Bolagnos/Telemeteria-Bluetooth-Hidronica/Telemetría Hidronica con bluetooth/Photos/IMG_1164.jpg

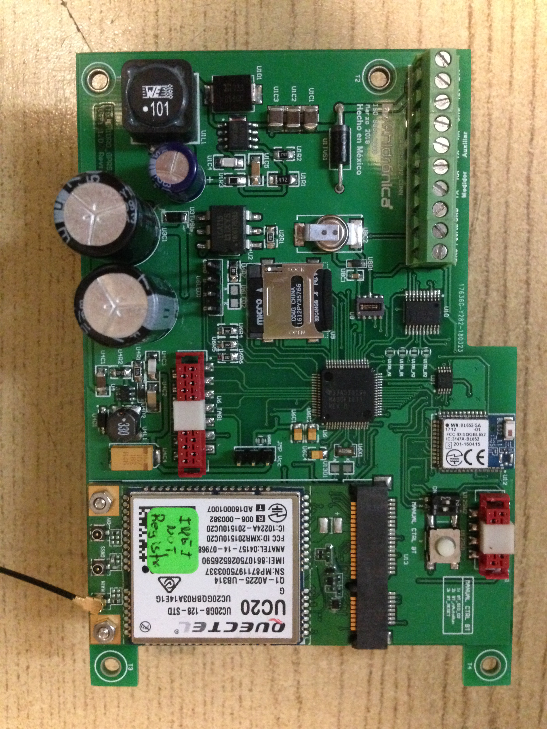
Telemetría Hidronica con bluetooth/Photos/IMG_1164.jpg
