Bolagnos/Telemeteria-Bluetooth-Hidronica/Telemetría Hidronica con bluetooth/Photos/IMG_1166.jpg

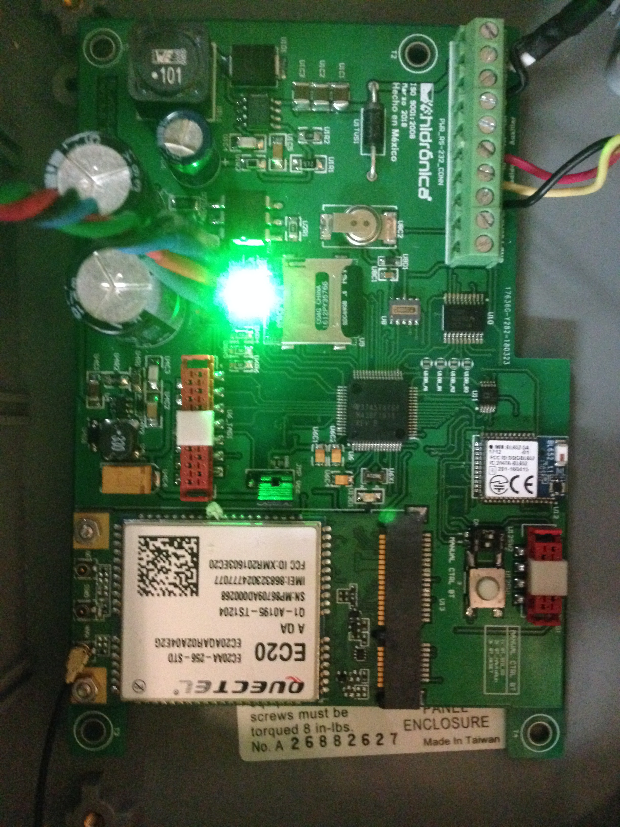
Telemetría Hidronica con bluetooth/Photos/IMG_1166.jpg
