Bolagnos/Telemeteria-Bluetooth-Hidronica/Telemetría Hidronica con bluetooth/Hardware/PCB/Telemetria GPRS Bluetoot MP V1_0 Rev1/Project Outputs for PCB_Tel_GPRS_BT-V1_Rev1/Board Information - TEL-GPRS-BT-V1_0 Rev1.html

Altium customize

# Board Information Report

Date | : | 03/21/2018
Time | : | 11:34:27
Elapsed Time | : | 00:00:00
Filename | : | D:\Documents and Settings\Administrator\Desktop\Telemetria GPRS Bluetoot MP V1_0 Rev1\TEL-GPRS-BT-V1_0 Rev1.PcbDoc
Units | : | mmmils

## Contents

Contents

Board Specification

General

Routing

Routing Information

Layer Information

Layer Information

Layer Pairs

Board Holes

Non-Plated Hole Size

Plated Hole Size

Board Slots

Non-Plated Slot Size

Plated Slot Size

Board Square Holes

Non-Plated Square Hole Size

Plated Square Hole Size

Other

Top Layer Annular Ring Size

Mid Layer Annular Ring Size

Bottom Layer Annular Ring Size

Pad Solder Mask

Pad Paste Mask

Pad Pwr/Gnd Expansion

Pad Relief Conductor Width

Pad Relief Air Gap

Pad Relief Entries

Via Solder Mask

Via Pwr/Gnd Expansion

Track Width

Arc Line Width

Arc Radius

Arc Degrees

Text Height

Text Width

Net Track Width

Net Via Size

## Board Specification

General
Board Size | 117.3012mm x 79.6393mm
Components on board | 129

Back to top

## Routing

Routing Information
Routing completion | 100.00%
Connections | 341
Connections routed | 341
Connections remaining | 0

Back to top

## Layer Information

Layer | Arcs | Pads | Vias | Tracks | Texts | Fills | Regions | ComponentBodies
Top Layer | 0 | 338 | 0 | 680 | 3 | 0 | 428 | 0
Bottom Layer | 0 | 157 | 0 | 514 | 0 | 0 | 388 | 0
Mechanical 1 | 0 | 0 | 0 | 0 | 0 | 0 | 0 | 116
Mechanical 3 | 0 | 0 | 0 | 0 | 0 | 0 | 0 | 0
Mechanical 4 | 0 | 0 | 0 | 0 | 0 | 0 | 0 | 0
Mechanical 5 | 0 | 0 | 0 | 0 | 0 | 0 | 0 | 0
Mechanical 6 | 0 | 0 | 0 | 0 | 0 | 0 | 0 | 0
Mechanical 7 | 0 | 0 | 0 | 0 | 0 | 0 | 0 | 0
Mechanical 8 | 0 | 0 | 0 | 0 | 0 | 0 | 0 | 0
Mechanical 9 | 0 | 0 | 0 | 0 | 0 | 0 | 0 | 0
Mechanical 10 | 0 | 0 | 0 | 0 | 0 | 0 | 0 | 0
Mechanical 11 | 0 | 0 | 0 | 0 | 0 | 0 | 0 | 0
Mechanical 12 | 0 | 0 | 0 | 0 | 0 | 0 | 0 | 0
Mechanical 13 | 2 | 0 | 0 | 24 | 0 | 0 | 0 | 0
Mechanical 14 | 0 | 0 | 0 | 0 | 0 | 0 | 0 | 0
Mechanical 15 | 0 | 0 | 0 | 30 | 0 | 0 | 0 | 0
Mechanical 16 | 0 | 0 | 0 | 0 | 0 | 0 | 0 | 0
Multi-Layer | 0 | 44 | 161 | 0 | 0 | 0 | 1 | 0
Top Paste | 0 | 0 | 0 | 0 | 0 | 0 | 0 | 0
Top Overlay | 35 | 1 | 0 | 1646 | 162 | 0 | 0 | 0
Top Solder | 0 | 0 | 0 | 0 | 0 | 0 | 0 | 0
Bottom Solder | 0 | 0 | 0 | 0 | 0 | 0 | 0 | 0
Bottom Overlay | 10 | 0 | 0 | 390 | 128 | 0 | 0 | 0
Bottom Paste | 0 | 0 | 0 | 0 | 0 | 0 | 0 | 0
Drill Guide | 0 | 0 | 0 | 0 | 0 | 0 | 0 | 0
Keep-Out Layer | 0 | 0 | 0 | 12 | 0 | 0 | 0 | 0
Drill Drawing | 0 | 0 | 0 | 0 | 0 | 0 | 0 | 0
Total | 47 | 540 | 161 | 3296 | 293 | 0 | 817 | 116

Back to top

Layer Pairs | Vias
Top Layer - Bottom Layer | 161
Total | 161

Back to top

## Board Holes

Non-Plated Hole Size | Pads | Vias
0mm | 12 | 0
1.1mm | 1 | 0
1.6mm | 1 | 0
3mm | 4 | 0
Total | 18 | 0

Back to top

Plated Hole Size | Pads | Vias
0mm | 484 | 0
0.25mm | 0 | 159
0.3mm | 9 | 0
0.4mm | 0 | 2
0.7mm | 6 | 0
1mm | 6 | 0
1.2mm | 4 | 0
1.3mm | 10 | 0
1.7mm | 1 | 0
2.6mm | 2 | 0
Total | 522 | 161

Back to top

## Board Slots

Non-Plated Slot Size / Length | Pads
Total | 0

Back to top

Plated Slot Size / Length | Pads
Total | 0

Back to top

## Board Square Holes

Non-Plated Square Hole Size | Pads
Total | 0

Back to top

Plated Square Hole Size | Pads
Total | 0

Back to top

## Other

Top Layer Annular Ring Size | Count
0mm | 4
0.25mm | 153
0.3mm | 9
0.4mm | 3
0.45mm | 5
0.5mm | 4
0.55mm | 1
0.6mm | 6
0.8mm | 2
0.9mm | 10
1mm | 4
1.3mm | 2
3.2mm | 2
Total | 205

Back to top

Mid Layer Annular Ring Size | Count
0mm | 4
0.25mm | 153
0.3mm | 9
0.4mm | 3
0.45mm | 5
0.5mm | 4
0.55mm | 1
0.6mm | 6
0.8mm | 2
0.9mm | 10
1mm | 4
1.3mm | 2
3.2mm | 2
Total | 205

Back to top

Bottom Layer Annular Ring Size | Count
0mm | 4
0.25mm | 153
0.3mm | 9
0.4mm | 3
0.45mm | 5
0.5mm | 4
0.55mm | 1
0.6mm | 6
0.8mm | 2
0.9mm | 10
1mm | 4
1.3mm | 2
3.2mm | 2
Total | 205

Back to top

Pad Solder Mask | Count
0mm | 540
Total | 540

Back to top

Pad Paste Mask | Count
0mm | 540
Total | 540

Back to top

Pad Pwr/Gnd Expansion | Count
0.508mm | 540
Total | 540

Back to top

Pad Relief Conductor Width | Count
0.254mm | 540
Total | 540

Back to top

Pad Relief Air Gap | Count
0.254mm | 540
Total | 540

Back to top

Pad Relief Entries | Count
4 | 540
Total | 540

Back to top

Via Solder Mask | Count
0mm | 161
Total | 161

Back to top

Via Pwr/Gnd Expansion | Count
0.508mm | 161
Total | 161

Back to top

Track Width | Count
0.0254mm | 1317
0.05mm | 4
0.1mm | 46
0.127mm | 25
0.2mm | 121
0.254mm | 84
0.27mm | 935
0.3mm | 34
0.3048mm | 460
0.4mm | 135
0.5mm | 74
0.7mm | 27
1mm | 34
Total | 3296

Back to top

Arc Line Width | Count
0.1mm | 2
0.127mm | 4
0.2mm | 7
0.25mm | 9
0.254mm | 21
0.32mm | 1
0.6mm | 3
Total | 47

Back to top

Arc Radius | Count
0.125mm | 9
0.127mm | 6
0.15mm | 1
0.1625mm | 1
0.25mm | 5
0.3mm | 3
0.3175mm | 2
0.5mm | 2
0.5041mm | 1
0.762mm | 1
0.8mm | 5
3mm | 8
4mm | 1
6.5mm | 2
Total | 47

Back to top

Arc Degrees | Count
90 | 4
180 | 6
360 | 37
Total | 47

Back to top

Text Height | Count
0.5mm | 15
0.7mm | 252
0.8mm | 3
1.5mm | 16
1.524mm | 6
1.7mm | 1
Total | 293

Back to top

Text Width | Count
0.12mm | 10
0.125mm | 1
0.14mm | 1
0.15mm | 252
0.2mm | 23
0.254mm | 6
Total | 293

Back to top

Net Track Width | Count
1916.2949mm | 107
Total | 107

Back to top

Net Via Size | Count
0.5mm | 107
Total | 107

Back to top
