Bolagnos/Telemeteria-Bluetooth-Hidronica/Telemetría Hidronica con bluetooth/Hardware/PCB/USB_Serial Interface/myLibraries/CustomPCBLib.PcbLib.htm

Altium Reporting Options

# File in Newer Format

Date | : | 02/18/19
Time | : | 12:26:04
Filename | : | E:\Trabajo\Logger Tel GPRS MPG2 V_1\Hardware\PCB\USB_Serial Interface\myLibraries\CustomPCBLib.PcbLib

Version | Warning
Release 10 | CAUTION - New Custom Grids and Guides were introduced. Be aware that your design might contain Custom Grids and Guides that cannot be read in previous versions.

This file was generated by a later version of the software
