Bolagnos/Telemeteria-Bluetooth-Hidronica/Telemetría Hidronica con bluetooth/Photos/IMG_1165.jpg

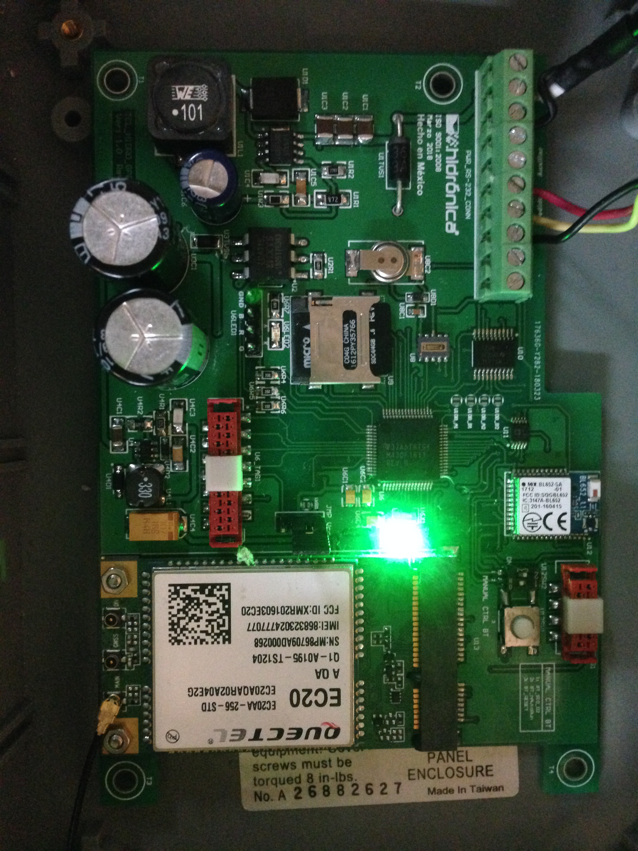
Telemetría Hidronica con bluetooth/Photos/IMG_1165.jpg
