Bolagnos/Telemeteria-Bluetooth-Hidronica/Telemetría Hidronica con bluetooth/Photos/IMG_1167.jpg

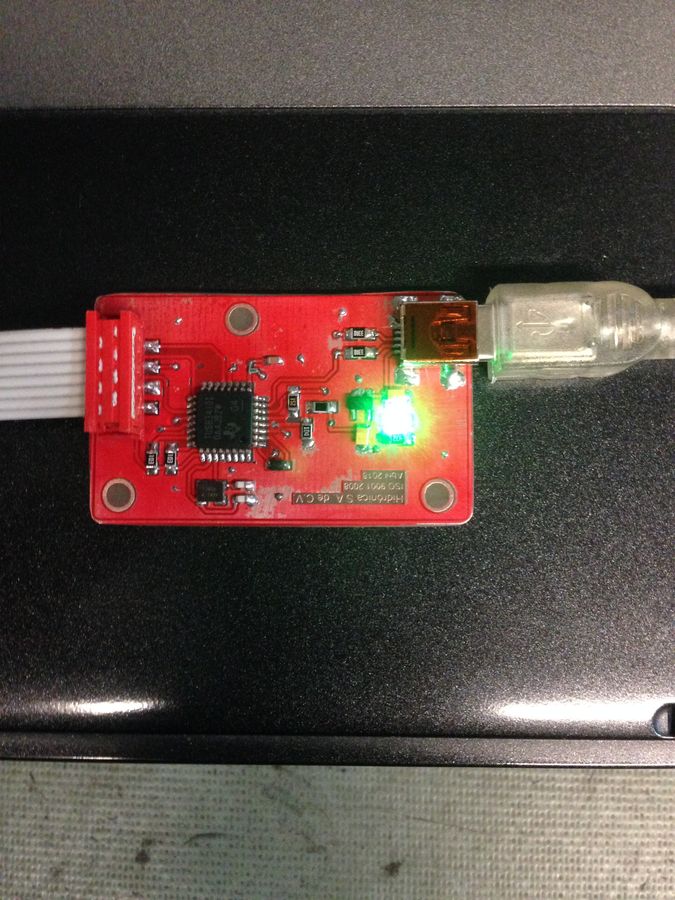
Telemetría Hidronica con bluetooth/Photos/IMG_1167.jpg
