Bolagnos/Telemeteria-Bluetooth-Hidronica/Telemetría Hidronica con bluetooth/Photos/IMG_1168.jpg

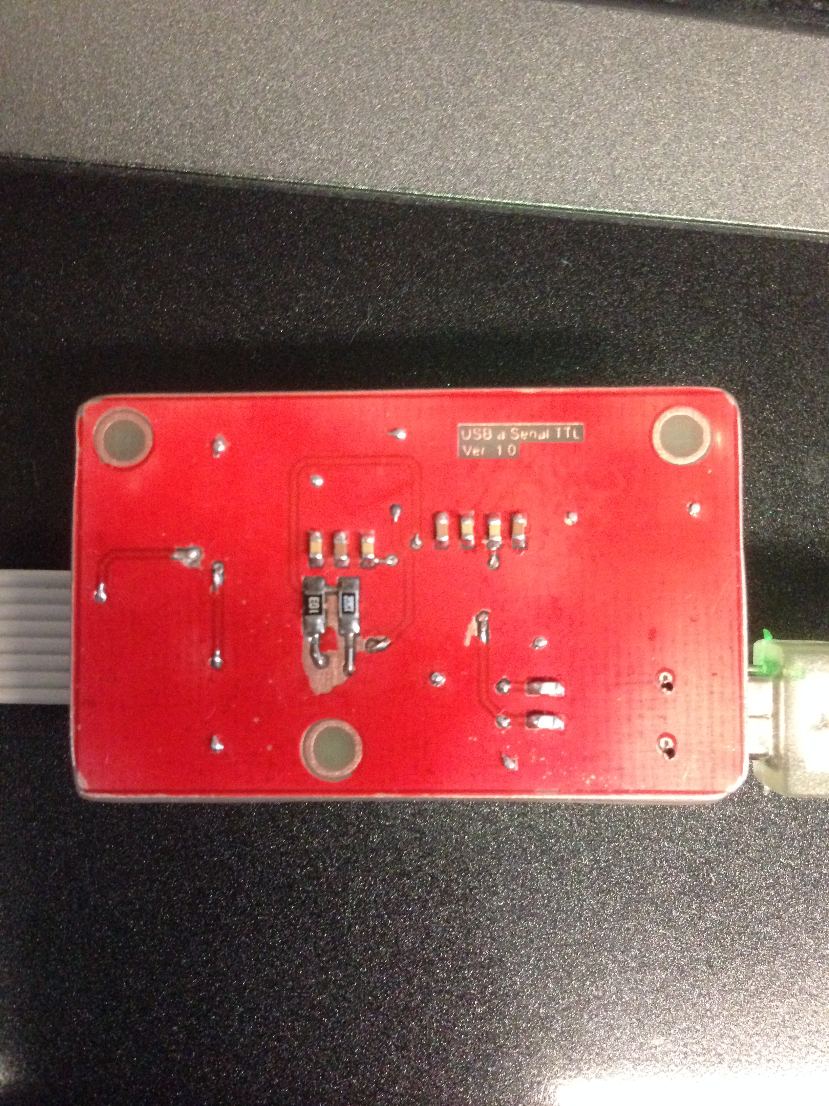
Telemetría Hidronica con bluetooth/Photos/IMG_1168.jpg
