Bolagnos/Telemeteria-Bluetooth-Hidronica/Telemetría Hidronica con bluetooth/Photos/IMG_1169.jpg

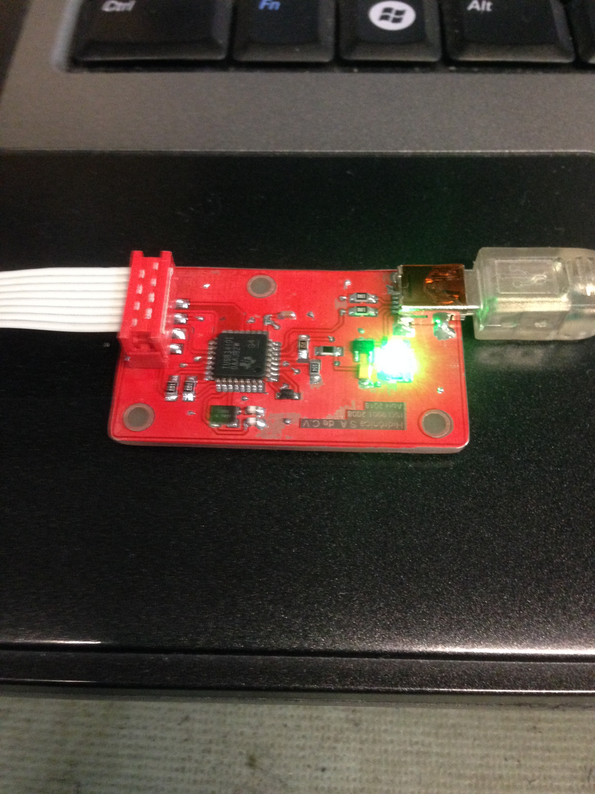
Telemetría Hidronica con bluetooth/Photos/IMG_1169.jpg
