Bolagnos/Telemeteria-Bluetooth-Hidronica/Telemetría Hidronica con bluetooth/Hardware/PCB/Telemetria GPRS Bluetoot MP V1_0 Rev1/Project Outputs for PCB_Tel_GPRS_BT-V1_Rev1/BOM Released/PCB_Tel_GPRS_BT-V1_Rev1.xls

Sheet: Lista de Componentes
Lista de Componentes
Fuente de datos de: |  |  |  |  |  | PCB_Tel_GPRS_BT-V1_Rev1.PrjPcb
Proyecto: |  |  |  |  |  | PCB_Tel_GPRS_BT-V1_Rev1.PrjPcb
Variante: |  |  |  |  |  | None
Fecha de Creacion: |  |  |  |  |  | 03/26/2018
Hora de Creacion: |  |  |  |  |  | 13:25:18
Numero de Equipos:
Manufacturer Part Number | Value | Supplier 1 | Supplier Part Number 1 | Supplier 2 | Supplier Part Number 2 | Supplier 3 | Supplier Part Number 3 | Designator | Description | Quantity | Total Quantity | Total
CHS-02TA |  | Digi-Key | 563-1005-1-ND |  |  |  |  | U12SW2 | SWITCH SLIDE DIP SPST 100MA 6V | 1 | 0 | #REF!
 |  |  |  |  |  |  |  | SP1, SP2, SP3, SP4, T1, T2, T3, T4, U6B1, U10B_A1, U10B_A2, U10B_B1, U10B_B2 | No Aplica | 13 | 0 | #REF!
EVQ-Q2K03W |  | Digi-Key | P12943SCT-ND |  |  |  |  | U12SW1 | SWITCH TACTILE SPST-NO 0.02A 15V SMT | 1 | 0 | #REF!
T491A106K010AT | 10uF | Digi-Key | 399-3684-1-ND |  |  |  |  | U12C1 | CAP TANTALUM 10UF 6.3V 10% SMD | 1 | 0 | #REF!
ERJ-6GEYJ472V | 4.7KO | Digi-Key | P4.7KACT-ND |  |  |  |  | U12R1, U12R2, U12R3, U12R4, U12R5, U12R6, U12R7 | RES SMD 4.7K OHM 5% 1/8W 0805 | 7 | 0 | #REF!
ADG836YRMZ |  | Digi-Key | ADG836YRMZ-ND |  |  |  |  | U11 | IC SWITCH DUAL SPDT 10MSOP | 1 | 0 | #REF!
BL652-SA-01-T/R |  | Digi-Key | BL652-SA-01-CT-ND | Mouser | 239-BL652-SA-01 | Newark | 01AC1558 | U12 | LAIRD BLUETOOTH MODULE (BLE) | 1 | 0 | #REF!
C0603C224K4RAC7867 | 0.22uF | Digi-Key | 399-5619-1-ND |  |  |  |  | U5C1 | CAP CER 0.22UF 16V 10% X7R 0603 | 1 | 0 | #REF!
CL31B224KBFNNNE | 0.22uF | Digi-Key | 1276-1106-1-ND |  |  |  |  | U4C2 | CAP CER 0.22UF 50V 10% X7R 1206 | 1 | 0 | #REF!
ERJ-6ENF1201V | 1.2KO | Digi-Key | P1.20KCCT-ND |  |  |  |  | U2R1 | RES SMD 1.2K OHM 1% 1/8W 0805 | 1 | 0 | #REF!
ERJ-P06J104V | 100KO | Digi-Key | P100KADCT-ND |  |  |  |  | U6R1, U6R3 | RES SMD 100K OHM 5% 1/2W 0805 | 2 | 0 | #REF!
T495D107K016AHE125 | 100uF | Digi-Key | 399-8498-1-ND |  |  |  |  | U4C4 | CAP TANT 100UF 16V 10% 2917 | 1 | 0 | #REF!
CRCW080510M0JNEA | 10MO | Digi-Key | 541-10MACT-ND |  |  |  |  | U5R3 | VISHAY CRCW080510M0JNEA Resistencia SMD Chip, Película Gruesa, 10 Mohm, 150 V, 0805 [2012 Metric], 125 mW, ± 5% | 1 | 0 | #REF!
C1206C100K5GACTU | 10pF | Digi-Key | 399-9297-1-ND |  |  |  |  | U4C3 | CAP CER 10PF 50V 10% NP0 1206 | 1 | 0 | #REF!
CC1210ZKY5V9BB106 | 10uF | Digi-Key | 311-3470-1-ND | Mouser | 603-CC121ZKY5V9BB106 |  |  | U1C1, U1C2, U1C3 | CAP CER 10UF 50V Y5V 1210 | 3 | 0 | #REF!
ERA-6AEB105V | 1MO | Digi-Key | P1MDACT-ND |  |  |  |  | U4R1 | RES SMD 1M OHM 0.1% 1/8W 0805 | 1 | 0 | #REF!
CRCW08051M00FKEA | 1MO | Digi-Key | 541-1.00MCCT-ND | Newark | 52K9759 |  |  | U5R2 | VISHAY CRCW08051M00FKEB Resistencia SMD Chip, Película Gruesa, 1 Mohm, 150 V, 0805 [2012 Metric], 125 mW, ± 1% | 1 | 0 | #REF!
UMK316BJ225KD-T | 2.2uF | Digi-Key | 587-2402-1-ND |  |  |  |  | U4C1 | CAP CER 2.2UF 50V 10% X5R 1206 | 1 | 0 | #REF!
CRCW08052K70FKEA | 2.7KO | Digi-Key | 541-2.70KCCT-ND |  |  |  |  | U1R2 | RES 2.70K OHM 1/8W 1% 0805 SMD | 1 | 0 | #REF!
SMF18A-E3-08 |  | Digi-Key | SMF18A-E3-08CT-ND |  |  |  |  | U3TVS1 | TVS DIODE 18V 29.2V SMF | 1 | 0 | #REF!
DSK-3R3H224U-HL | 220mF | Digi-Key | 604-1020-1-ND |  |  |  |  | U8C2 | CAP 220MF -20% +80% 3.3V SMD | 1 | 0 | #REF!
C1206C221K5GACTU | 220pF | Digi-Key | 399-1208-1-ND |  |  |  |  | U1C4 | CAP CERAMIC 220PF 50V NP0 1206 | 1 | 0 | #REF!
C1206C223K5RACTU | 22nF | Digi-Key | 399-1242-1-ND |  |  |  |  | U1C5 | CAP 22000PF 50V CERAMIC X7R 1206 | 1 | 0 | #REF!
ERA-6AEB3162V | 24KO | Digi-Key | P31.6KDACT-ND |  |  |  |  | U1R3 | RES SMD 31.6K OHM 0805 | 1 | 0 | #REF!
ERJ-6GEYJ332V | 3.3KO | Digi-Key | P3.3KACT-ND |  |  |  |  | U6R4, U6R5, U6R6 | RES SMD 3.3K OHM 5% 1/8W 0805 | 3 | 0 | #REF!
FC-135 32.768KA-A3 |  | Digi-Key | SE2413CT-ND |  |  |  |  | U6X1 | CRYSTAL 32.7680KHZ 12.5PF SMD -40°C ~ 85°C | 1 | 0 | #REF!
P6KE33A |  | Digi-Key | P6KE33ALFCT-ND |  |  |  |  | U1TVS1 | TVS 33 VOLT 600 WATT UNI-DIR TRANZORB | 1 | 0 | #REF!
RC0603JR-07390RL | 390O | Digi-Key | 311-390GRCT-ND |  |  |  |  | U5R4 | YAGEO RC0603JR-07390RL Resistencia SMD Chip, Película Gruesa, Serie RC, 390 ohm, 50 V, 0603 [1608 Metric], 100 mW, ± 5% | 1 | 0 | #REF!
CRCW08054M22FKEA | 4.22MO | Digi-Key | 541-4.22MCCT-ND | Mouser | 71-CRCW08054M22FKEA | Newark | 53K0223 | U5R1 | VISHAY CRCW08054M22FKEA Resistencia SMD Chip, Película Gruesa, 4.22 Mohm, 150 V, 0805 [2012 Metric], 125 mW, ± 1% | 1 | 0 | #REF!
CRCW12064K70JNEA | 4.7KO | Digi-Key | 541-4.7KECT-ND |  |  |  |  | U1R1 | RES 4.7K OHM 1/4W 5% 1206 SMD | 1 | 0 | #REF!
ESY477M050AL3AA | 470uF | Digi-Key | 399-6129-ND |  |  |  |  | U3C1, U3C2 | 470µF 50V Aluminum Capacitors Radial, Can 27 mOhm @ 100kHz 5000 Hrs @ 105°C | 2 | 0 | #REF!
RT0805BRD07604KL | 604KO | Digi-Key | YAG1941CT-ND |  |  |  |  | U4R2 | RES SMD 604K OHM 0.1% 1/8W 0805 | 1 | 0 | #REF!
ERJ-6GEYJ821V | 820O | Digi-Key | P820ACT-ND | Newark | 65T8844 |  |  | U6R7, U13R2 | PANASONIC ELECTRONIC COMPONENTS ERJ-6GEYJ821V Resistencia SMD Chip, Película Gruesa, 820 ohm, 150 V, 0805 [2012 Metric], 125 mW, ± 5% | 2 | 0 | #REF!
CAT24M01WI-GT3 |  | Digi-Key | CAT24M01WI-GT3OSCT-ND |  |  |  |  | U7 | IC EEPROM 1MBIT 1MHZ 8SOIC I2C | 1 | 0 | #REF!
CMDSH-3 TR |  | Digi-Key | CMDSH-3 CT-ND |  |  |  |  | U4D2 | DIODE SCHOTTKY 30V 100MA SOD323 | 1 | 0 | #REF!
DZ2J030M0L |  | Digi-Key | DZ2J030M0LCT-ND |  |  |  |  | U5D1 | PANASONIC ELECTRONIC COMPONENTS DZ2J030M0L DIODE, ZENER, 3.0V, SMINI2-F5-B | 1 | 0 | #REF!
L5973ADTR |  | Digi-Key | 497-5328-1-ND |  |  |  |  | U1 | IC REG SW 2A STEPDOWN 8-SOIC | 1 | 0 | #REF!
LCA715STR |  | Digi-Key | CLA309CT-ND | Mouser | 849-LCA715STR |  |  | U2 | RELAY OPTOMOS 1.8A SPST-NO 6-SMD | 1 | 0 | #REF!
LM1085ISX-3.3/NOPB |  | Digi-Key | LM1085ISX-3.3/NOPBCT-ND |  |  |  |  | U3 | Linear Voltage Regulator IC Positive Fixed 1 Output 3.3V 3A DDPAK/TO-263-3 | 1 | 0 | #REF!
MBR0540-TP |  | Digi-Key | MBR0540TPMSCT-ND |  |  |  |  | U4D1 | DIODE SCHOTTKY 40V 500MA SOD123 | 1 | 0 | #REF!
2041119-1 |  | Digi-Key | A108265CT-ND |  |  |  |  | U13 | Mini PCIe | 1 | 0 | #REF!
MSP430F1611IPM |  | Digi-Key | 296-17205-ND |  |  |  |  | U6 | IC MCU 16BIT 48K FLASH 64-LQFP | 1 | 0 | #REF!
LT1934 |  | Digi-Key | LT1934ES6#TRMPBFCT-ND |  |  |  |  | U4 | LINEAR TECHNOLOGY LT1934 IC REG BUCK ADJ 0.3A SOT23-6 | 1 | 0 | #REF!
SN75C3223EPWR |  | Digi-Key | 296-21078-1-ND |  |  |  |  | U10 | IC LINE DRVR/RCVR RS232 20-TSSOP | 1 | 0 | #REF!
B340-13-F |  | Digi-Key | B340-FDICT-ND |  |  |  |  | U1D2 | DIODE SCHOTTKY 40V 3A SMC | 1 | 0 | #REF!
B560C-13-F |  | Digi-Key | B560C-FDICT-ND |  |  |  |  | U1D1 | DIODE SCHOTTKY 60V 5A SMC | 1 | 0 | #REF!
RC0805JR-0710KL | 10KO | Digi-Key | 311-10KARCT-ND |  |  |  |  | U6R2, U7R1, U7R2, U8R1, U8R2, U8R3, U9R1, U9R2, U9R3, U9R4, U9R5, U9R6, U13R1, U13R3 | 10 kOhms ±5% 0.125W, 1/8W Chip Resistor 0805 | 14 | 0 | #REF!
TAJR105K010RNJ | 1uF | Digi-Key | 478-3278-1-ND |  |  |  |  | U6C1, U6C2, U6C3, U6C4, U12C2 | AVX - TACU105M016X - CAP TANT 1UF, 16V, 7.5OHM, 0805 | 5 | 0 | #REF!
NSR0320MW2T1G |  | Digi-Key | NSR0320MW2T1GOSCT-ND |  |  |  |  | U8D1, U12D1, U12D2 | DIODE SCHOTTKY 1A 20V SOD-323 | 3 | 0 | #REF!
0786463001 |  | Digi-Key | WM9364CT-ND | Mouser | 538-78646-3001 |  |  | U14_A | '6 Position Card Connector Micro SIM Surface Mount, Right Angle Gold | 1 | 0 | #REF!
ERJ-6ENF1502V | 15KO | Digi-Key | P15.0KCCT-ND |  |  |  |  | U14R1 | RES SMD 15K OHM 1% 1/8W 0805 | 1 | 0 | #REF!
ERJ-6ENF22R0V | 22O | Digi-Key | P22.0CCT-ND |  |  |  |  | U14R2, U14R3, U14R4 | RES SMD 22 OHM 1% 1/8W 0805 | 3 | 0 | #REF!
C0805C330J5GACTU | 33pF | Digi-Key | 399-1115-1-ND |  |  |  |  | U14C2, U14C3, U14C4, U14C5 | 33pF 50V Ceramic Capacitor C0G, NP0 0805 (2012 Metric) 0.079" L x 0.049" W (2.00mm x 1.25mm) | 4 | 0 | #REF!
7111S2015X02LF |  | Digi-Key | 609-1401-1-ND |  |  |  |  | U14_B | 6 Position Card Connector SIM Card Surface Mount, Right Angle Gold | 1 | 0 | #REF!
SMF05C.TCT |  | Digi-Key | SMF05CCT-ND |  |  |  |  | U14TVS1 | TVS DIODE 5V 12.5V SC70-6 | 1 | 0 | #REF!
CGJ3E2X7R1E104K080AA | 0.1uF | Digi-Key | 445-8129-1-ND |  |  |  |  | U6C5, U7C1, U8C1, U9C1, U10C1, U10C2, U10C3, U10C4, U10C5, U11C1, U14C1 | CAP CERAMIC 0.1UF, 25V, X7R, 0603 | 11 | 0 | #REF!
RV-3029-C2 |  | Newark | 19P2786 | Mouser | 428-202115-MG01 |  |  | U8 | MICRO CRYSTAL - RV-3029-C2 OPTION B - REAL-TIME-CLOCK, SMD, I2C, 32.768KHZ | 1 | 0 | #REF!
7X-1.8432MBC-T |  | Newark | 29X6515 |  |  |  |  | U6X2 | 7X-1.8432MBC-T - Oscilador, 1.8432 MHz, 100 ppm, SMD, 5mm x 3.2mm, CMOS, 3.3 V, Serie 7X | 1 | 0 | #REF!
ECA-1EM331B | 330uF | Newark | 48W7648 | Mouser | 667-ECA-1EM331B |  |  | U1C6 | Capacitor | 1 | 0 | #REF!
L-154A4SURKQBDZGW |  | Newark | 66W1973 |  |  |  |  | U6LED1 | KINGBRIGHT L-154A4SURKQBDZGW LED, RGB, Rojo, Verde, Azul, Through Hole, T-1 3/4 (5mm), 60 °, Abovedada, R 20mA, G 20mA, B 20mA, Common Cathode | 1 | 0 | #REF!
690 367 290 876 |  | Wurth Elektronik | 690 367 290 876 |  |  |  |  | U12TAG1 | Female SMT Straight Connector with Latch and with Polarization WR-MM 8-Pin | 1 | 0 | #REF!
690 157 001 472 |  | Wurth Elektronik | 690 157 001 472 |  |  |  |  |  | Male IDC Connector 14 POS | 1 | 0 | #REF!
74477020 | 100µH | Wurth Elektronik | 74477020 |  |  |  |  | U1L1 | WE-PD SMD Shielded Power Inductor 100uH | 1 | 0 | #REF!
784774133 | 33µH | Wurth Elektronik | 784774133 |  |  |  |  | U4L1 | WE-PD2A SMD Power Inductor | 1 | 0 | #REF!
613 003 111 21 |  | Wurth Elektronik | 613 003 111 21 |  |  |  |  | JMP Vcc | 2.54mm THT Pin Header WR-PHD 3 terminales | 1 | 0 | #REF!
690 367 291 476 |  | Wurth Elektronik | 690 367 291 476 |  |  |  |  | U6_TAG1 | Female SMT Straight Connector with Latch and with Polarization WR-MM 14-Pin | 1 | 0 | #REF!
74279214 | 450 mO | Wurth Elektronik | 74279214 | Digi-Key | 732-1627-1-ND |  |  | U10L1, U10L2, U10L3, U10L4 | FERRITE BEAD 1000 OHM .20A 1206 | 4 | 0 | #REF!
150080GS75000 |  | Wurth Elektronik | 150080GS75000 | Digi-Key | 732-4983-1-ND | Newark | 95W3800 | U6LED2, U13D1 | WL-SMCW SMD mono-color chip LED waterclear 0805 Green | 2 | 0 | #REF!
691214110002 |  | Wurth Elektronik | 691214110002 | Digi-Key | 732-2747-ND |  |  | PWR_RS-232_CONN A | 2 Position Wire to Board Terminal Block Horizontal with Board 0.200" (5.08mm) Through Hole | 2 | 0 | #REF!
691214110003 |  | Wurth Elektronik | 691214110003 | Digi-Key | 732-2748-ND |  |  | PWR_RS-232_CONN B | 3 Position Wire to Board Terminal Block Horizontal with Board 0.200" (5.08mm) Through Hole | 2 | 0 | #REF!
693072010801 |  | Wuth Elekronik | 693072010801 | Digi-Key | 732-3820-1-ND |  |  | U9 | WR-CRD Micro SD_Hinge / CONN MICRO SD CARD HINGED TYPE | 1 | 0 | #REF!
EC20 mini PCIe |  | Quectel | EC20 miniPCI |  |  |  |  | Modem GSM | Modem GSM/EDGE/GPRS | 1 | 0 | #REF!
CAB.011 |  | Digi-Key | 931-1098-ND |  |  |  |  | Cable Assembly Coaxial SMA to MHF1 Female to Female 1.13mm OD Coaxial Cable 3.74" (95.00mm) |  | 1 | 0 | #REF!
PN-1327-MB |  | Digi-Key | 377-1884-ND |  |  |  |  | 'BOX PLASTIC GRAY 6.73"L X 4.76"W - Box with Mounting Flange Plastic, Polycarbonate Gray Cover Included 6.732" L x 4.764" W (170.99mm x 121.01mm) X 3.150" (80.00mm) |  | 1 | 0 | #REF!
ALPHA1A/2.5M/SMAM/S/S/11 |  | Digi-Key | ALPHA1A/2.5M/SMAM/S/S/11-ND |  |  |  |  | 'ANT BAR SMA MALE ADHESIVE MNT - 868MHz, 900MHz, 915MHz, 950MHz, 1.8GHz, 1.9GHz, 2.1GHz, 2.4GHz Bluetooth, GPRS, GSM, UMTS, WLAN, Zigbee™ Flat Bar RF Antenna 3.8dBi Connector, SMA Male Adhesive |  | 1 | 0 | #REF!
EN3C4FX |  | Digi-Key | SC253-ND |  |  |  |  | 'CONN PLUG 4POS FEMALE CORD #20 - 4 Position Circular Connector Plug, Female Sockets Solder Cup Gold |  | 1 | 0 | #REF!
4304MC |  | Newark | 66F5952 |  |  |  |  | CHICAGO MINIATURE LIGHTING 4304MC Clip para LED, 5.33 mm x 5.33 mm, Negro, Plástico, LEDs Domo Alto T-1 |  | 1 | 0 | #REF!
M26 PRA2MCS100- |  | Newark | 53M8646 |  |  |  |  | DURATOOL M26 PRA2MCS100- Tornillo, M2, Steel, 6 mm, Zinc, Pozidriv Cabeza Alomada |  | 2 | 0 | #REF!
M2- HFA2-S100- |  | Newark | 53M8631 |  |  |  |  | DURATOOL M2- HFA2-S100- Tuerca, Hexagonal, M2, Acero, Recubrimiento de Zinc, Paquete de 100 |  | 2 | 0 | #REF!
Conector Glandula Gris |  |  |  |  |  |  |  |  |  | 3 | 0 | #REF!
53019010 |  | Newark | 26M7490 |  |  |  |  | LAPP KABEL 53019010 Tuerca de Bloqueo, Skintop® GMP-GL, Gris, Nylon, PG9, 5 mm |  | 3 | 0 | #REF!
31622002LPK50 |  | Newark | 10C2404 |  |  |  |  | HUBBELL WIRING DEVICES 31622002LPK50 Tuerca de Bloqueo, No Metálico, Nylon, 3/8 |  | 3 | 0 | #REF!
Tonillo M3 x 25mm. Cabeza hexagonal |  | Casa del Tornillo |  |  |  |  |  | Tornillo M3 con un largo de 25 mm con caneza hezagonal |  | 4 | 0 | #REF!
Tonillo M3 x 10mm. Cabeza hexagonal |  | Casa del Tornillo |  |  |  |  |  | Tornillo M3 con un largo de 10 mm con caneza hezagonal |  | 4 | 0 | #REF!
Tonillo M3 x 8mm. Cabeza hexagonal |  | Casa del Tornillo |  |  |  |  |  | Tornillo M3 con un largo de 8 mm con caneza hezagonal |  | 1 | 0 | #REF!
Tonillo M3 x 5m. Cabeza hexagonal |  | Casa del Tornillo |  |  |  |  |  | Tornillo M3 con un largo de 5 mm con caneza hezagonal |  | 4 | 0 | #REF!
Tuerca M3 de acero inoxidable |  | Casa del Tornillo |  |  |  |  |  | Tuerca M3 de acero inoxidable |  | 22 | 0 | #REF!
 |  |  |  |  |  |  |  |  |  | 190 |  | #REF!
Approved |  |  |  |  |  |  | Notes

Sheet: Informacion del Proyecto
Ruta del Proyecto | D:\Documents and Settings\Administrator\Desktop\Telemetria GPRS Bluetoot MP V1_0 Rev1\PCB_Tel_GPRS_BT-V1_Rev1.PrjPcb
Nombre del Archivo del proyecto | PCB_Tel_GPRS_BT-V1_Rev1.PrjPcb
Nombre del Archivo de datos Fuente | PCB_Tel_GPRS_BT-V1_Rev1.PrjPcb
Ruta Completa del Archivo de Datos Fuente | D:\Documents and Settings\Administrator\Desktop\Telemetria GPRS Bluetoot MP V1_0 Rev1\PCB_Tel_GPRS_BT-V1_Rev1.PrjPcb
Titulo | Bill of Materials For Project [PCB_Tel_GPRS_BT-V1_Rev1.PrjPcb] (No PCB Document Selected)
Cantidad Total | 132
Hora del Reporte | 13:25:18
Fecha del Reporte | 03/26/2018
Hora y Fecha del Reporte | 03/26/2018 13:25:18
Nombre de salida | Bill of Materials
Tipo de Salida | BOM_PartType
Nombre del Generador de Salida | BOM
Descripcion del generador de salida | Bill of Materials
