Bolagnos/Telemeteria-Bluetooth-Hidronica/Telemetría Hidronica con bluetooth/Hardware/PCB/USB_Serial Interface/Project Outputs for USB_Serial Interface/BOM Released/USB_Serial Interface.xls

Sheet: Lista de Componentes
Lista de Componentes
Fuente de datos de: |  |  |  |  |  | USB_Serial Interface.PrjPcb
Proyecto: |  |  |  |  |  | USB_Serial Interface.PrjPcb
Variante: |  |  |  |  |  | None
Fecha de Creacion: |  |  |  |  |  | 03/26/2018
Hora de Creacion: |  |  |  |  |  | 13:33:41
Numero de Equipos:
Manufacturer Part Number | Value | Supplier 1 | Supplier Part Number 1 | Supplier 2 | Supplier Part Number 2 | Supplier 3 | Supplier Part Number 3 | Designator | Description | Quantity | Total Quantity | Total
0603YC102KAT2A | 0.001µF | Digi-Key | 478-7933-1-ND |  |  |  |  | C10, C14 | CAP CER 1000PF 16V X7R 0603 | 2 | 0 | #REF!
C0603C103K4RACTU | 0.01µF | Digi-Key | 399-7841-1-ND |  |  |  |  | C9, C12 | CAP CER 10000PF 16V X7R 0603 | 2 | 0 | #REF!
CGJ3E2X7R1E104K080AA | 0.1uF | Digi-Key | 445-8129-1-ND |  |  |  |  | C1, C8, C11, C13 | CAP CERAMIC 0.1UF, 25V, X7R, 0603 | 4 | 0 | #REF!
ESR10EZPJ152 | 1.5KO | Digi-Key | RHM1.5KKCT-ND |  |  |  |  | R6 | RES SMD 1.5K OHM 5% 0.4W 0805 | 1 | 0 | #REF!
ERA-6AEB104V | 100KO | Digi-Key | P100KDACT-ND |  |  |  |  | R5 | RES SMD 100K OHM 0.1% 1/8W 0805 | 1 | 0 | #REF!
TAJR105K010RNJ | 1uF | Digi-Key | 478-3278-1-ND |  |  |  |  | C6 | CAP TANT 1UF 10V 10% 0805 | 1 | 0 | #REF!
C0603C220K3GACTU | 22pF | Digi-Key | 399-9030-1-ND |  |  |  |  | C4, C5 | CAP CER 22PF 25V C0G/NP0 0603 | 2 | 0 | #REF!
TNPW040232K0BEED | 32KO | Digi-Key | 541-2115-1-ND |  |  |  |  | R2 | RES 32K OHM 0.1% 1/10W 0402 | 1 | 0 | #REF!
06031A330FAT2A | 33pF | Digi-Key | 478-3688-1-ND |  |  |  |  | C2, C3 | CAP CER 33PF 100V C0G/NP0 0603 | 2 | 0 | #REF!
RC0805JR-074K7L | 4.7KO | Digi-Key | 311-4.7KARCT-ND |  |  |  |  | R11 | RES SMD 4.7K OHM 5% 1/8W 0805 | 1 | 0 | #REF!
TAJR475K010RNJ | 4.7uF | Digi-Key | 478-3280-1-ND |  |  |  |  | C7 | CAP TANT 4.7UF 10V 10% 0805 | 1 | 0 | #REF!
NSR0320MW2T1G |  | Digi-Key | NSR0320MW2T1GOSCT-ND |  |  |  |  | D1 | DIODE SCHOTTKY 1A 20V SOD-323 | 1 | 0 | #REF!
RC0805JR-0710KL | 10KO | Digi-Key | 311-10KARCT-ND |  |  |  |  | R3, R9, R10 | 10 kOhms ±5% 0.125W, 1/8W Chip Resistor 0805 | 3 | 0 | #REF!
ERJ-PB6B1502V | 15KO | Digi-Key | P20726CT-ND |  |  |  |  | R1 | RES SMD 15K OHM 0.1% 1/4W 0805 | 1 | 0 | #REF!
RC0805FR-0733RL | 33O | Digi-Key | 311-33.0CRCT-ND |  |  |  |  | R7, R8 | RES SMD 33 OHM 1% 1/8W 0805 | 2 | 0 | #REF!
ERA-6AEB9092V | 90.9KO | Digi-Key | P90.9KDACT-ND |  |  |  |  | R4 | RES SMD 90.9K OHM 0.1% 1/8W 0805 | 1 | 0 | #REF!
TUSB3410IVF |  | Digi-Key | 296-16757-ND |  |  |  |  | U1 | TUSB3410 | 1 | 0 | #REF!
CX3225GB12000P0HPQCC | 12 MHz | Digi-Key | 1253-1168-1-ND |  |  |  |  | X1 | CRYSTAL 12.0000MHZ 18PF SMD | 1 | 0 | #REF!
TPS76933DBVT |  | Newark | 77C1165 | Digi-Key | 296-2760-1-ND |  |  | U2 | Linear Voltage Regulator IC Positive Fixed 1 Output 3.3V 100mA SOT-23-5 | 1 | 0 | #REF!
65100516121 |  | Wurth Elektronik | 65100516121 | Digi-Key | 732-2109-1-ND |  |  | J1 | Mini USB 2.0 Type B SMT Horizontal 5 Contacts WR-COM | 1 | 0 | #REF!
690 367 290 876 |  | Wurth Elektronik | 690 367 290 876 |  |  |  |  | U12TAG1 | Female SMT Straight Connector with Latch and with Polarization WR-MM 8-Pin | 1 | 0 | #REF!
690 157 000 872 |  | Wurth Elektronik | 690 157 000 872 |  |  |  |  |  | Male IDC Connector 8 POS | 2 | 0 | #REF!
150080GS75000 |  | Wurth Elektronik | 150080GS75000 | Digi-Key | 732-4983-1-ND | Newark | 95W3800 | U13D1 | WL-SMCW SMD mono-color chip LED waterclear 0805 Green | 1 | 0 | #REF!
 |  |  |  |  |  |  |  |  |  | 34 |  | #REF!
Approved |  |  |  |  |  |  | Notes

Sheet: Informacion del Proyecto
Ruta del Proyecto | D:\Documents and Settings\Administrator\Desktop\USB_Serial Interface\USB_Serial Interface.PrjPcb
Nombre del Archivo del proyecto | USB_Serial Interface.PrjPcb
Nombre del Archivo de datos Fuente | USB_Serial Interface.PrjPcb
Ruta Completa del Archivo de Datos Fuente | D:\Documents and Settings\Administrator\Desktop\USB_Serial Interface\USB_Serial Interface.PrjPcb
Titulo | Bill of Materials For Project [USB_Serial Interface.PrjPcb] (No PCB Document Selected)
Cantidad Total | 32
Hora del Reporte | 13:33:41
Fecha del Reporte | 03/26/2018
Hora y Fecha del Reporte | 03/26/2018 13:33:41
Nombre de salida | Bill of Materials
Tipo de Salida | BOM_PartType
Nombre del Generador de Salida | BOM
Descripcion del generador de salida | Bill of Materials
