Bolagnos/Telemeteria-Bluetooth-Hidronica/Telemetría Hidronica con bluetooth/Lista IMEI Telemetrías.xls

 | IMEI | Telemetria No. Ser. | id_medidor | fk_id_tubo | fk_id_report | fk_id_email | fk_id_dns | modelo | tipo | no_serie | titulo_correo
 | 353270040003263 | 2201130002 | 4 | 602 | 7 | 1 | 4 | Accusonic | Ultrasonico | x | Prueba GPRS Accusonic 2
5554361199 | 353270040003214 | 2201130001 | 3 | 601 | 7 | 1 | 3 | Accusonic | Ultrasonico | x | Prueba GPRS Accusonic 1
5554334164 | 353270040003057 | 2201130000 | 1 | 600 | 7 | 1 | 2 | Accusonic | Ultrasonico | x | Prueba GPRS Accusonic 0
5520918446 | 353270040003248 | 2001110000 | 2 | 603 | 0 | 2 | 5 | Milltronics OCM III | Ultrasonico | x | Prueba GPRS Milltronics OCM III 0
 | Unkonwn | 2101130001 | 5 | 604 | 1 | 4 |  | MPG2 | Propela | x | Prueba GPRS MPG2 1
 | 353270040003263 | 2001130001 | 6 | 603 | 0 | 2 | 5 | Milltronics OCM III | Ultrasonico | x | Prueba GPRS Milltronics OCM III 1 (Eliminar Registro)
 | Unknown | 2201130003 | 7 | 605 | 7 | 1 | 1 | Accusonic Extra | Ultrasonico | x | Prueba GPRS Accusonic 3 (Eliminar Registro)
5548334651 | 353270042980195 | 2702150002 | 8 | 605 | 1 | 4 |  | MPG2 Batt | Propela | x | Prototipo GPRS V2 Batt MPG2 Pruebas
5548485687 | 353270043085911 | 2801150000 | 9 | 0000 | 1 | 3 |  | AT600 | Ultrasonico | x | AT-600 0 GPRS
5550752453 | 353270043085788 | 2801150001 | 10 | 0001 | 1 | 3 |  | AT600 | Ultrasonico | x | AT-600 1 GPRS
5548454061 | 353270043085507 | 2801150002 | 11 | 0002 | 1 | 3 |  | AT600 | Ultrasonico | x | AT-600 2 GPRS
5578452277 | 861075024034290 | 2702170000 | 12 | 10 | 1 | 3 |  | MPG2 V2 | Propela Silleta | x | GPRS MP V2_0 Nayarit
5578452278 | 868323024781749 | 2702170001 | 13 | 11 | 1 | 3 |  | MPG2 V2 | Propela Silleta | x | GPRS MP V2_1 Nayarit
5578452276 | 861075024033052 | 2702170002 | 14 | 12 | 1 | 6 |  | MPG2 V2 | Propela Silleta | x | RMK GPRS
5578452279 | 868323024783679 | 2702170003 | 15 | 13 | 1 | 5 |  | MPG2 V2 | Propela Silleta | x | La Joya GPRS
 |  | id_dns_client | dns_ip | port_ip | name_client
 |  | 1 | dr025.leeslab.com.mx | 4124 | LeesLab Server DR 025 -4124
 |  | 2 | dr025.leeslab.com.mx | 600 | LeesLab Server DR 025 -600
 |  | 3 | dr025.leeslab.com.mx | 601 | LeesLab Server DR 025 -601
 |  | 4 | dr025.leeslab.com.mx | 602 | LeesLab Server DR 025 -602
 |  | 5 | dr025.leeslab.com.mx | 603 | LeesLab Server DR 025 -603
SIM’s | No. Telefono
 | 5554361199
 | 5554334164
 | 5520918446
 | 5548334651
