Bolagnos/Telemeteria-Bluetooth-Hidronica/Telemetría Hidronica con bluetooth/Hardware/Gabinete PN-1327-MB/Conector glandula/PG9/assem glandula1.SLDASM

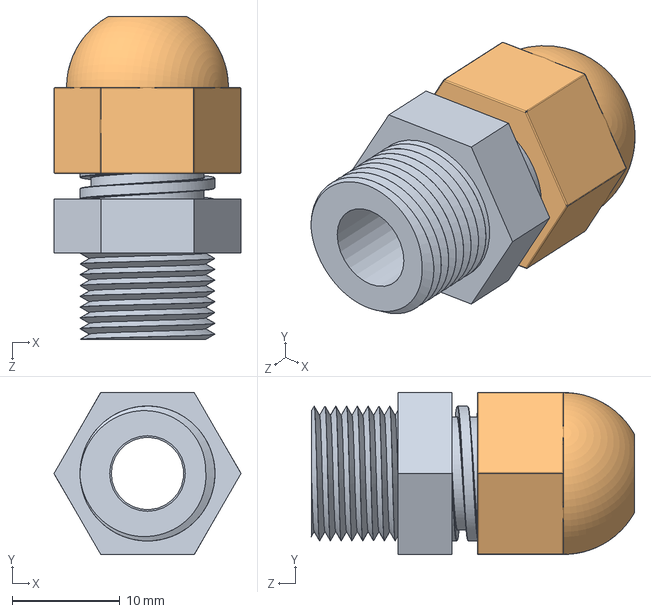
[picture p7: CAD file, 2020-08-14]
Telemetría Hidronica con bluetooth/Hardware/Gabinete PN-1327-MB/Conector glandula/PG9/assem glandula1.SLDASM
17.3 x 15.0 x 29.9 mm
PG07_1
PG07_2
