Bolagnos/Telemeteria-Bluetooth-Hidronica/Telemetría Hidronica con bluetooth/Hardware/Gabinete PN-1327-MB/Conector glandula/assem glandula1 con cable.SLDASM

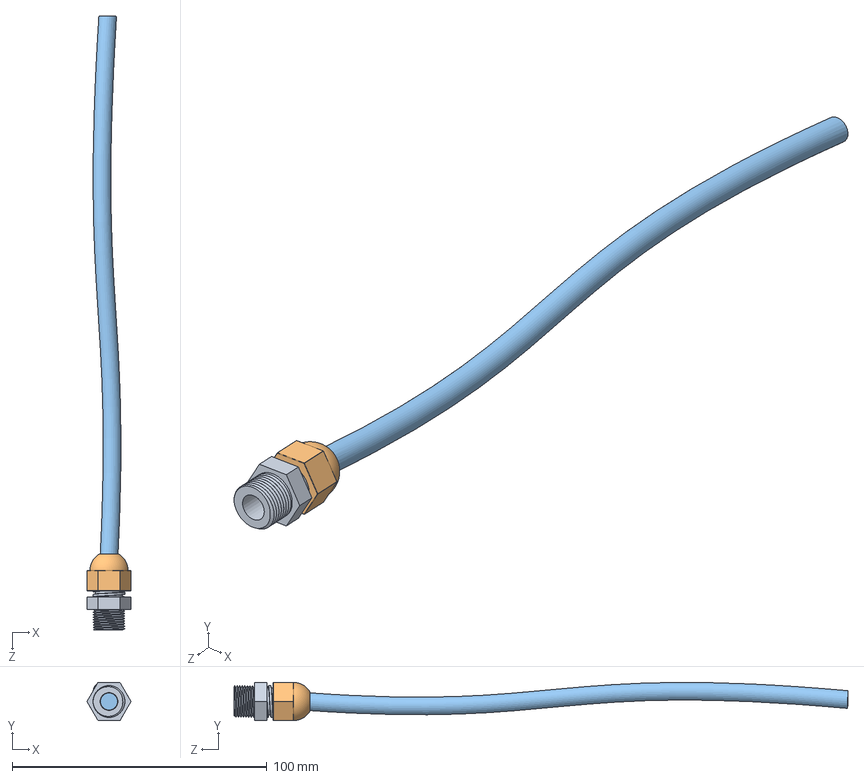
[picture p8: CAD file, 2020-08-14]
Telemetría Hidronica con bluetooth/Hardware/Gabinete PN-1327-MB/Conector glandula/assem glandula1 con cable.SLDASM
17.3 x 15.0 x 241.1 mm
PG07_1
PG07_2
cable antena
