Bolagnos/Telemeteria-Bluetooth-Hidronica/Telemetría Hidronica con bluetooth/Hardware/Gabinete PN-1327-MB/Assemble.SLDASM

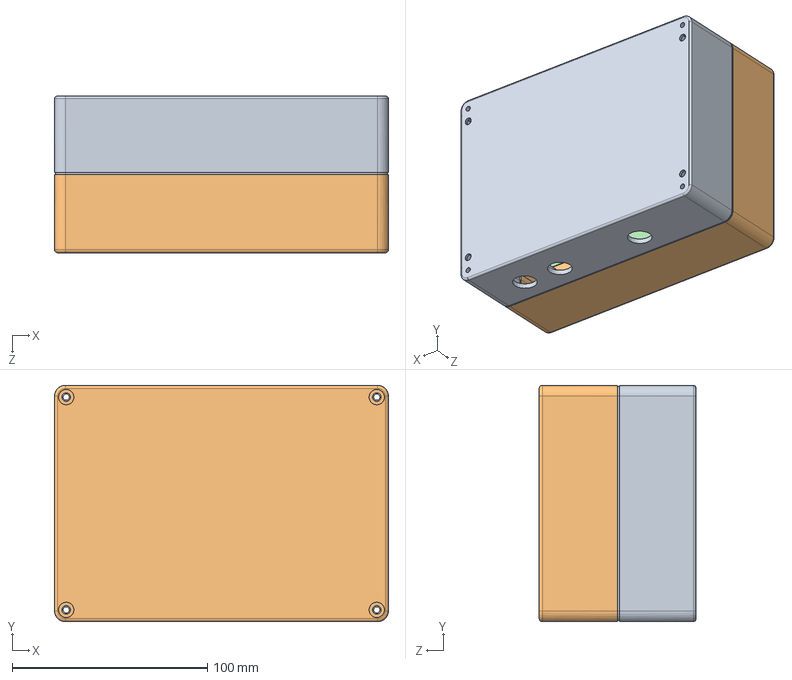
[picture p9: CAD file, 2020-08-14]
Telemetría Hidronica con bluetooth/Hardware/Gabinete PN-1327-MB/Assemble.SLDASM
171.0 x 121.0 x 80.2 mm
Base
Support antenna connector
Board
Battery_Pack
Base_I
