Bolagnos/Telemeteria-Bluetooth-Hidronica/Telemetría Hidronica con bluetooth/Hardware/Gabinete PN-1327-MB/Base_I.SLDPRT

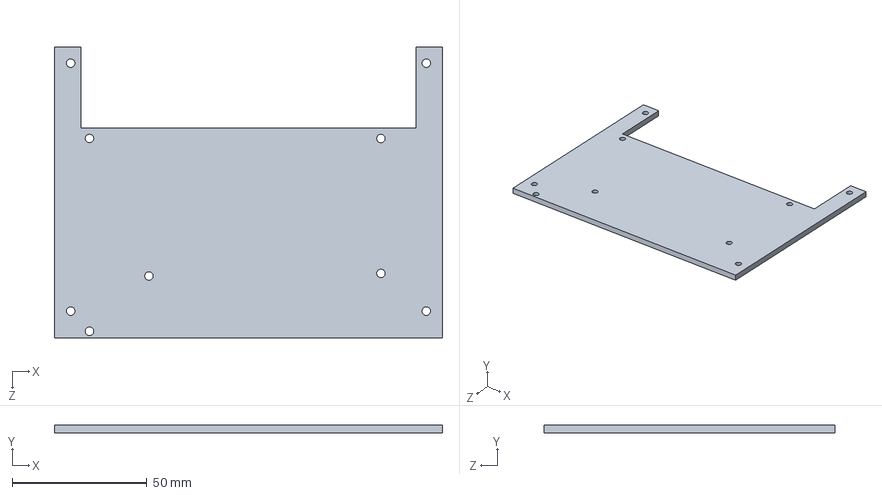
[picture p10: CAD file, 2020-08-14]
Telemetría Hidronica con bluetooth/Hardware/Gabinete PN-1327-MB/Base_I.SLDPRT
143.8 x 3.00 x 107.8 mm
