Bolagnos/Telemeteria-Bluetooth-Hidronica/Telemetría Hidronica con bluetooth/Hardware/Gabinete PN-1327-MB/Conector glandula/PG7/PG7 Cable Gland.stp

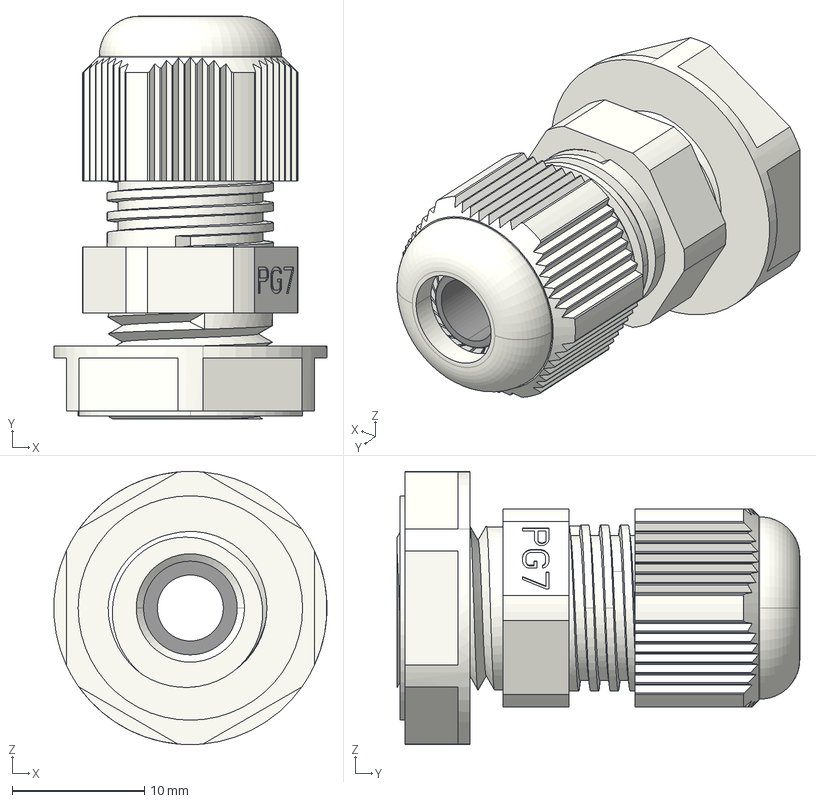
[picture p11: CAD file, 2020-08-14]
Telemetría Hidronica con bluetooth/Hardware/Gabinete PN-1327-MB/Conector glandula/PG7/PG7 Cable Gland.stp
20.7 x 30.5 x 20.7 mm
