Bolagnos/Telemeteria-Bluetooth-Hidronica/Telemetría Hidronica con bluetooth/Hardware/Gabinete PN-1327-MB/Conector glandula/PG9/PG09_1.SLDPRT

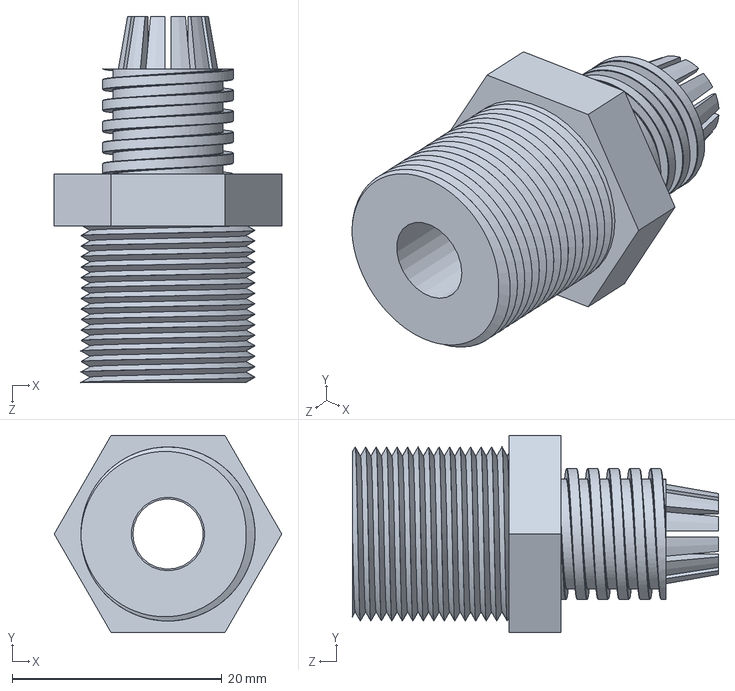
[picture p12: CAD file, 2020-08-14]
Telemetría Hidronica con bluetooth/Hardware/Gabinete PN-1327-MB/Conector glandula/PG9/PG09_1.SLDPRT
21.7 x 18.8 x 34.9 mm
