Bolagnos/Telemeteria-Bluetooth-Hidronica/Telemetría Hidronica con bluetooth/Hardware/Gabinete PN-1327-MB/Conector glandula/S2138-NPT3-4_1.SLDPRT

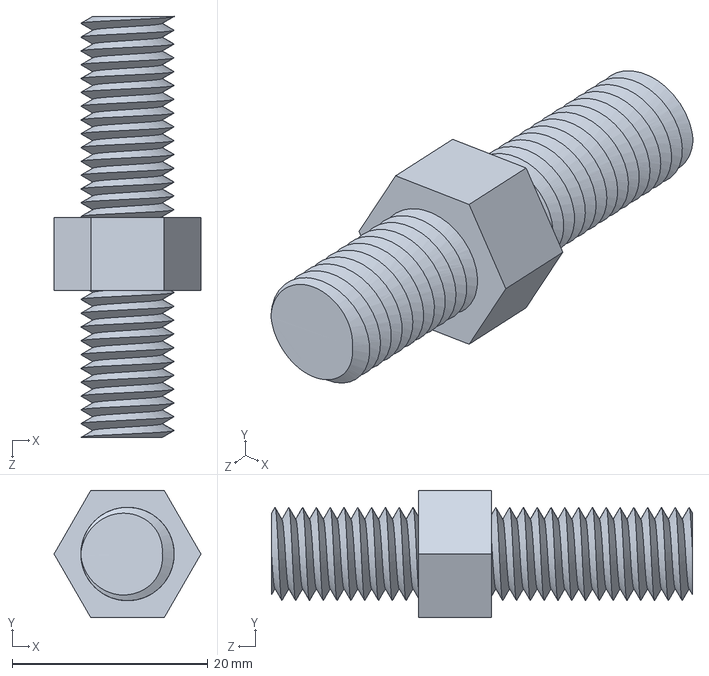
[picture p13: CAD file, 2020-08-14]
Telemetría Hidronica con bluetooth/Hardware/Gabinete PN-1327-MB/Conector glandula/S2138-NPT3-4_1.SLDPRT
15.0 x 13.0 x 43.0 mm
