Bolagnos/Telemeteria-Bluetooth-Hidronica/Telemetría Hidronica con bluetooth/Hardware/PCB/Telemetria GPRS Bluetoot MP V1_0 Rev1/Local Library/BL652 3D Device/BL652 A1 Pad.SLDPRT

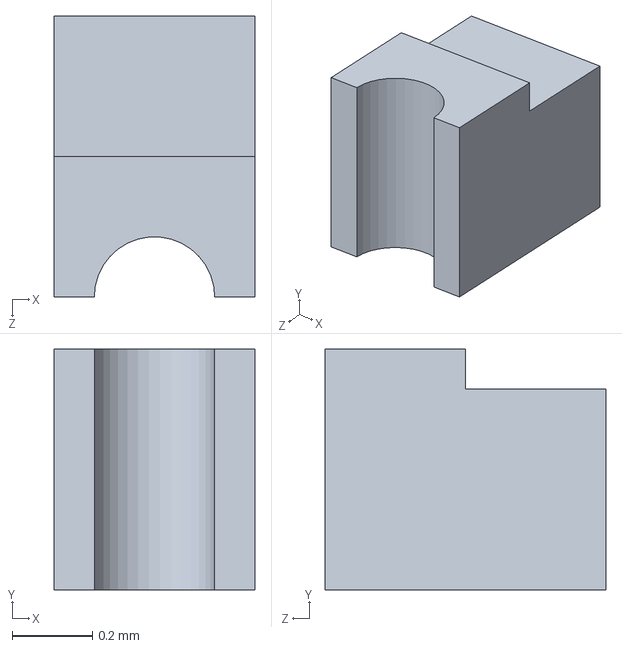
[picture p14: CAD file, 2020-08-14]
Telemetría Hidronica con bluetooth/Hardware/PCB/Telemetria GPRS Bluetoot MP V1_0 Rev1/Local Library/BL652 3D Device/BL652 A1 Pad.SLDPRT
0.5 x 0.6 x 0.7 mm
