Bolagnos/Telemeteria-Bluetooth-Hidronica/Telemetría Hidronica con bluetooth/Hardware/PCB/USB_Serial Interface/myLibraries/BL652 3D Device/BL652 Antenna.SLDPRT

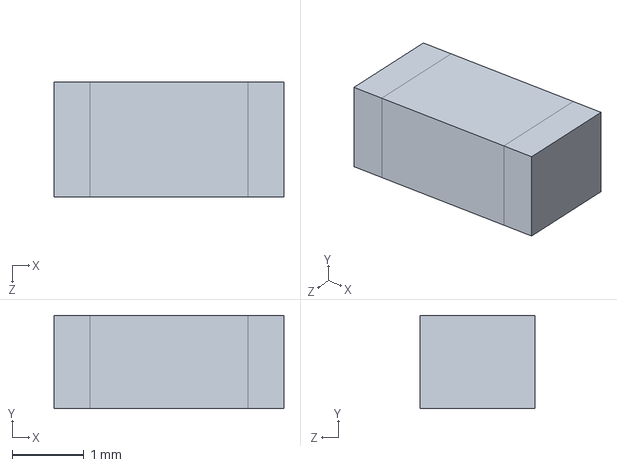
[picture p15: CAD file, 2020-08-14]
Telemetría Hidronica con bluetooth/Hardware/PCB/USB_Serial Interface/myLibraries/BL652 3D Device/BL652 Antenna.SLDPRT
3.20 x 1.30 x 1.60 mm
