Bolagnos/Telemeteria-Bluetooth-Hidronica/Telemetría Hidronica con bluetooth/Hardware/Gabinete PN-1327-MB/Electronic Parts/BL652_SA_A1.SLDPRT

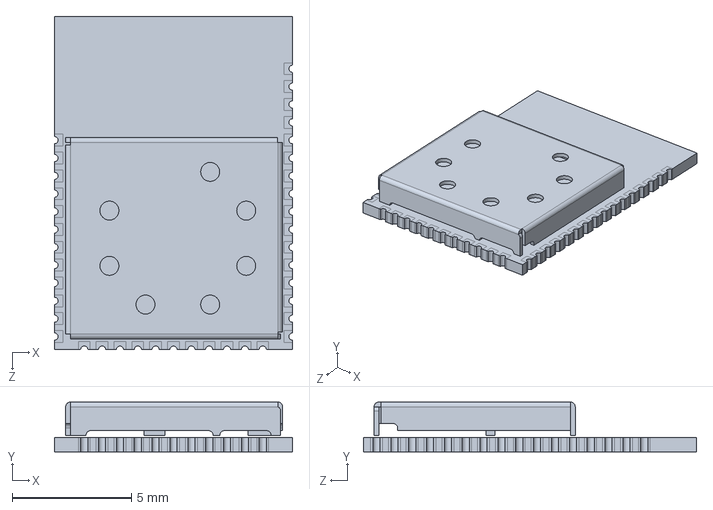
[picture p16: CAD file, 2020-08-14]
Telemetría Hidronica con bluetooth/Hardware/Gabinete PN-1327-MB/Electronic Parts/BL652_SA_A1.SLDPRT
10.0 x 2.10 x 14.0 mm
