Bolagnos/Telemeteria-Bluetooth-Hidronica/Telemetría Hidronica con bluetooth/Hardware/Gabinete PN-1327-MB/Support antenna connector.SLDPRT

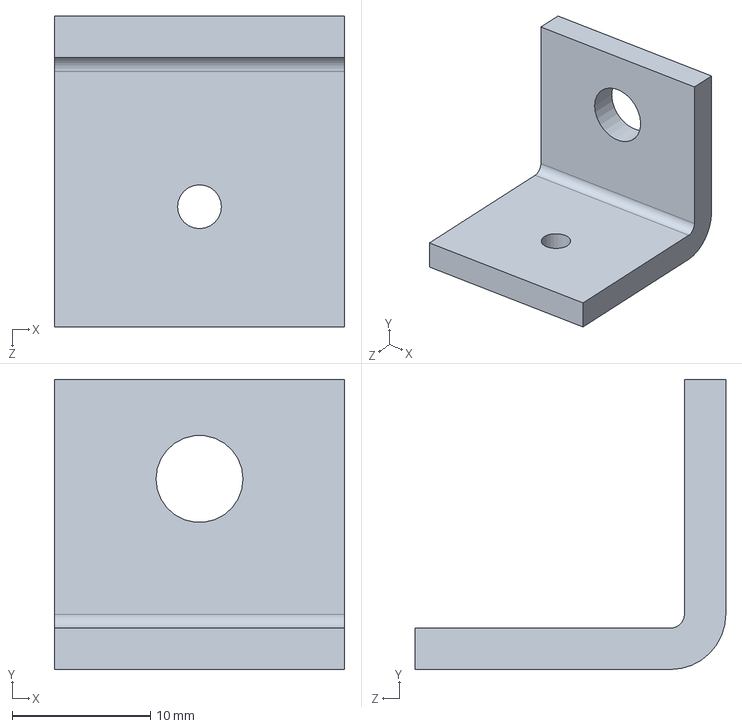
[picture p17: CAD file, 2020-08-14]
Telemetría Hidronica con bluetooth/Hardware/Gabinete PN-1327-MB/Support antenna connector.SLDPRT
21.0 x 21.0 x 22.5 mm
