Bolagnos/Telemeteria-Bluetooth-Hidronica/Telemetría Hidronica con bluetooth/Hardware/Gabinete PN-1327-MB/Conector glandula/PG9/PG09_2.SLDPRT

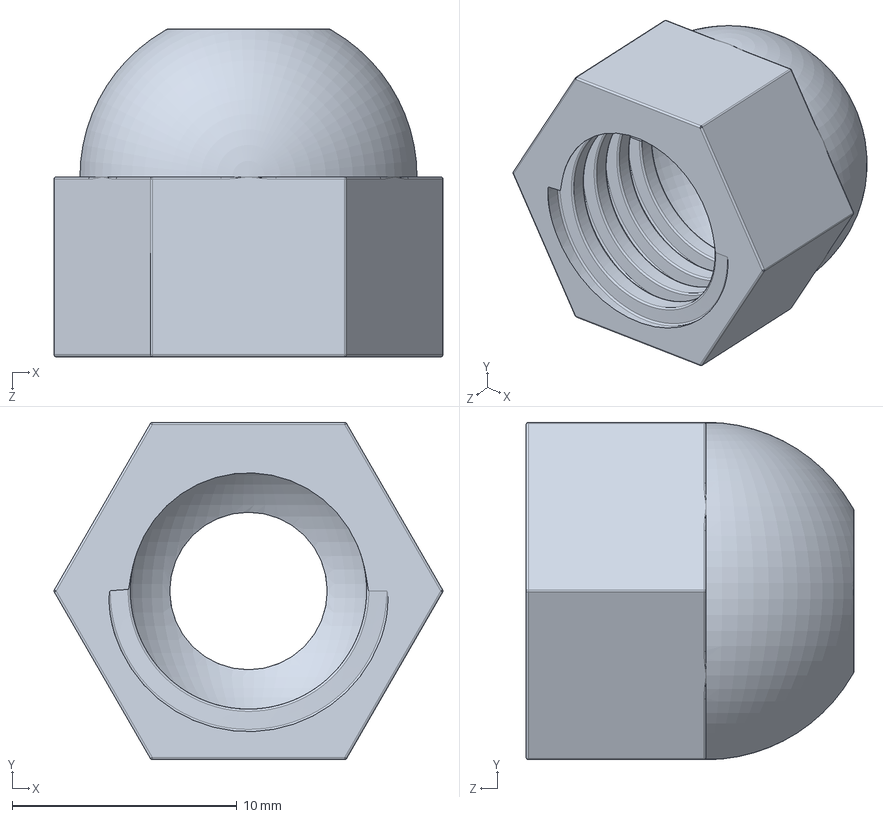
[picture p18: CAD file, 2020-08-14]
Telemetría Hidronica con bluetooth/Hardware/Gabinete PN-1327-MB/Conector glandula/PG9/PG09_2.SLDPRT
17.3 x 15.0 x 14.6 mm
