Bolagnos/Telemeteria-Bluetooth-Hidronica/Telemetría Hidronica con bluetooth/Hardware/Gabinete PN-1327-MB/Electronic Parts/Board.sldprt

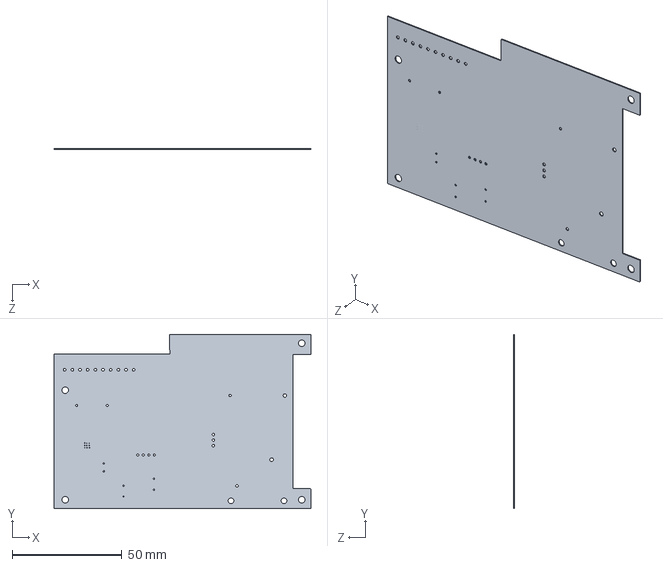
[picture p19: CAD file, 2020-08-14]
Telemetría Hidronica con bluetooth/Hardware/Gabinete PN-1327-MB/Electronic Parts/Board.sldprt
117.3 x 79.7 x 0.411 mm
