Bolagnos/Telemeteria-Bluetooth-Hidronica/Telemetría Hidronica con bluetooth/Hardware/PCB/Telemetria GPRS Bluetoot MP V1_0 Rev1/Local Library/BL652 3D Device/BL652_SA_A1.STEP

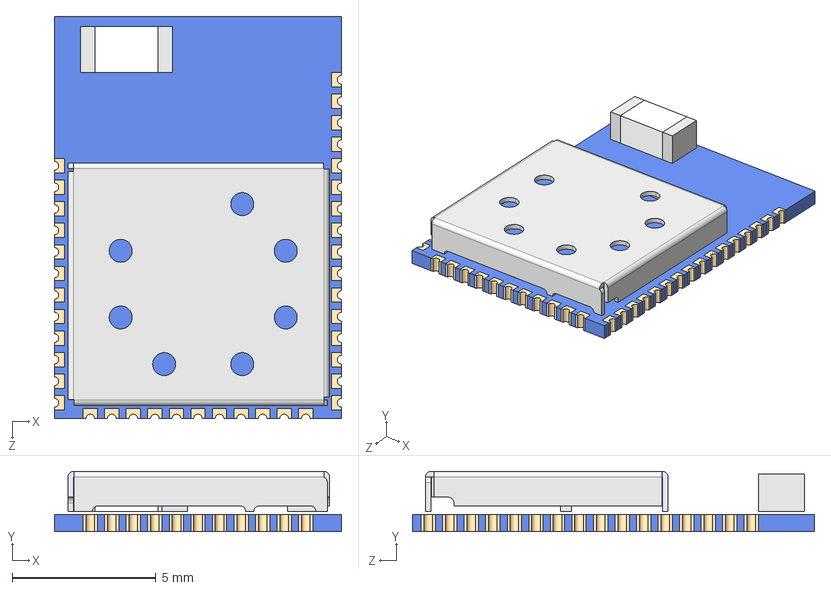
[picture p21: CAD file, 2020-08-14]
Telemetría Hidronica con bluetooth/Hardware/PCB/Telemetria GPRS Bluetoot MP V1_0 Rev1/Local Library/BL652 3D Device/BL652_SA_A1.STEP
10.0 x 2.10 x 14.0 mm
BL652 A1 PCB
BL652 A1 Pad x 39
shielding_bl652_b0_20160622
BL652 Antenna
