Bolagnos/Telemeteria-Bluetooth-Hidronica/Telemetría Hidronica con bluetooth/Hardware/PCB/USB_Serial Interface/myLibraries/BL652 3D Device/BL652 A1 PCB.SLDPRT

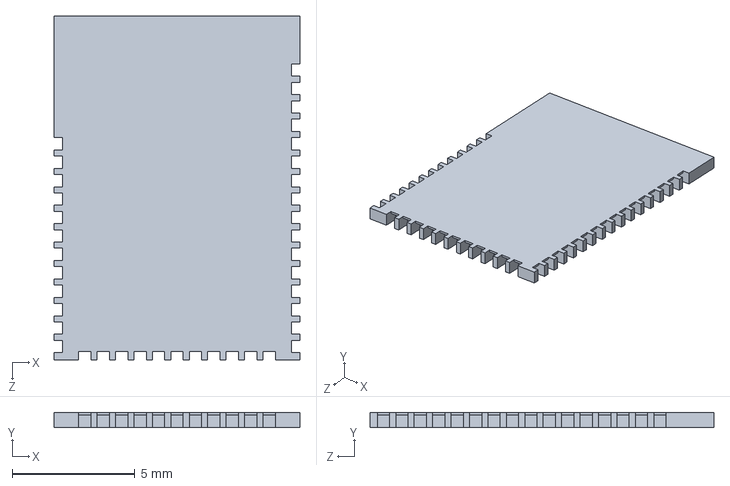
[picture p22: CAD file, 2020-08-14]
Telemetría Hidronica con bluetooth/Hardware/PCB/USB_Serial Interface/myLibraries/BL652 3D Device/BL652 A1 PCB.SLDPRT
10.0 x 0.6 x 14.0 mm
