Bolagnos/Telemeteria-Bluetooth-Hidronica/Telemetría Hidronica con bluetooth/Hardware/Gabinete PN-1327-MB/Battery_Pack.SLDPRT

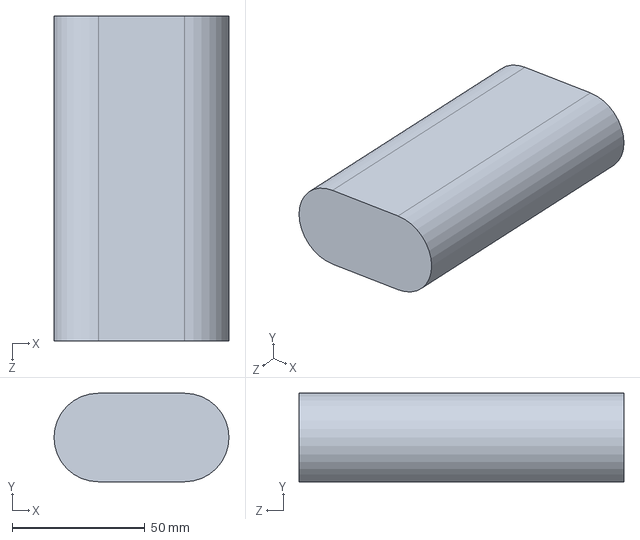
[picture p23: CAD file, 2020-08-14]
Telemetría Hidronica con bluetooth/Hardware/Gabinete PN-1327-MB/Battery_Pack.SLDPRT
66.0 x 33.4 x 122.5 mm
