Bolagnos/Telemeteria-Bluetooth-Hidronica/Telemetría Hidronica con bluetooth/Hardware/PCB/Telemetria GPRS Bluetoot MP V1_0 Rev1/Local Library/BL652 3D Device/shielding_bl652_b0_20160622.SLDPRT

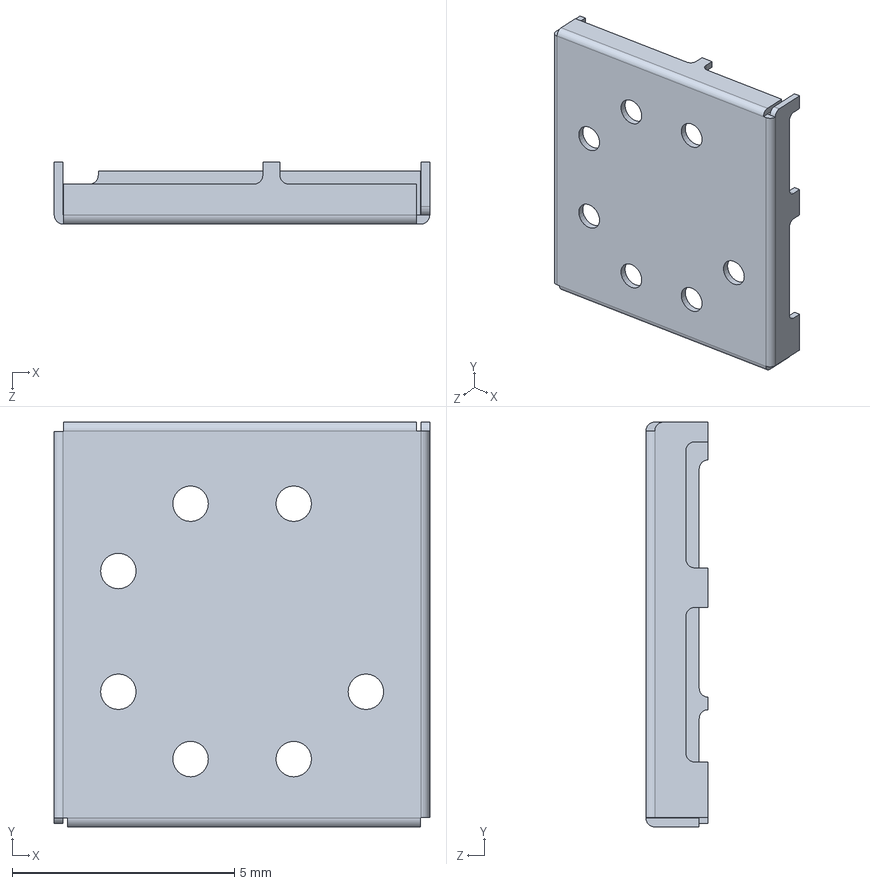
[picture p24: CAD file, 2020-08-14]
Telemetría Hidronica con bluetooth/Hardware/PCB/Telemetria GPRS Bluetoot MP V1_0 Rev1/Local Library/BL652 3D Device/shielding_bl652_b0_20160622.SLDPRT
8.45 x 9.12 x 1.40 mm
