Bolagnos/Telemeteria-Bluetooth-Hidronica/Telemetría Hidronica con bluetooth/Hardware/Gabinete PN-1327-MB/Suppor Base Transversal.SLDPRT

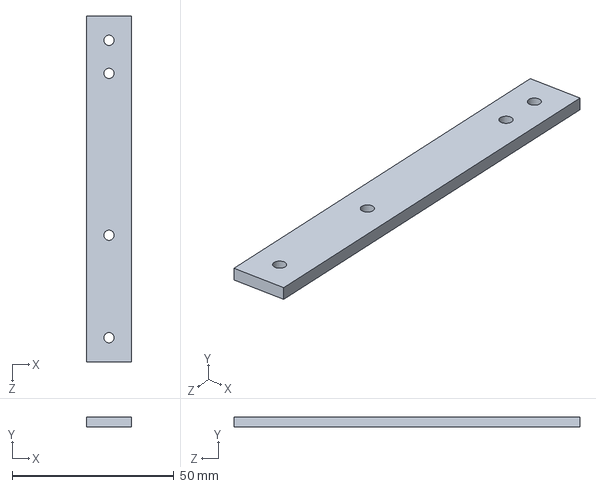
[picture p26: CAD file, 2020-08-14]
Telemetría Hidronica con bluetooth/Hardware/Gabinete PN-1327-MB/Suppor Base Transversal.SLDPRT
14.0 x 3.00 x 106.9 mm
