Bolagnos/Telemeteria-Bluetooth-Hidronica/Telemetría Hidronica con bluetooth/Hardware/Gabinete PN-1327-MB/B005UPNSOU_3D.SLDPRT

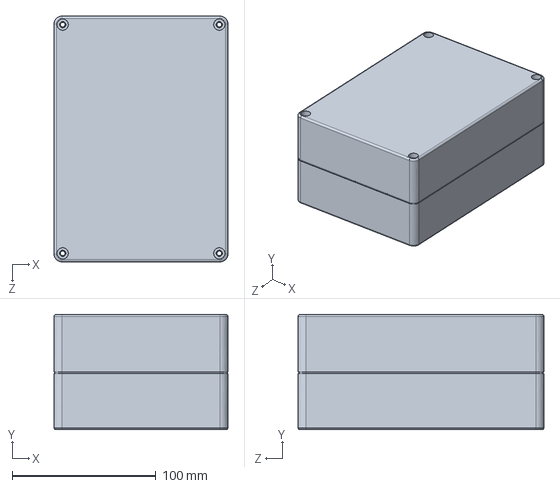
[picture p29: CAD file, 2020-08-14]
Telemetría Hidronica con bluetooth/Hardware/Gabinete PN-1327-MB/B005UPNSOU_3D.SLDPRT
121.0 x 80.2 x 171.0 mm
