Bolagnos/Telemeteria-Bluetooth-Hidronica/(list of files, cad)

Other CAD files:
Telemetría Hidronica con bluetooth/Hardware/Gabinete PN-1327-MB/Base_I.SLDDRW
Telemetría Hidronica con bluetooth/Hardware/Gabinete PN-1327-MB/Electronic Parts/693072010801(SIM).sldasm
Telemetría Hidronica con bluetooth/Hardware/PCB/Telemetria GPRS Bluetoot MP V1_0 Rev1/Local Library/BL652 3D Device/BL652_SA_A1.SLDASM
Telemetría Hidronica con bluetooth/Hardware/PCB/USB_Serial Interface/myLibraries/BL652 3D Device/BL652_SA_A1.SLDASM
