Bolagnos/Telemeteria-Bluetooth-Hidronica/Telemetría Hidronica con bluetooth/Referencias Tecnicas/Pruebas logging/Logger test 18 Aug 2017.txt

01/01/2017,00:00:02,25.02,0086605.51252,C,F..
01/01/2017,00:02:00,25.01,0086608.50093,C,F..
01/01/2017,00:04:00,25.02,0086611.43078,C,F..
01/01/2017,00:06:00,25.01,0086614.41362,C,F..
01/01/2017,00:08:00,25.01,0086617.39925,C,F..
01/01/2017,00:10:00,25.01,0086620.38488,C,F..
01/01/2017,00:12:00,25.01,0086623.37051,C,F..
01/01/2017,00:14:00,25.01,0086626.35893,C,F..
01/01/2017,00:16:00,25.01,0086629.34177,C,F..
01/01/2017,00:18:00,25.01,0086632.32462,C,F..
01/01/2017,00:20:00,25.01,0086635.31025,C,F..
01/01/2017,00:22:00,25.01,0086638.29588,C,F..
01/01/2017,00:24:00,25.01,0086641.28151,C,F..
01/01/2017,00:26:00,25.02,0086644.26714,C,F..
01/01/2017,00:28:00,25.01,0086647.24999,C,F..
01/01/2017,00:30:00,25.01,0086650.23562,C,F..
01/01/2017,00:32:00,25.01,0086653.22125,C,F..
01/01/2017,00:34:00,25.01,0086656.20688,C,F..
01/01/2017,00:36:00,25.01,0086659.19529,C,F..
01/01/2017,00:38:00,25.02,0086662.18092,C,F..
01/01/2017,00:40:00,25.01,0086665.16377,C,F..
01/01/2017,00:42:00,25.01,0086668.14940,C,F..
01/01/2017,00:44:00,25.01,0086671.13503,C,F..
01/01/2017,00:46:00,25.01,0086674.12066,C,F..
01/01/2017,00:48:00,25.02,0086677.10351,C,F..
01/01/2017,00:50:00,25.01,0086680.08636,C,F..
01/01/2017,00:52:00,25.01,0086683.07199,C,F..
01/01/2017,00:54:00,25.01,0086686.05484,C,F..
01/01/2017,00:56:00,25.01,0086689.04047,C,F..
01/01/2017,00:58:00,25.02,0086692.02610,C,F..
01/01/2017,01:00:00,25.01,0086695.00616,C,F..
01/01/2017,01:02:00,25.01,0086698.08946,C,F..
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
03/01/2017,00:34:00,50.08,0088579.34973,C,F..
03/01/2017,00:36:00,50.08,0088585.31445,C,F..

.8519.70527,C,F..03/01/2017,00:16:00,50.10,0088525.67278,C,F..03/01/2017,00:18:00,50.08,0088531.64028,C,F..03/01/2017,00:20:00,50.07,0088537.60500,C,F..03/01/2017,00:22:
