Bolagnos/Telemeteria-Bluetooth-Hidronica/(list of files, drawings)

Other design files:
Telemetría Hidronica con bluetooth/Hardware/PCB/Telemetria GPRS Bluetoot MP V1_0 Rev1/Fuente3V.SchDoc
Telemetría Hidronica con bluetooth/Hardware/PCB/Telemetria GPRS Bluetoot MP V1_0 Rev1/Fuente-12V.SchDoc
Telemetría Hidronica con bluetooth/Hardware/PCB/Telemetria GPRS Bluetoot MP V1_0 Rev1/Interfaz de Memoria.SchDoc
Telemetría Hidronica con bluetooth/Hardware/PCB/Telemetria GPRS Bluetoot MP V1_0 Rev1/Interfaz de Usuario.SchDoc
Telemetría Hidronica con bluetooth/Hardware/PCB/Telemetria GPRS Bluetoot MP V1_0 Rev1/Interfaz_RS232.SchDoc
Telemetría Hidronica con bluetooth/Hardware/PCB/Telemetria GPRS Bluetoot MP V1_0 Rev1/Interfaz_RTC.SchDoc
Telemetría Hidronica con bluetooth/Hardware/PCB/Telemetria GPRS Bluetoot MP V1_0 Rev1/Local Library/ADG836.PcbLib
Telemetría Hidronica con bluetooth/Hardware/PCB/Telemetria GPRS Bluetoot MP V1_0 Rev1/Local Library/ADG836.SchLib
Telemetría Hidronica con bluetooth/Hardware/PCB/Telemetria GPRS Bluetoot MP V1_0 Rev1/Local Library/ALTIUM-693072010801-rev16b/SIM-Memory_Card Connectors.SchLib
Telemetría Hidronica con bluetooth/Hardware/PCB/Telemetria GPRS Bluetoot MP V1_0 Rev1/Local Library/ALTIUM-693072010801-rev16b/Smart Card Connectors.PcbLib
Telemetría Hidronica con bluetooth/Hardware/PCB/Telemetria GPRS Bluetoot MP V1_0 Rev1/Local Library/ALTIUM-693072010801-rev16b/Smart Card Connectors.SchLib
Telemetría Hidronica con bluetooth/Hardware/PCB/Telemetria GPRS Bluetoot MP V1_0 Rev1/Local Library/Laird BL652.PcbLib
Telemetría Hidronica con bluetooth/Hardware/PCB/Telemetria GPRS Bluetoot MP V1_0 Rev1/Local Library/Laird BL652.SchLib
Telemetría Hidronica con bluetooth/Hardware/PCB/Telemetria GPRS Bluetoot MP V1_0 Rev1/Local Library/ProjectLib.SchLib
Telemetría Hidronica con bluetooth/Hardware/PCB/Telemetria GPRS Bluetoot MP V1_0 Rev1/Modem-GPRS.SchDoc
Telemetría Hidronica con bluetooth/Hardware/PCB/Telemetria GPRS Bluetoot MP V1_0 Rev1/Modulo BL652.SchDoc
Telemetría Hidronica con bluetooth/Hardware/PCB/Telemetria GPRS Bluetoot MP V1_0 Rev1/Monitoreo-Bateria.SchDoc
Telemetría Hidronica con bluetooth/Hardware/PCB/Telemetria GPRS Bluetoot MP V1_0 Rev1/MSP430.SchDoc
Telemetría Hidronica con bluetooth/Hardware/PCB/Telemetria GPRS Bluetoot MP V1_0 Rev1/PCB_Tel_GPRS_BT-V1_Rev1.PrjPcb
Telemetría Hidronica con bluetooth/Hardware/PCB/Telemetria GPRS Bluetoot MP V1_0 Rev1/Principal.SchDoc
Telemetría Hidronica con bluetooth/Hardware/PCB/Telemetria GPRS Bluetoot MP V1_0 Rev1/SD_Memory.SchDoc
Telemetría Hidronica con bluetooth/Hardware/PCB/Telemetria GPRS Bluetoot MP V1_0 Rev1/SDCard.SchDoc
Telemetría Hidronica con bluetooth/Hardware/PCB/Telemetria GPRS Bluetoot MP V1_0 Rev1/SIM.SchDoc
Telemetría Hidronica con bluetooth/Hardware/PCB/Telemetria GPRS Bluetoot MP V1_0 Rev1/UART_Multiplexor.SchDoc
Telemetría Hidronica con bluetooth/Hardware/PCB/USB_Serial Interface/myLibraries/ADG836.PcbLib
Telemetría Hidronica con bluetooth/Hardware/PCB/USB_Serial Interface/myLibraries/ADG836.SchLib
Telemetría Hidronica con bluetooth/Hardware/PCB/USB_Serial Interface/myLibraries/CustomPCBLib.PcbLib
Telemetría Hidronica con bluetooth/Hardware/PCB/USB_Serial Interface/myLibraries/Laird BL652.PcbLib
Telemetría Hidronica con bluetooth/Hardware/PCB/USB_Serial Interface/myLibraries/Laird BL652.SchLib
Telemetría Hidronica con bluetooth/Hardware/PCB/USB_Serial Interface/myLibraries/ProjectLib.SchLib
Telemetría Hidronica con bluetooth/Hardware/PCB/USB_Serial Interface/myLibraries/TexasInstruments_Custom.SchLib
Telemetría Hidronica con bluetooth/Hardware/PCB/USB_Serial Interface/USB_Serial Interface.PrjPcb
Telemetría Hidronica con bluetooth/Hardware/PCB/USB_Serial Interface/USB_Serial_Interface.PcbDoc
Telemetría Hidronica con bluetooth/Hardware/PCB/USB_Serial Interface/USB_Serial_Interface.SchDoc
