Bolagnos/Telemeteria-Bluetooth-Hidronica/Telemetría Hidronica con bluetooth/Software Desarrollo/UwTerminalX_v1.08g_Windows/Devices.ini

[General]
Port1Name=BT900
Port1Baud=115200
Port1Parity=0
Port1Stop=1
Port1Data=8
Port1Flow=1
Port2Name=BL600/BL620
Port2Baud=9600
Port2Parity=0
Port2Stop=1
Port2Data=8
Port2Flow=1
Port3Name=BL620-US
Port3Baud=9600
Port3Parity=0
Port3Stop=1
Port3Data=8
Port3Flow=0
Port4Name=BL652
Port4Baud=115200
Port4Parity=0
Port4Stop=1
Port4Data=8
Port4Flow=0
Port5Name=RM186/RM191
Port5Baud=115200
Port5Parity=0
Port5Stop=1
Port5Data=8
Port5Flow=1
DoneSetup=1
