Bolagnos/Telemeteria-Bluetooth-Hidronica/Telemetría Hidronica con bluetooth/Firmware/MSP430/Assemble CRC Messages Firmware/CGPRS.cpp

/************************************************************/
/*    Codigo para control de modem Quectel UC20 y EC20	    */
/************************************************************/
/*#define W_ENABLE_GPRS     BIT3 // P1.3  // Control de paso a bajo consumo del módulo de GPRS (W-ENABLE)
#define ON_OFF_Modem_VCC  BIT6 // P1.6  // Control para encendido general del modem  GPRS (Alimentación, habilita relay de estado sólido)
#define ON_OFF_GPRS       BIT7 // P1.7  // Señal de encendido/apagado del módem GPRS (por su pin de control PERST#)
#define BitFlag_ONGPRS    BIT6 // P6.6  // Puerto de entrada para detección de que el módem se encuentra encendido

#define BL652_Reset       // P
#define BL652_nAutoRun    // P
*/
//#define LED_GPRS_EQ BIT7      // P5.7  // Salida para indicador LED de encendido del módem GPRS
#include "CDevice.h"
//#include "string.h"
#include "string"

const char*  APN_Providers[]={
              "internet.itelcel.com","webgprs","webgprs2002","TELCEL",       // TELCEL
              "internet.movistar.mx","movistar","movistar","MOVISTAR",       // MOVISTAR
              "web.iusacellgsm.mx","iusacellgsm","iusacellgsm","IUSACELL",   // IUSACELL
              };
const char* GPRSCommand[]={
                            "ATV1",                                        // 0 OK Vervose: Character
                            "ATE0",                                        // 1 OK Echo: None
                            "AT+CMEE=1",                                   // 2 OK Error report: Enabled
                            "AT&W",                                        // 3 OK Write config on modem EEPROM
                            "AT+CREG=1",                                   // 4 6 OK Registro al servicio GSM
                            "AT+CGREG=1",                                  // 5 OK Registro al servicio GSM
                            "AT+CSQ",                                      // 6 8 Signal Quality

                            "AT+QICSGP=1,1,\"", // 7 // "AT+QICSGP=1,1,\"internet.itelcel.com\",\"webgprs\",\"webgprs2002\",0",
                            "AT+QIACT=1",                                                           // 8
                            "AT+QIOPEN=1,0,\"TCP\",\"",                  // 9  // "AT+QIOPEN=1,0,\"TCP\",\"gprshost.tzo.com\",2007,0,2"

                            "",                                            // 10 Para envío de reporte vía GPRS (TCP/IP)
                            "+++",                                         // 11
                            "AT",                                          // 12
                            "AT+QICLOSE=1",                                // 13
                          };

/*const char* GPRSCommand[]={
                            "ATV1",                                       // 0 OK Vervose: Character
                            "ATE0",                                       // 1 OK Echo: None
                            "AT+WIND=4351",                               // 2
                            "AT+CMEE=1",                                   // 3 OK Error report: Enabled
                            "AT&W",                                        // 4 OK Write config on modem EEPROM

                            "AT+WSHS",                                     // 5 Estado de la SIM card Holder
                            "AT+CREG=1",                                   // 6 Registro al servicio GSM
                            "AT+WSTR=2",                                   // 7 Estado de la red
                            "AT+CSQ",                                      // 8 Signal Quality

                            "AT+WIPCFG=1",                                 // 9
                            "AT+WIPBR=1,6",                                // 10 Start Bearer
//                            "AT+WIPBR=2,6,11,\"internet.itelcel.com\"",    // 11
                            "AT+WIPBR=2,6,11,\"",                          // 11
//                            "AT+WIPBR=2,6,0,\"webgprs\"",                  // 12
                            "AT+WIPBR=2,6,0,\"",                  // 12
//                            "AT+WIPBR=2,6,1,\"webgprs2002\"",              // 13
                            "AT+WIPBR=2,6,1,\"",              // 13
                            "AT+WIPBR=4,6,0",                              // 14
//                            "AT+WIPCREATE=2,1,\"gprshost.tzo.com\",2007",  // 15
                            "AT+WIPCREATE=2,1,\"",  // 15
                            "AT+WIPDATA=2,1,1",                            // 16
                            "",                                            // 17 Para envío de reporte vía GPRS (TCP/IP)
                            "+++",                                         // 18
                            "AT+WIPCLOSE=2,1",                             // 19
                            "AT+WIPBR=5,6",                                // 20 Stop Bearer
                            "AT+WIPBR=0,6",                                // 21 Close Bearer

                            "AT+CPOF",                                     // 22 Turn off GSM module after set pin ON/OFF to GND
                            "AT+WOPEN=1"                                   // 23 Abre aplicación inmersa
                            "AT+CFUN=1"                                    // 24 Reset completo del sistema

                            //"AT+CGDCONT=1,\"IP\",\"internet.movistar.mx\"\r",           // 6 telefonica
                            //"AT*ENAD=1,\"GPRS1\",\"movistar\",\"movistar\",1,0,0,1\r",  // 7 telefonica

                          };
*/

/****************************************************************************************************/
const char *ResponsesGPRS[]=
{
  "OK",           // 0
  "+WSHS: ",      // 1
  "+WSTR: ",      // 2
  "+CSQ: ",       // 3
  "CONNECT",      // 4
  "ADT: ",             // 5
  "+WIPPEERCLOSE:", // 6
  "END SESSION",  // 7
};

/*********************************************************************/
CGPRS::CGPRS()
{
  //this->configGPRSVars();
  this->BL652=new CBluetooth();
  this->configGPRSCtrlPorts();
  this->UART=new CUart0();
  this->counterTimeout=0;
  this->timerReset=new CTimerB();
  this->flagsTXExt=false;
  this->flags_req_info=0x00;
  this->validatePassword=false;
}
/*********************************************************************/
CGPRS::~CGPRS()
{
}
/*********************************************************************/
void CGPRS::configGPRSVars()
{
  int x;

  for(x=0;x<103;x++)
  {this->APN_GPRS_SERV[x]=0x00;
  }
  this->setIDSP(0);  // Inicializa con Proveedor de Servicio GSM TELCEL
  this->setIP_Port("2009", 4);
  strcpy(this->DNS,"gprshost.tzo.com");
}
/*********************************************************************/
//Envía 1 si no detectó algún mensaje inesperado o llegó un mensaje inesperado que no se requiere
int CGPRS::evalWIND(char* l_Buffer, int len)
{
  char* p_ch=l_Buffer;
  int resp=1;

  while(p_ch<(l_Buffer+len) && p_ch)
  {
  p_ch=strstr(p_ch,"+WIND");

  if(p_ch)
  {
  switch(p_ch[7])
  {
  case '0':
            switch(p_ch[8])
            {
            case '\r':        // El SIM ha sido removido
                      this->state_GSM_Modem&=~BIT1;
                      resp=2;
                      break;
            default:
                      break;
            }
            break;
  case '1':
            switch(p_ch[8])
            {
            case '3':         // El rack del SIM se ha cerrado
                      this->state_GSM_Modem|=BIT0;
                      resp=7;
                      break;
            case '4':         // El rack del SIM se ha abierto
                      this->state_GSM_Modem&=~BIT0;
                      resp=8;
                      break;
            case '\r':        // El SIM ha sido insertado
                      this->state_GSM_Modem|=BIT1;
                      resp=3;
                      break;
            default:
                      break;
            }
            break;
  case '4':                 // El modem está listo para recibir todos los comandos AT
            switch(p_ch[8])
            {
            case '\r':
                      this->state_GSM_Modem|=BIT2;
                      resp=4;
                      break;
            default:
                      break;
            }
            break;
  case '7':                 // El servicio de la red solo está listo para recibir llamadas de emergencia
            switch(p_ch[8])
            {
            case '\r':
                      this->state_GSM_Modem|=BIT3;  // Enciende bit de detección de llamada en espera
                      this->state_GSM_Modem&=~BIT4; // Apaga bit de estado de conexión a la red
                      resp=5;
                      break;
            default:
                      break;
            }
            break;
  case '8':                 // El servicio de la red solo está listo para recibir llamadas de emergencia
            switch(p_ch[8])
            {
            case '\r':
                      this->state_GSM_Modem&=~(BIT0|BIT1|BIT2|BIT3);
                      this->state_GSM_Modem|=BIT4;
                      resp=6;
                      break;
            default:
                      break;
            }
            break;
  default:
            break;
  }
  p_ch+=8;
  }
  }

  return resp;
}


/****************************************************************************************************/
// Implementación de Funciones.
/****************************************************************************************************/
void CGPRS::configGPRSCtrlPorts()
{
 // int x;

  P6DIR&=~BitFlag_ONGPRS;   // Establece el puerto P6.0 como entrada
  P1DIR|=(ON_OFF_Modem_VCC|ON_OFF_GPRS);       // Establece el puerto P1.6 y P1.7 como salida.
  P1OUT&=~(ON_OFF_Modem_VCC|ON_OFF_GPRS);
//  P5DIR|=LED_GPRS_EQ;       // Establece P5.7 como salida
//  P5OUT|=LED_GPRS_EQ;       // Prende el LED en el PCB de estado del modem GSM

//  if(!this->isModemGPRSOn())
//  {
//    P5OUT&=~LED_GPRS_EQ;    // Apaga LED en el PCB de estado del modem GSM
//  }

//  for(x=0;x<sizeof(this->APN_GPRS_SERV);x++)
/*  for(x=0;x<103;x++)
  {this->APN_GPRS_SERV[x]=0x00;
  }
  this->setIDSP(0);  // Inicializa con Proveedor de Servicio GSM TELCEL
  this->setIP_Port("2009", 4);
  strcpy(this->DNS,"gprshost.tzo.com");
  */
  this->configGPRSVars();

  this->state_GSM_Modem=0x00;
  this->stateGPRS=0x00;
  this->commCounter=0x00;
  this->enableSendingReport();

}
/****************************************************************************************************/
void CGPRS::setAPNConf(char* ID_APN)
{
  strcpy(this->APN_GPRS_SERV,APN_Providers[(*ID_APN)*4]);
  strcpy(this->APN_GPRS_USER,APN_Providers[((*ID_APN)*4)+1]);
  strcpy(this->APN_GPRS_PSW,APN_Providers[((*ID_APN)*4)+2]);
}
/****************************************************************************************************/
void CGPRS::sendFrameToGPRS(int Command)
{
     int mylen=0;

     sprintf((char *)&this->UART->Buffer_Tx[0],"%s",GPRSCommand[Command]);
     if(Command == 0 || Command == 5 || Command == 6 || Command == 12)
     {
        this->UART->setExtratimeOut(60);
     }
     else
     {
       if(Command == 9)
       {
         strcat((char *)this->UART->Buffer_Tx,this->DNS);
         mylen=strlen((char*)this->UART->Buffer_Tx);
         this->UART->Buffer_Tx[mylen++]='"';
         this->UART->Buffer_Tx[mylen++]=',';
         this->UART->Buffer_Tx[mylen]='\0';
         strcat((char *)this->UART->Buffer_Tx,this->IP_PORT);
         mylen=strlen((char*)this->UART->Buffer_Tx);
         this->UART->Buffer_Tx[mylen++]=',';
         this->UART->Buffer_Tx[mylen++]='0';
         this->UART->Buffer_Tx[mylen++]=',';
         this->UART->Buffer_Tx[mylen++]='2';
         this->UART->Buffer_Tx[mylen]='\0';
         this->UART->setExtratimeOut(60);
       }
       else
       {
        this->UART->setExtratimeOut(5);
       }
     }

     if (Command==7)
     {
       if(this->ID_SERV_PROV==3) // Selecciona un APN diferente ingresado por el usuario vía Puerto Serie
       {
        strcat((char *)this->UART->Buffer_Tx,this->APN_GPRS_SERV);
        mylen=strlen((char*)this->UART->Buffer_Tx);
        this->UART->Buffer_Tx[mylen++]='"';
        this->UART->Buffer_Tx[mylen++]=',';
        this->UART->Buffer_Tx[mylen++]='"';
        this->UART->Buffer_Tx[mylen++]='\0';
        strcat((char *)this->UART->Buffer_Tx,this->APN_GPRS_USER);
        mylen=strlen((char*)this->UART->Buffer_Tx);
        this->UART->Buffer_Tx[mylen++]='"';
        this->UART->Buffer_Tx[mylen++]=',';
        this->UART->Buffer_Tx[mylen++]='"';
        this->UART->Buffer_Tx[mylen++]='\0';
        strcat((char *)this->UART->Buffer_Tx,this->APN_GPRS_PSW);
       }
       else
       {    // Establece el APN selccionado por usuario de los establecidos en la lista preestablecida
         strcat((char *)this->UART->Buffer_Tx,APN_Providers[(this->ID_SERV_PROV*4)]);
         mylen=strlen((char*)this->UART->Buffer_Tx);
         this->UART->Buffer_Tx[mylen++]='"';
         this->UART->Buffer_Tx[mylen++]=',';
         this->UART->Buffer_Tx[mylen++]='"';
         this->UART->Buffer_Tx[mylen++]='\0';
         strcat((char *)this->UART->Buffer_Tx,APN_Providers[(this->ID_SERV_PROV*4)+1]);
         mylen=strlen((char*)this->UART->Buffer_Tx);
         this->UART->Buffer_Tx[mylen++]='"';
         this->UART->Buffer_Tx[mylen++]=',';
         this->UART->Buffer_Tx[mylen++]='"';
         this->UART->Buffer_Tx[mylen++]='\0';
         strcat((char *)this->UART->Buffer_Tx,APN_Providers[(this->ID_SERV_PROV*4)+2]);
       }
       mylen=strlen((char*)this->UART->Buffer_Tx);
       this->UART->Buffer_Tx[mylen++]='"';
       this->UART->Buffer_Tx[mylen++]=',';
       this->UART->Buffer_Tx[mylen++]='0';
       this->UART->Buffer_Tx[mylen]='\0';
     }

     mylen=strlen((char *)&this->UART->Buffer_Tx[0]);
     if(Command!=11)
     {
      this->UART->Buffer_Tx[mylen++]='\r';
     }

     this->stateGPRS|=BIT0;    // Establece bandera de petición de comando AT
     this->UART->startTx((char *)&this->UART->Buffer_Tx[0],mylen); // Envía la cadena de datos por el puerto serie.
}
/****************************************************************************************************/
void CGPRS::sendStringToUART(char* BufferTx, int length)
{
     int mylen=length;

     //this->setEncryptionMode();;

//     mylen=strlen((char *)&uartPort1->Buffer_Rx[0]);

     this->UART->startTx(BufferTx,mylen); // Envía la cadena de datos por el puerto serie.

}
/****************************************************************************************************/
void CGPRS::sendStringGPRS(char* myStr)
{
     int mylen=0;
     this->UART->setExtratimeOut(30);
     mylen=strlen(myStr);
     this->UART->startTx(myStr,mylen); // Envía la cadena de datos por el puerto serie.
}
/****************************************************************************************************/
void CGPRS::setupGPRS()
{
  this->stateGPRS&=~BIT1;
  this->commCounter=0;
  this->endCommandIndex=11;  //21;
  this->sendFrameToGPRS(this->commCounter);
}
/****************************************************************************************************/
void CGPRS::connectGPRS()
{
//  turnOnGPRS();
  this->stateGPRS&=~BIT1;
  this->commCounter=5;
  this->endCommandIndex=11; //21;   // el comando 12 es para el envío de datos vía GPRS el 14 es el comando de fin de comandos a transmitir.
  this->sendFrameToGPRS(this->commCounter);
}
/****************************************************************************************************/
/****************************************************************************************************/
/****************************************************************************************************/
//unsigned int CGPRS::evalGPRSResponse(int* commandSent, unsigned char* BufferRx, int* RxLength, CRTC_3029_I2C* Reloj, CEEPROM *memHandler, CLcd *myLCD)
unsigned int CGPRS::evalGPRSResponse(int* commandSent, unsigned char* BufferRx, int* RxLength, CRTC_3029_I2C* Reloj, CEEPROM *memHandler)
{
  unsigned int response=0x0000;
//  unsigned char res=0x00;
  char *myStr;

  char * mypointer;
  int x; //,y;
 if(this->stateGPRS&BIT0 || this->stateGPRS&BIT1) // Bandera de solicitud comando AT habilitado?
 {
  switch(*commandSent)
  {
  case 0:
  case 1:
  case 2:
  case 3:
  case 4:
  case 5:
  case 7:
  case 8:
//  case 9:
//  case 10:
//  case 11:
  case 12:
  case 13:
  case 14:
  case 15:
  case 19:
  case 20:
  case 21:
  case 22:
          myStr=(char*)ResponsesGPRS[0];
          break;
  //case 5:
  //        myStr=(char*)ResponsesGPRS[1];
  //        break;
  /*case 7:
          myStr=(char*)ResponsesGPRS[2];
          break;*/
  case 6:
          myStr=(char*)ResponsesGPRS[3];
          break;
  //case 16:
  case 9:
          myStr=(char*)ResponsesGPRS[4];
          break;
  case 10:myStr=(char*)ResponsesGPRS[5];  // 17
          break;
  case 11:myStr=(char*)ResponsesGPRS[6];  // 18
          break;

  default: break;
  }

  char  Buffer[2];

  mypointer=(char *)strstr((const char *)&BufferRx[0],myStr);

  if(mypointer) // Respuesta adecuada?
  {
     switch(*commandSent)
     {
     /*case 5:mypointer+=7;
            sscanf(mypointer, "%1d", (int*)&Buffer[0]);
            if(Buffer[0])
            {
              if(strstr((const char *)mypointer,"OK"))
              {response=0x02;}  // response = 2 -> Sesión IP inactiva
            }
            break;
       */
     /*case 7:mypointer+=9;
            if(*mypointer==0x31)
            {
              if(strstr((const char *)mypointer,"OK"))
              {response=0x03;}                     // response = 3 -> se há conectado al servicio de GPRS.
            }
            break;
       */
     case 6:mypointer+=6;  // Valida si existe señal de servicio GSM adecuado.
            if(*(mypointer+1)>=0x30 && *(mypointer+1)<=0x39 )
            {sscanf(mypointer, "%2d", (int*)&Buffer[0]);}
            else
            {sscanf(mypointer, "%1d", (int*)&Buffer[0]);}
            if (Buffer[0]!= 0 && Buffer[0]!= 99)
            {response=0x04;}                    // response =4 -> Existe señal adecuada para comunicar.
            break;
     case 14:mypointer+=6;
            response=0x05;
            if(strstr((const char *)mypointer,"+CGREG: 1"))
            {response=0x05;}                     // response = 3 -> se há conectado al servicio de GPRS.
            break;
     case 15:mypointer+=6;
            if(strstr((const char *)mypointer,"+WIPREADY:"))
            {response=0x06;}                     // response = 3 -> se há conectado al servicio de GPRS.
            break;
     //case 16:
     case 9:
              this->stateGPRS|=BIT1;            // Habilita bandera de inicio de sesión de comunicación GPRS.
              this->stateGPRS|=BIT5;            // Habilita bandera de estado de comunicaciones en línea de datos GPRS
              response=0x07;                    // Response = 8 -> Se tiene la conexión realizada con el servidor en el puerto seleccionado.
              break;
     case 10:// Integrar código para cambiar fecha y hora local
            if((char *)strstr((const char *)&BufferRx[0],(char*)ResponsesGPRS[7]))
            {
              mypointer+=5;
              sscanf(mypointer, "%2d%2d%4d%2d%2d%2d", (int*)&this->UART->Buffer_Tx[0],(int*)&this->UART->Buffer_Tx[2],(int*)&this->UART->Buffer_Tx[4],(int*)&this->UART->Buffer_Tx[6],(int*)&this->UART->Buffer_Tx[8],(int*)&this->UART->Buffer_Tx[10]);
              Reloj->hexToBcdRTC((int*)&this->UART->Buffer_Tx[0]);
              Reloj->setHour_Date(memHandler);
              Reloj->setRTCOnIntTime(memHandler,false);
              response=0x08;
              // Código en caso par requerir habilitar o deshabilitar el envío del reportes (Solicitud remota)
              while(mypointer)
              {
                mypointer=this->evalAndExecuteReqRemote(mypointer);
              }
            }
            break;
     case 11:
            this->stateGPRS&=~BIT5;            // Habilita bandera de estado de comunicaciones en línea de datos GPRS
            response=0x09;
            break;
     case 12: //19
             this->stateGPRS&=~BIT1;
             response=0x0A;
             break;
     default:response=0x01;
             break;
     }


      for(x=0;x<*RxLength;x++)    // Borra el contenido del buffer de Rx
      {
        BufferRx[x]=0x00;
      }

  }
  else
  {
    switch(*commandSent)
    {
    case 10:
            if(strstr((const char *)&BufferRx[0],"+CME ERROR: 804"))
            {response=1;}
             for(x=0;x<*RxLength;x++)    // Borra el contenido del buffer de Rx
            {
              BufferRx[x]=0x00;
            }
            break;
    case 9: if(strstr((const char *)&BufferRx[0],"+CME ERROR: 844"))
            {
              response=1;
            }
            for(x=0;x<*RxLength;x++)    // Borra el contenido del buffer de Rx
            {
              BufferRx[x]=0x00;
            }
            break;
    default: break;
    }

  }

 }// Final if de evaluación de bandera de comando AT solicitado

 // Evalúa resuestas insolicitadas cuando estas existan
/* res=this->evalWIND((char*)BufferRx, *RxLength);
  if(res)
  {
    response|=(res*0x0100);
    for(x=0;x<*RxLength;x++)    // Borra el contenido del buffer de Rx
      {
        BufferRx[x]=0x00;
      }
  }
*/



  return response;
}
/****************************************************************************************************/
/****************************************************************************************************/
//int CGPRS::timeoutTxRx(CRTC_3029_I2C *myClock, CLcd *myLCD, char* SerialNumber, CLogger* SatLogg, CMPG2* mMPG2, CEEPROM *memHandler)
int CGPRS::timeoutTxRx(CRTC_3029_I2C *myClock, char* SerialNumber, CLogger* SatLogg, CMPG2* mMPG2, CEEPROM *memHandler)
{
  int resp=0;
  int ID_Eval=0;

//  unsigned int dataSize;
//  char Buffer[4];
  if(this->UART->statePort&0x02)  // Comunicaciones Tx o Rx del módulo Satelital o puerto local?
  {

    this->UART->myWDT->stopWdt();
    this->UART->statePort&=~0x02;

    if (this->UART->UartError==0x01)  // Verifica si existe Error de Over flow del buffer de Rx.
    {
      this->UART->UartError&=~0x01;
      this->UART->clearRxBuffPointer(); // Inicializa puntero de Rx en el Buffer de Rx de Comunicaciones Serie
      this->UART->clearBufferRx();
      this->stateGPRS&=~BIT0; // Deshabilita bandera de solicitud de comando AT
      this->UART->commTries=0;
      this->UART->strRxLen=0;
      this->UART->statePort&=~0x02;
//          resp=1;

      if(this->isIPSessionOpen() && this->stateGPRS&BIT5)
      {
         this->OFFfromGPRSSession();
      }
      else
      {
         this->OffModemGPRS();
      }
    }
    else
    {
      //if(this->UART->isSwUARTModem()) // Se tiene habilitado el puerto del modem satelital?
      //{
        if(this->UART->strRxLen)// Se recibió una cadena de datos?
        {
          this->UART->Buffer_Rx[this->UART->strRxLen]=0x00; //Inserta 0 al final de la cadena recibida
          // Código para verificar comandos cuando son solicitados via comando AT
          ID_Eval=this->evalGPRSResponse(&this->commCounter, this->UART->Buffer_Rx, &this->UART->strRxLen, myClock, memHandler);
          if (ID_Eval & 0x00FF) // Se recibió la respuesta de manera correcta del módulo Satelital?
          {
                 this->UART->clearRxBuffPointer(); // Inicializa puntero de Rx en el Buffer de Rx de Comunicaciones Serie
                 this->UART->strRxLen=0;
//                 this->UART->clearBufferRx();
                 this->UART->extraTimeCounter=0;
                 this->UART->commTries=0;

/*            if((ID_Eval & 0xFF00)!=0x0100)// Se recibió mensaje inesperado WIND?
            {// Revisar banderas y ejecutar la acción.
               if(this->stateGPRS&BIT0 || this->stateGPRS&BIT1)
               {
                  this->UART->myWDT->restartWdt();
               }
            }*/
            //if(ID_Eval& 0x00FF)//Se recibió respuesta comando AT correcto correspondiente al solicitado?
            //{
              this->stateGPRS&=~BIT0; // Deshabilita bandera de solicitud de comando AT
              this->commCounter++;
              if(this->commCounter<=this->endCommandIndex)
              {
                if(this->commCounter==11) //18
                {
                   mMPG2->restartWRPointers(0x0000);
                   SatLogg->clearNData();
                }
                if(this->commCounter==10) // 17
                {
                  this->SetFormatMessage((char*)this->UART->Buffer_Tx, SatLogg, mMPG2, memHandler, SerialNumber,*myClock->getTimeZone());
                  this->sendStringGPRS((char*)this->UART->Buffer_Tx);
                }
                else
                {
                  this->sendFrameToGPRS(this->commCounter);
                }
              }
              else
              {// Integrar fin de envío de comandos
                 if(this->commCounter!=13)
                 {
                    //P5OUT|=BIT0;
                    this->OffModemGPRS();
                 }
                 else
                 {
                    this->turnOFF_VCC_GPRS();
                    this->stateGPRS&=~(BIT0|BIT1|BIT3|BIT5);
                    this->UART->UartError&=~0x01;
                    this->UART->clearRxBuffPointer(); // Inicializa puntero de Rx en el Buffer de Rx de Comunicaciones Serie
                    this->UART->strRxLen=0;
                    this->UART->clearBufferRx();
                    this->UART->extraTimeCounter=0;
                    this->UART->commTries=0;
                    resp=1;

                 }
              }
            //}
          }
          else  //No se recibió la respuesta correcta o falta información.
          {
            //if(this->stateGPRS&BIT0)// Se recibieron datos en puerto al enviar un comando AT?
            //{
            if((!(ID_Eval & 0x00FF)) && this->stateGPRS&BIT0)
            {
              if(this->UART->extraTimeCounter<this->UART->extraTimeout)// Espera de tiempo extra en espera para recibir datos en caso que no se haya recibido ningún byte.
              {
                this->UART->statePort|=0x02;
                this->UART->extraTimeCounter++;
                this->UART->myWDT->restartWdt();
              }
              else
              {
                this->UART->clearRxBuffPointer(); // Inicializa puntero de Rx en el Buffer de Rx de Comunicaciones Serie
                this->UART->clearBufferRx();
                this->UART->strRxLen=0;
                this->UART->extraTimeCounter=0;
                this->UART->commTries++;
                if(this->UART->commTries>this->UART->tries) // Cantidad de intentos de retransmisión en caso de que no haya recibido ningún byte en respuesta.
                {
                // Finaliza retransmisiones a GPRS
                  if(this->stateGPRS&BIT1 && this->isModemGPRSOn()) // Sesion GPRS Abierta?
                  {
                    this->stateGPRS&=~BIT0;
                    if(this->stateGPRS&BIT5) // Se encuentra en línea de datos GPRS?
                    {
                      this->OFFfromGPRSSession();
                    }
                    else
                    {
                      this->OffModemGPRS();
                    }
                  }
                  else
                  {
                    if(this->stateGPRS&BIT0 && this->isModemGPRSOn()) // Se pidió comandos AT ?
                    {
                      this->OffModemGPRS();
                    }
                    else
                    {
                      this->turnOFF_VCC_GPRS();
                      this->stateGPRS&=~(BIT0|BIT1|BIT3|BIT5); // Deshabilita bandera de solicitud de comando AT
                      this->UART->commTries=0;
                      this->UART->strRxLen=0;
                      this->UART->UartError&=~0x01;
                      resp=1; //3// 1
                    }
                  }

                }
                else // Retransmite último comando solicitado.
                {
                  if(this->commCounter==10) // 17
                  {
                    //this->SetFormatMessage((char*)this->UART->Buffer_Tx, SatLogg, mMPG2, memHandler, SerialNumber);
                    //this->sendStringGPRS((char*)this->UART->Buffer_Tx);
                    //////////////////////////////////////////////////////////////
                    if(this->isModemGPRSOn())
                    {
                      if(this->isIPSessionOpen())
                      {
                        if(this->stateGPRS&BIT5)
                        {
                          this->OFFfromGPRSSession();
                        }
                        else
                        {
                          this->OffModemGPRS();
                        }
                      }
                      else
                      {
                        this->OffModemGPRS();
                      }
                    }
                    else
                    { // Finaliza comunicaciones
                        this->turnOFF_VCC_GPRS();
                        this->stateGPRS&=~(BIT0|BIT1|BIT3|BIT5); // Deshabilita bandera de solicitud de comando AT
                        this->UART->clearBufferRx();
                        this->UART->commTries=0;
                        this->UART->strRxLen=0;
                        this->UART->UartError&=~0x01;
                        resp=1; //3// 1
                    }
                    //////////////////////////////////////////////////////////////
                  }
                  else
                  {
                    this->stateGPRS&=~BIT0; // Deshabilita bandera de solicitud de comando AT
                    this->sendFrameToGPRS(this->commCounter);
                  }
                  //}
//                  this->sendFrameToSat201C(*((unsigned int*)&this->UART->Buffer_Tx[2]));
                }
              }
            }
            else
            { // codigo para evaluar respuestas relacionadas a comandos externos
              if(this->isIPSessionOpen())
              {
                 if(this->stateGPRS&BIT5)
//                 if(strstr((char*)this->UART->Buffer_Rx,"+CME ERROR:") || strstr((char*)this->UART->Buffer_Rx,"NO CARRIER"))
                 {
                   this->OFFfromGPRSSession();
                 }
                 else
                 {
                   this->OffModemGPRS();
//                   this->OFFfromGPRSSession();
                 }
              }
              else
              {
                this->OffModemGPRS();
//                this->SetFormatMessage((char*)this->UART->Buffer_Tx, SatLogg, mMPG2, memHandler, SerialNumber,*myClock->getTimeZone());
/*                this->UART->clearRxBuffPointer(this->UART); // Inicializa puntero de Rx en el Buffer de Rx de Comunicaciones Serie
                this->UART->clearBufferRx();
//                this->stateGPRS&=~BIT0; // Deshabilita bandera de solicitud de comando AT
                this->stateGPRS&=~(BIT0|BIT1|BIT3|BIT5); // Deshabilita bandera de solicitud de comando AT
                this->UART->commTries=0;
                this->UART->strRxLen=0;
                this->UART->UartError&=~0x01;
                resp=1;
                */
              }
            }
            //}
          }
        } // Fin if si se recibió una cadena de datos
        else // si no recibió una cadena de datos del modem satelital y se esperaba dependiendo el comando solicitado
        {
          if(this->UART->extraTimeCounter<this->UART->extraTimeout)// Espera de tiempo extra en espera para recibir datos en caso que no se haya recibido ningún byte.
          {
            this->UART->statePort|=0x02;
            this->UART->extraTimeCounter++;
            this->UART->myWDT->restartWdt();
          }
          else
          {
            this->UART->clearRxBuffPointer(); // Inicializa puntero de Rx en el Buffer de Rx de Comunicaciones Serie
            this->UART->extraTimeCounter=0;
            this->UART->strRxLen=0;
            this->UART->commTries++;
            if(this->UART->commTries>this->UART->tries) // Cantidad de intentos de retransmisión en caso de que no haya recibido ningún byte en respuesta.
            { //Finaliza retransimisiones a GPRS en caso de que no exista respuesta de Tx del modem
              if(this->isModemGPRSOn())
              {
                  if((this->stateGPRS&BIT1) && !(this->stateGPRS&BIT3)) // Sesion GPRS Abierta?
                  {
                    this->stateGPRS|=BIT3;
                    if(this->stateGPRS&BIT5) // Se encuentra en línea de datos GPRS?
                    {
                      this->OFFfromGPRSSession();
                    }
                    else
                    {
                      this->OffModemGPRS();
                    }
                  }
                  else
                  {
                    if((this->stateGPRS&BIT0) && !(this->stateGPRS&BIT3)) // Se pidió comando AT ?
                    {/////////////////////////////////////////////////////////////////////////
                      this->stateGPRS|=BIT3;
                      if(this->commCounter==0||this->commCounter==5||this->commCounter==22)
                      {
                        //this->stateGPRS|=BIT6;
                        this->OFFfromGPRSSession();
                      }
                      else
                      {
                        this->OffModemGPRS();
                        //////////////////////////////////////////////////////////////////////
                      }
                    }
                    else
                    {
                      this->turnOFF_VCC_GPRS();
                      this->stateGPRS&=~(BIT0|BIT1|BIT3|BIT5); // Deshabilita bandera de solicitud de comando AT
                      this->UART->clearBufferRx();
                      this->UART->commTries=0;
                      this->UART->strRxLen=0;
                      this->UART->UartError&=~0x01;
                      resp=1; //3// 1
                    }
                  }
              }
              else // Finaliza por completo las comunicaciones
              {
                  this->turnOFF_VCC_GPRS();
                  this->stateGPRS&=~(BIT0|BIT1|BIT3|BIT5); // Deshabilita bandera de solicitud de comando AT
                  this->UART->clearBufferRx();
                  this->UART->commTries=0;
                  this->UART->strRxLen=0;
                  this->UART->UartError&=~0x01;
                  resp=1; //3// 1
              }
            }
            else // Retransmite último comando solicitado.
            {
              if(this->isModemGPRSOn())
              {
                if(this->isIPSessionOpen())
                {
                  if(this->stateGPRS&BIT5)
                  {
                    this->OFFfromGPRSSession();
                  }
                  else
                  {
                    this->OffModemGPRS();
//                    this->SetFormatMessage((char*)this->UART->Buffer_Tx, SatLogg, mItzyFlow, memHandler, SerialNumber);
//                    this->sendStringGPRS((char*)this->UART->Buffer_Tx);
                  }
                }
                else
                {
                  this->stateGPRS&=~BIT0; // Deshabilita bandera de solicitud de comando AT
                  this->sendFrameToGPRS(this->commCounter);
                }
              }
              else
              { // Finaliza comunicaciones
                  this->turnOFF_VCC_GPRS();
                  this->stateGPRS&=~(BIT0|BIT1|BIT3|BIT5); // Deshabilita bandera de solicitud de comando AT
                  this->UART->clearBufferRx();
                  this->UART->commTries=0;
                  this->UART->strRxLen=0;
                  this->UART->UartError&=~0x01;
                  resp=1; //3// 1

              }
            }
          }
        }
      //}
    }
  }
  return resp;
}
/****************************************************************************************************/
void CGPRS::disableSendingReport()
{
  this->stateGPRS&=~BIT2;
}
/****************************************************************************************************/
void CGPRS::enableSendingReport()
{
  this->stateGPRS|=BIT2;
}
/****************************************************************************************************/
bool CGPRS::isEnableSendingReport()
{
  if(this->stateGPRS&BIT2)
  {
    return true;
  }
  return false;
}
/****************************************************************************************************/
char* CGPRS::getAddrFlagsUARTstate()
{
  return &this->UART->statePort;
}
/****************************************************************************/
void CGPRS::OnModemGPRS()
{
  this->turnON_VCC_GPRS();
  P1OUT|=ON_OFF_GPRS; // Establece el puerto como entrada (Envia a 1)
}
/****************************************************************************/
void CGPRS::OffModemGPRS()
{
  P1OUT&=~ON_OFF_GPRS;  // Establece el puerto como salida (Envia a 0)

  this->turnOFF_VCC_GPRS();

  this->commCounter=12;
  this->endCommandIndex=12;
  this->sendFrameToGPRS(this->commCounter);
}
/****************************************************************************/
bool CGPRS::isModemGPRSOn()
{
  bool resp=false;
  if(P1IN & ON_OFF_Modem_VCC)
  {
    if(!(P6IN & BitFlag_ONGPRS))
    { resp=true;}
  }
  return resp;
}
/****************************************************************************/
void CGPRS::turnON_VCC_GPRS()
{
  P6DIR|=(ON_OFF_RS232|ENABLE_RS232);
  P6OUT|=ENABLE_RS232;
  P6OUT&=~ON_OFF_RS232;

  P1DIR|=W_ENABLE_GPRS;
  P1OUT|=(ON_OFF_Modem_VCC|W_ENABLE_GPRS);
}
/****************************************************************************/
void CGPRS::turnOFF_VCC_GPRS()
{
  P1OUT&=~(ON_OFF_Modem_VCC|W_ENABLE_GPRS);
}
/****************************************************************************/
/*unsigned long CGPRS::SC_OriginatedDefMsg(char* Buffer, CLogger* mLoggerSAT, CMPG2* mMPG2, CEEPROM *memHandler, char qtyMed)
{
  // Establecer en loggerSAt un límite de 0x300 datos
  int x=0, x_Acum=0;
  int y;
  char indexMed,reg_temp1;
  int p_startBlk,l_NBlocks;
  Buffer[x++]=0x0A;//commandHeader;
  Buffer[x++]=0x07; // # de comando
  x+=2;
  Buffer[x++]=0x05;//this->retry;
//  if(this->mha==0x00)
//  {this->mha=0x01;}
  Buffer[x++]=0xA0;//this->mha++;

  x_Acum+=x;

  for(indexMed=0;indexMed<*mMPG2->getNMedidores();indexMed++)
{
  x=0;

  switch(indexMed)
  {
  case 1: p_startBlk=3105; //0x061080;
          break;
  case 2: p_startBlk=3137; //0x062080;
          break;
  case 3: p_startBlk=3169; //0x063080;
          break;
  case 0: p_startBlk=3073; //0x060080;

  default: break;
  }

  l_NBlocks=(*(mMPG2->Flowmeter[indexMed]->getPointerWrite())-1)/128;
  if((l_NBlocks-(p_startBlk-2))>0)
  {
    for(;p_startBlk<=l_NBlocks+1;p_startBlk++)
    {
      mLoggerSAT->readLoggDataByBlk(&Buffer[x_Acum+x], memHandler, p_startBlk); // Solo para una memoria de 128 KB
      x+=128;
    }

    y=(*(mMPG2->Flowmeter[indexMed]->getPointerWrite()) & 0x0000007F);
    if(y)
    {
      x-=(128-y);
    }
    x_Acum+=x;

    if(indexMed==0) // Evalua si se obtuvieron datos de los primeros regitros del medidor 1 para obtener la cantidad de registros.
    {
      x-=11; // 11 corresponde a la cantidad de bytes de la cabecera que se inserta al inicio de los registros a enviar (1er medidor).
      reg_temp1=*mMPG2->Flowmeter[0]->getIDVariable();
      switch(reg_temp1) // Evalua el ID de tipo de variables leeidas del medidor 1
      {
      case 4:
      case 1:  reg_temp1=7; break;
      case 5:
      case 2:  reg_temp1=5; break;
      case 6:
      case 3:  reg_temp1=3; break;
      case 0:
      default: reg_temp1=9; break;
      }
      reg_temp1=(x/reg_temp1);
      Buffer[16]=reg_temp1; // Posición de byte identificador de cantidad de resgitros enviados.
    }
  }
  else
  {
    // Código para ensamblar la trama satelital para error de enlace de telemetría con Scadapack
    mLoggerSAT->readLoggDataByBlk(&Buffer[x_Acum], memHandler, 3073); // Solo para una memoria de 128 KB
    x_Acum+=8;
    break;
    //return 0;
  }

  }

  if(x_Acum>6)
  {
//    Establece la cantidad de datos a enviar
    Buffer[2]=(x_Acum+2)&0x00FF;         // LSB Length
    Buffer[3]=((x_Acum+2)/0x100)&0x00FF; // MSB Length


    // Calculo de CRC
    unsigned int l_CRC=this->calcFletcherCRC(Buffer,x_Acum+2);
    Buffer[x_Acum++]=l_CRC & 0x00FF;
    Buffer[x_Acum]=(l_CRC/0x0100)&0x00FF;

    mMPG2->restartWRPointers(0x0000);
    mLoggerSAT->clearNData();

    return ++x_Acum; // Devuelve el tamaño del comando a enviar vía serie
  }
  else
  {
    return 0;
  }

}*/
/**********************************************************************************/
/**********************************************************************************/
char CGPRS::calcCRC(char* xBuffer, int length)
{
  int CRC=0;
  for(int x=0; x<length; x++)
     CRC^=*xBuffer++;
  return CRC+1;
}
/**********************************************************************************/
char CGPRS::getCRCbuffer(char* xBuffer, int length)
{
  length-=4;
  return (asctobcd(xBuffer[length]) * 0x10) | asctobcd(xBuffer[length+1]);
}
/**********************************************************************************/
char CGPRS::asctobcd(char asc)
{
  if (asc>=0x30 && asc<=0x39)
    asc-=0x30;
  else
    asc-=0x37;

  return asc&0x0F;
}
/**********************************************************************************/
unsigned int CGPRS::calcFletcherCRC(char* Buffer, unsigned long length)
{
  char sum1=0x00;
  char sum2=0x00;
  int i;
  *(Buffer+length-1)=0;
  *(Buffer+length-2)=0;
  for(i=0;i<length;i++)
  {
    sum1+=*(Buffer+i);
    sum2+=sum1;
  }
  unsigned int result=(sum1-sum2)&0x00FF;
  result|=((sum2-(2*sum1))*0x0100)& 0xFF00;

  return result;
}
/****************************************************************************************************/
/****************************************************************************/
/*unsigned long CGPRS::SetFormatMessage(char* Buffer, CLogger* mLoggerSAT, CMPG2* mMPG2, CEEPROM *memHandler, char* Nserie, int TZ)
{
  int x=0, x_Acum=0;
  int y;
  char indexMed,reg_temp1;
  int p_startBlk,l_NBlocks;

  reg_temp1=*mLoggerSAT->getPNDataBCD();

  if(reg_temp1 && this->isEnableSendingReport())
  {
    sprintf(&Buffer[x],"%.3d",reg_temp1);
    x=10;
    for(indexMed=0;indexMed<*mMPG2->getNMedidores();indexMed++)
    {
      switch(indexMed)
      {
//        0x060000,0x061000,0x062000,0x063000
      case 1: p_startBlk=3105; //0x061080;
              break;
      case 2: p_startBlk=3137; //0x062080;
              break;
      case 3: p_startBlk=3169; //0x063080;
              break;
      case 0: p_startBlk=3073; //0x060080;
      default: break;
      }

      l_NBlocks=(*(mMPG2->Flowmeter[indexMed]->getPointerWrite())-1)/128;
      if((l_NBlocks-(p_startBlk-2))>0)
      {
        for(;p_startBlk<=l_NBlocks+1;p_startBlk++)
        {
          mLoggerSAT->readLoggDataByBlk(&Buffer[x_Acum+x], memHandler, p_startBlk); // Solo para una memoria de 128 KB
          x+=128;
        }
        y=(*(mMPG2->Flowmeter[indexMed]->getPointerWrite()) & 0x0000007F);
        if(y)
        {
          x-=(128-y);
        }
      }
      strcpy(&Buffer[x],"END BLOCK\r\n");
      x=23;       // Almacena la cantidad de registros en la cadena a enviar
      Buffer[x++]=Buffer[0];
      Buffer[x++]=Buffer[1];
      Buffer[x++]=Buffer[2];
      x=0;        // Establece el comando de envío de reporte
      Buffer[x++]='H';
      Buffer[x++]='G';
      Buffer[x++]='P';
      Buffer[x++]='R';
      Buffer[x++]='S';
      Buffer[x++]='D';
      Buffer[x++]='A';
      Buffer[x++]='T';
      Buffer[x++]='A';
      Buffer[x++]=':';

      x=strlen(Buffer);
      Buffer[x++]=0x03;   //Caracter para fin de página vía HTTP
      Buffer[x++]=0x00;
    }

//    mItzyFlow->restartWRPointers();
//    mLoggerSAT->clearNData();
    x=strlen(Buffer); // Devuelve el tamaño del comando a enviar vía serie
    return x;
  }
  else
  {
    if(mMPG2->get_ID_Rep()!=0x31)
    {
      if(!this->isEnableSendingReport()) // Se ejecuta como reporte de espera para volver a enviar datos cada hora en caso que esté deshabilitado para enviar el reporte
      {
        strcpy(&Buffer[x],"END BLOCK\r\n");
        x=strlen(Buffer);
//        mItzyFlow->restartWRPointers();
//        mLoggerSAT->clearNData();
        return x;
      }
      else
      {
        return 0;
      }
    }
    else
    {
      Buffer[x++]='H';
      Buffer[x++]='G';
      Buffer[x++]='P';
      Buffer[x++]='R';
      Buffer[x++]='S';
      Buffer[x++]='D';
      Buffer[x++]='A';
      Buffer[x++]='T';
      Buffer[x++]='A';
      Buffer[x++]=':';
      Buffer[x++]=mMPG2->get_ID_Rep();
      Buffer[x++]=',';
      strncpy((char*)&Buffer[x],Nserie,10);
      x+=10;
      sprintf((char*)&Buffer[x],",%.2d",TZ);
      x+=3;
      if(TZ < 0)
      {
         x++;
      }
      strcpy(&Buffer[x],"\r\nEND BLOCK\r\n");

      x=strlen(Buffer);
      Buffer[x++]=0x03;   //Caracter para fin de página vía HTTP
      Buffer[x++]=0x00;
//      mItzyFlow->restartWRPointers();
//      mLoggerSAT->clearNData();
      return x;
    }
  }
}*/
/****************************************************************************/
unsigned long CGPRS::SetFormatMessage(char* Buffer, CLogger* mLoggerSAT, CMPG2* mMPG2, CEEPROM *memHandler, char* Nserie, int TZ)
{
  int x=0, x_Acum=0;
  int y;
  //char indexMed,
  char reg_temp1;
  int p_startBlk,l_NBlocks;

  p_startBlk=0;
  reg_temp1=*mLoggerSAT->getPNDataBCD();

  if(reg_temp1 && this->isEnableSendingReport())
  {
    sprintf(&Buffer[x],"%.3d",reg_temp1);
    x=10;
    //for(indexMed=0;indexMed<*mMPG2->getNMedidores();indexMed++)
    //{
      /*switch(indexMed)
      {
//        0x060000,0x061000,0x062000,0x063000
      case 1: p_startBlk=3105; //0x061080 / 128;
              break;
      case 2: p_startBlk=3137; //0x062080;
              break;
      case 3: p_startBlk=3169; //0x063080;
              break;
      case 0: p_startBlk=3073; //0x060080;
      default: break;
      }*/
    if(*mMPG2->getNMedidores())
    {
      p_startBlk=3105;  // (0x061080 / 128 bytes);
    }

      l_NBlocks=(*(mMPG2->Flowmeter[1]->getPointerWrite())-1)/128;
      if((l_NBlocks-(p_startBlk-2))>0)
      {
        for(;p_startBlk<=l_NBlocks+1;p_startBlk++)
        {
          mLoggerSAT->readLoggDataByBlk(&Buffer[x_Acum+x], memHandler, p_startBlk); // Solo para una memoria de 128 KB
          x+=128;
        }
        y=(*(mMPG2->Flowmeter[1]->getPointerWrite()) & 0x0000007F);
        if(y)
        {
          x-=(128-y);
        }
      }
      strcpy(&Buffer[x],"END BLOCK\r\n");
      x=23;       // Almacena la cantidad de registros en la cadena a enviar
      Buffer[x++]=Buffer[0];
      Buffer[x++]=Buffer[1];
      Buffer[x++]=Buffer[2];
      x=0;        // Establece el comando de envío de reporte
      Buffer[x++]='H';
      Buffer[x++]='G';
      Buffer[x++]='P';
      Buffer[x++]='R';
      Buffer[x++]='S';
      Buffer[x++]='D';
      Buffer[x++]='A';
      Buffer[x++]='T';
      Buffer[x++]='A';
      Buffer[x++]=':';

      x=strlen(Buffer);
      Buffer[x++]=0x03;   //Caracter para fin de página vía HTTP
      Buffer[x++]=0x00;
    //}

//    mItzyFlow->restartWRPointers();
//    mLoggerSAT->clearNData();
    x=strlen(Buffer); // Devuelve el tamaño del comando a enviar vía serie
    return x;
  }
  else
  {
    if(mMPG2->get_ID_Rep()!=0x31)
    {
      if(!this->isEnableSendingReport()) // Se ejecuta como reporte de espera para volver a enviar datos cada hora en caso que esté deshabilitado para enviar el reporte
      {
        strcpy(&Buffer[x],"END BLOCK\r\n");
        x=strlen(Buffer);
//        mItzyFlow->restartWRPointers();
//        mLoggerSAT->clearNData();
        return x;
      }
      else
      {
        return 0;
      }
    }
    else
    {
      Buffer[x++]='H';
      Buffer[x++]='G';
      Buffer[x++]='P';
      Buffer[x++]='R';
      Buffer[x++]='S';
      Buffer[x++]='D';
      Buffer[x++]='A';
      Buffer[x++]='T';
      Buffer[x++]='A';
      Buffer[x++]=':';
      Buffer[x++]=mMPG2->get_ID_Rep();
      Buffer[x++]=',';
      strncpy((char*)&Buffer[x],Nserie,10);
      x+=10;
      sprintf((char*)&Buffer[x],",%.2d",TZ);
      x+=3;
      if(TZ < 0)
      {
         x++;
      }
      strcpy(&Buffer[x],"\r\nEND BLOCK\r\n");

      x=strlen(Buffer);
      Buffer[x++]=0x03;   //Caracter para fin de página vía HTTP
      Buffer[x++]=0x00;
//      mItzyFlow->restartWRPointers();
//      mLoggerSAT->clearNData();
      return x;
    }
  }
}
/**********************************************************************************/
void CGPRS::OFFfromGPRSSession()
{
  P1OUT&=~ON_OFF_GPRS;  // Establece el puerto como salida (Envia a 0)
  this->commCounter=11;
  this->endCommandIndex=12;
  this->sendFrameToGPRS(this->commCounter);
}
/**********************************************************************************/
void CGPRS::setIP_Port(char* IP_Port_Buff, int len)
{
  int x;
  for(x=0;x<len;x++)
  {
    this->IP_PORT[x]=IP_Port_Buff[x];
  }
  this->IP_PORT[x]='\0';
}
/**********************************************************************************/
bool CGPRS::isIPSessionOpen()
{
  bool resp=false;

  if(this->stateGPRS&BIT1)
  {resp=true;}

  return resp;
}
/**********************************************************************************/
char* CGPRS::evalAndExecuteReqRemote(char* Buffer)
{
  char* p_Char=Buffer;
//  bool resp=false;

      p_Char=strstr(p_Char,"H");
      if(p_Char)
      {
        p_Char++;
        switch(*p_Char)
        {
        case 'W':
                 p_Char++;
                 switch(*p_Char)
                 {
                 case 'R':
                          p_Char++;
                          switch(*p_Char)
                          {
                          case 'D':
                                   p_Char+=2;
                                   if(*p_Char == 'E')
                                   {
                                     this->enableSendingReport();
                                   }
                                   else if(*p_Char == 'D')
                                   {
                                     this->disableSendingReport();
                                   }
                                   else
                                   {
                                     p_Char=0;
                                   }
                                   break;
                          default: p_Char=0; break;
                          }
                          break;
                 default: p_Char=0; break;
                 }
                 break;
        default: p_Char=0; break;

        }

      }

return p_Char;
}
/**********************************************************************************/
char* CGPRS::getAPN()
{
  return &this->APN_GPRS_SERV[0];
}
/**********************************************************************************/
char* CGPRS::getAPNUser()
{
  return &this->APN_GPRS_USER[0];
}
/**********************************************************************************/
char* CGPRS::getAPNPSW()
{
  return &this->APN_GPRS_PSW[0];
}
/**********************************************************************************/
char* CGPRS::getDNS()
{
  return &this->DNS[0];
}
/**********************************************************************************/
char* CGPRS::getIPPort()
{
  return &this->IP_PORT[0];
}
/**********************************************************************************/
char* CGPRS::getSPName()
{
  if(this->ID_SERV_PROV<3)
  {
    return (char*)APN_Providers[(this->ID_SERV_PROV*4)+3];
  }
  else
  {
    return "Personalizado";
  }
}
/**********************************************************************************/
char* CGPRS::getIDSP()
{
  return &this->ID_SERV_PROV;
}
/**********************************************************************************/
void CGPRS::setIDSP(int ID)
{
  this->ID_SERV_PROV=ID;
  this->setAPNConf(&this->ID_SERV_PROV);
}
/**********************************************************************************/
char* CGPRS::getAPNPorvByIndexList(int index)
{
  return (char*) APN_Providers[(index*4)+3];
}
/**********************************************************************************/
// El codigo evalúa sobre los separadores del formato de fecha y cantidad de dígitos del mes.
//int CMPG2::evalMedidorRxString(char* BufferRx,int RxLength,char* SerNo,CLogger* m_Logger,CRTC_3029_I2C *Reloj,CEEPROM *memory,char* dns,char* ipPort, char *apnName,char *apnUser, char *apnPsw, char *idSP)
int CGPRS::evalBluetoothRxString(char* BufferRx,int RxLength,char* SerNo,CLogger* m_Logger,CLogger* m_LoggerGPRS,CRTC_3029_I2C *Reloj,CEEPROM *memory,CMPG2* mMPG2,char* Localization,char* l_RFC, char* mNoSerExt,char* mIDMedSM,char* mID_UV,char* mPassword,CFATDriver* mFatDrv)
{
   int response=0x00,x;
   char *RxPos, *temp_ch1;
   int respLength=0;

   char* BufferTx=&BufferRx[0];
   int BufferRec[7];

   //if(RxLength>50)
   //{

   char m_CRC;

    this->flags_req_info&=~BIT7;
/*   if(this->requestData)
   {
    m_CRC=calcCRC(BufferRx,RxLength-4);
    if(m_CRC==this->getCRCbuffer(BufferRx, RxLength))
    {
      response=0x01;
    }
   }
  */
   //else
   //{// Código para evaluar comandos externos para configuración de equipo

      m_CRC=calcCRC(BufferRx,RxLength-4);
      if(m_CRC==this->getCRCbuffer(BufferRx, RxLength))
      {
      RxPos=strstr(BufferRx,"H");
      if(RxPos)
      {
        if(this->evalSN(SerNo,RxPos+5))
        {
        RxPos++;
        switch(*RxPos++)
        {
        case 'W':
                  if(this->isValidatedPasswordFlag())
                  {
                  this->flags_req_info|=BIT7;
                  switch(*RxPos++)
                  {
                    case 'A':
                              switch(*RxPos)
                              {
                              case 'N': // Writes on Alarm Number Register OK
                                      sscanf(&BufferRx[16],"%2d",&BufferRec[0]);
                                      Reloj->setNAlarms((char)BufferRec[0]);
                                      sprintf(&BufferTx[5],"%s","OK;");
                                      respLength=8;
                                      break;
                              case 'R': // Writes one alarm hour register in the index specified (Nregister goes from 0 to 23) OK
                                      sscanf(&BufferRx[16],"%2d%2d%2d",&BufferRec[0],&BufferRec[1],&BufferRec[2]); // Nreg hh mm
                                      Reloj->setAlarm((char)BufferRec[0],(char)BufferRec[1],(char)BufferRec[2]);
                                      sprintf(&BufferTx[5],"%s","OK;");
                                      respLength=8;
                                      break;
                              default:
                                      break;
                              }
                              break;
                    case 'C':
                              switch(*RxPos)
                              {
                                case 'D': // Cambiar DNS & IP_PORT OK
                                          // HWCD:www.google.com,80
                                         RxPos+=2;
                                         RxPos=strstr(RxPos,";");
                                         if(RxPos)
                                         {
                                           RxPos++;
                                           temp_ch1=strstr(RxPos,";");
                                           BufferRec[0]=temp_ch1-RxPos;
                                           //strncpy(dns,RxPos,BufferRec[0]);
                                           strncpy(this->DNS,RxPos,BufferRec[0]);
                                           //dns[BufferRec[0]]='\0';
                                           this->DNS[BufferRec[0]]='\0';

                                           temp_ch1++;
                                           RxPos=strstr(temp_ch1,";");
                                           BufferRec[0]=RxPos-temp_ch1;
                                           //strncpy(ipPort,temp_ch1,BufferRec[0]);
                                           strncpy(this->IP_PORT,temp_ch1,BufferRec[0]);
                                           //ipPort[BufferRec[0]]='\0';
                                           this->IP_PORT[BufferRec[0]]='\0';

                                           sprintf(&BufferTx[5],"%s","OK;");
                                           respLength=8;
                                         }
                                         break;

                                /*case 'S':       // Cerrar sesión de configuración
                                         break;*/
                                default: break;
                              }
                              break;
                    case 'D':
                                switch(BufferRx[3])
                                {
                                case 'T': // Fecha y hora del sistema OK
                                         sscanf(&BufferRx[16],"%2d%2d%4d%2d%2d%2d%3d",(int*)&BufferRec[0],(int*)&BufferRec[1],(int*)&BufferRec[2],(int*)&BufferRec[3],(int*)&BufferRec[4],(int*)&BufferRec[5],(int*)&BufferRec[6]);
                                         Reloj->hexToBcdRTC(BufferRec);
                                         Reloj->setHour_Date(memory);
                                         Reloj->setRTCOnIntTime(memory,false);
                                         Reloj->setTimeZone(BufferRec[6]);
                                         sprintf(&BufferTx[5],"%s","OK;");
                                         respLength=8;
                                         break;
                                default: break;
                                }
                                break;
                    case 'I': // Escritura en registro de Identifocador Medidor o Sistema de Medición
                                switch(*RxPos)
                                {
                                case 'S':
                                          RxPos+=2;
                                          RxPos=strstr(RxPos,";");
                                          if(RxPos)
                                          {
                                            RxPos++;
                                            temp_ch1=strstr(RxPos,";");
                                            BufferRec[0]=temp_ch1-RxPos;
                                            strncpy((char*)&mIDMedSM[0],RxPos,BufferRec[0]);
                                            mIDMedSM[BufferRec[0]]='\0';
                                            sprintf(&BufferTx[5],"%s","OK;");
                                            respLength=8;
                                          }
                                          break;
                                default:  break;
                                }
                                break;
                    case 'L':
                                switch(BufferRx[3])
                                {
                                case 'C': // Almacena localización del equipo en Latitud y Longitud
                                         RxPos+=2;
                                         RxPos=strstr(RxPos,";");
                                         if(RxPos)
                                         {
                                           for(x=0;x<2;x++)
                                           {
                                            RxPos++;
                                            temp_ch1=strstr(RxPos,";");
                                            BufferRec[0]=temp_ch1-RxPos;
                                            //strncpy(apnName,RxPos,BufferRec[0]);
                                            strncpy((char*)&Localization[12*x],RxPos,BufferRec[0]);
                                            //apnName[BufferRec[0]]='\0';
                                            Localization[BufferRec[0]+(12*x)]='\0';
                                            RxPos=temp_ch1;
                                           }
                                           sprintf(&BufferTx[5],"%s","OK;");
                                           respLength=8;
                                         }
                                         break;
                                case 'G':// Establecer tiempo de recolección y estado del logger para envíos de reportes GPRS OK
                                         m_Logger=m_LoggerGPRS;
                                case 'T': // Establecer tiempo de recolección y estado del logger local (Memoria SD) OK
                                         sscanf(&BufferRx[16],"%2d",(int*)&respLength);
                                         m_Logger->setIndexSampleTime(respLength);
                                         if(BufferRx[19]=='D')
                                         {m_Logger->disableLogg();}
                                         else
                                         {m_Logger->enableLogg();}
                                         sprintf(&BufferTx[5],"%s","OK;");
                                         respLength=8;
                                         break;
                                default: break;
                                }
                                break;

                     case 'M': // Solicitud para borrar la recolección por año sobre la memoria SD Card
                                switch(BufferRx[3])
                                {
                                case 'C': // Formato de entrada (MM/YYYY)
                                         //sscanf(&BufferRx[16],"%4x%4x",(unsigned int*)&BufferRec[1],(unsigned int*)&BufferRec[0]);
                                         //mFatDrv->SDMem->RD_Addr=*(unsigned long*)&BufferRec[0];
                                         //mFatDrv->SDMem->RD_Addr=(unsigned long int)(((unsigned long)BufferRec[0]&0x000000FF)*0x01000000)|((BufferRec[1]&0x000000FF)*0x00010000)|((BufferRec[2]&0x000000FF)*0x00000100)|((BufferRec[3]&0x000000FF)*0x00000001);
                                         //Reloj->hexToBcdRTC(BufferRec);
                                         this->flags_req_info|=BIT1;
                                         break;
                                default: break;
                                }
                                break;
                    case 'N': // Solicitud para almacenar un nuevo RFC asociado a la telemetría
                              switch(*RxPos)
                              {
                              case 'C':
                                        RxPos+=2;
                                        RxPos=strstr(RxPos,";");
                                        if(RxPos)
                                        {
                                          RxPos++;
                                          temp_ch1=strstr(RxPos,";");
                                          BufferRec[0]=temp_ch1-RxPos;
                                          strncpy((char*)&l_RFC[0],RxPos,BufferRec[0]);
                                          l_RFC[BufferRec[0]]='\0';
                                          sprintf(&BufferTx[5],"%s","OK;");
                                          respLength=8;
                                        }
                                        break;
                              case 'E':
                                          RxPos+=2;
                                          RxPos=strstr(RxPos,";");
                                          if(RxPos)
                                          {
                                            RxPos++;
                                            temp_ch1=strstr(RxPos,";");
                                            BufferRec[0]=temp_ch1-RxPos;
                                            strncpy((char*)&mNoSerExt[0],RxPos,BufferRec[0]);
                                            mNoSerExt[BufferRec[0]]='\0';
                                            sprintf(&BufferTx[5],"%s","OK;");
                                            respLength=8;
                                          }
                                          break;
                              default:  break;
                              }
                              break;
                    case 'P': // Escritura en el registro de Password de Adminsitración del sistema de telemetría
                                switch(*RxPos)
                                {
                                case 'W':
                                          RxPos+=2;
                                          RxPos=strstr(RxPos,";");
                                          if(RxPos)
                                          {
                                            RxPos++;
                                            temp_ch1=strstr(RxPos,";");
                                            BufferRec[0]=temp_ch1-RxPos;
                                            strncpy((char*)&mPassword[0],RxPos,BufferRec[0]);
                                            mPassword[BufferRec[0]]='\0';
                                            sprintf(&BufferTx[5],"%s","OK;");
                                            respLength=8;
                                          }
                                          break;
                                default:  break;
                                }
                                break;
                    case 'S':
                              switch(*RxPos)
                              {
                                case 'P':       // Configurar APN, USUARIO y PASSWORD proveedor de servicio GPRS.OK
                                  // HWSP:internet.itelcel.com,webgprs,webgprs
                                         RxPos+=2;
                                         RxPos=strstr(RxPos,";");
                                         if(RxPos)
                                         {
                                           RxPos++;
                                           temp_ch1=strstr(RxPos,";");
                                           BufferRec[0]=temp_ch1-RxPos;
                                           //strncpy(apnName,RxPos,BufferRec[0]);
                                           strncpy(this->APN_GPRS_SERV,RxPos,BufferRec[0]);
                                           //apnName[BufferRec[0]]='\0';
                                           this->APN_GPRS_SERV[BufferRec[0]]='\0';

                                           temp_ch1++;
                                           RxPos=strstr(temp_ch1,";");
                                           BufferRec[0]=RxPos-temp_ch1;
                                           //strncpy(apnUser,temp_ch1,BufferRec[0]);
                                           strncpy(this->APN_GPRS_USER,temp_ch1,BufferRec[0]);
                                           //apnUser[BufferRec[0]]='\0';
                                           this->APN_GPRS_USER[BufferRec[0]]='\0';

                                           RxPos++;
                                           temp_ch1=strstr(RxPos,";");
                                           BufferRec[0]=temp_ch1-RxPos;
                                           //strncpy(apnPsw,RxPos,BufferRec[0]);
                                           strncpy(this->APN_GPRS_PSW,RxPos,BufferRec[0]);
                                           //apnPsw[BufferRec[0]]='\0';
                                           this->APN_GPRS_PSW[BufferRec[0]]='\0';

                                           //*idSP=0x03;
                                           this->ID_SERV_PROV=0x03;
                                           sprintf(&BufferTx[5],"%s","OK;");
                                           respLength=8;
                                         }
                                         break;

                                default: break;
                              }
                              break;

                    case 'U': // Escritura en registro de Unidad Verificadora (4 caracteres ASCII)
                                switch(*RxPos)
                                {
                                case 'R':
                                          this->flags_req_info|=BIT2;
                                case 'V':
                                          RxPos+=2;
                                          RxPos=strstr(RxPos,";");
                                          if(RxPos)
                                          {
                                            RxPos++;
                                            temp_ch1=strstr(RxPos,";");
                                            BufferRec[0]=temp_ch1-RxPos;
                                            strncpy((char*)&mID_UV[0],RxPos,BufferRec[0]);
                                            mID_UV[BufferRec[0]]='\0';
                                            sprintf(&BufferTx[5],"%s","OK;");
                                            respLength=8;
                                          }
                                          break;
                                default:  break;
                                }
                                break;

                    default: break;
                  }

                  }
                  else
                  {
                    this->clearValidatedPasswordFlag();
                    sprintf(&BufferTx[5],"%s","PSW_ERROR;");
                    respLength=15;
                  }
                  break;
        case 'R':
                  switch(BufferRx[2])
                       {
                       case 'A':
                                switch(BufferRx[3])
                                {
                                case 'N': // Reads Alarm number register OK
                                        sprintf((char*)&BufferTx[5],"%.2d;",Reloj->getNAlarms());
                                        respLength=strlen(&BufferTx[0]);
                                        break;
                                 case 'R': // Reads one alarm hour register in the index specified (Nregister goes from 0 to 23) OK
                                      sscanf(&BufferRx[16],"%2d",&BufferRec[0]); // Nreg
                                      sprintf(&BufferTx[5],"%.2d%.2d;",Reloj->alarms[BufferRec[0]]->al_hour,Reloj->alarms[BufferRec[0]]->al_min); // Nreg hh mm
                                      respLength=strlen(&BufferTx[0]);
                                      break;
                                default:
                                        break;
                                }
                                break;
                       case 'C':
                                switch(BufferRx[3])
                                {
                                case 'D': // Read DNS & IP_PORT OK
                                         BufferTx[5]='\0';
                                         //strcat(&BufferTx[0],dns);
                                         strcat(&BufferTx[0],this->DNS);
                                         respLength=strlen(BufferTx);
                                         BufferTx[respLength++]=';';
                                         BufferTx[respLength]='\0';
                                         //strcat(&BufferTx[0],ipPort);
                                         strcat(&BufferTx[0],this->IP_PORT);
                                         respLength=strlen(BufferTx);
                                         BufferTx[respLength++]=';';
                                         break;

                                default: break;
                                }
                                break;
                       case 'D':
                                switch(BufferRx[3])
                                {
                                case 'T': // Fecha y hora del sistema OK
                                         sprintf(&BufferTx[5],"%.2d%.2d%.4d%.2d%.2d%.2d%+.2d;",Reloj->day,Reloj->month,Reloj->year,Reloj->hour,Reloj->min,Reloj->seg,*Reloj->getTimeZone());
                                         respLength=strlen(&BufferTx[0]);
                                         //respLength=20;
                                         break;
                                default: break;
                                }
                                break;
                       case 'F':
                                switch(BufferRx[3])
                                {
                                case 'V':
                                         break;
                                case 'S':
                                        // Gets serial logic number of flowmeter connected
                                         BufferTx[5]='\0';
                                         strcat(&BufferTx[0],(char*)&mMPG2->serialNumber[0]);
                                         respLength=strlen(BufferTx);
                                         BufferTx[respLength++]=';';
                                         break;
                                default: break;
                                }
                                break;
                        case 'I':
                                switch(BufferRx[3])
                                {
                                case 'D': // Lee numero de serie con confirmación del mismo OK
                                         for(respLength=0;respLength<10;respLength++)
                                         {
                                            BufferTx[5+respLength]=*(char*)(SerNo+respLength);
                                         }
                                         BufferTx[5+respLength]=';';
                                         respLength+=6;
                                         break;
                                case 'S': // Lectura del ID de Medidor o Sistema de Medicion
                                         BufferTx[5]='\0';
                                         strcat(&BufferTx[0],(char*)&mIDMedSM[0]);
                                         respLength=strlen(BufferTx);
                                         BufferTx[respLength++]=';';
                                         BufferTx[respLength]='\0';
                                         break;
                                default: break;
                                }
                                break;
                        case 'L':
                                switch(BufferRx[3])
                                {
                                case 'C': // Leer coordenadas de localización en formato UMT
                                         BufferTx[5]='\0';
                                         for(x=0;x<2;x++)
                                         {
                                          strcat(&BufferTx[0],(char*)(&Localization[0]+(12*x)));
                                          respLength=strlen(BufferTx);
                                          BufferTx[respLength++]=';';
                                          BufferTx[respLength]='\0';
                                         }
                                         break;
                                case 'G': // Leer recolección y estado del logger para reportes GPRS OK
                                         m_Logger=m_LoggerGPRS;
                                case 'T': // Leer recolección y estado del logger interno (Memoria SD) OK
                                         sprintf(&BufferTx[5],"%.2d;%.2d;",*m_Logger->getIndexSampleTime(),*m_Logger->getTimeLoggerSatByIndex(*m_Logger->getIndexSampleTime()));
                                         if(m_Logger->isEnabledLogg())
                                         {BufferTx[11]='E';}
                                         else
                                         {BufferTx[11]='D';}
                                         BufferTx[12]=';';
                                         respLength=13;
                                         break;
                                default: break;
                                }
                                break;
                       case 'M': // Solicitud para leer n bloque de memoria específico de la SD Card OK
                                switch(BufferRx[3])
                                {
                                case 'B':
                                         sscanf(&BufferRx[16],"%4x%4x",(unsigned int*)&BufferRec[1],(unsigned int*)&BufferRec[0]);
                                         mFatDrv->SDMem->RD_Addr=*(unsigned long*)&BufferRec[0];
                                         //mFatDrv->SDMem->RD_Addr=(unsigned long int)(((unsigned long)BufferRec[0]&0x000000FF)*0x01000000)|((BufferRec[1]&0x000000FF)*0x00010000)|((BufferRec[2]&0x000000FF)*0x00000100)|((BufferRec[3]&0x000000FF)*0x00000001);
                                         //Reloj->hexToBcdRTC(BufferRec);
                                         this->flags_req_info|=BIT0;
                                         break;
                                default: break;
                                }
                                break;
                       case 'N': // Solicitud para leer el RFC asociado a la telemetría
                                switch(BufferRx[3])
                                {
                                case 'C':
                                         BufferTx[5]='\0';
                                         strcat(&BufferTx[0],(char*)&l_RFC[0]);
                                         respLength=strlen(BufferTx);
                                         BufferTx[respLength++]=';';
                                         BufferTx[respLength]='\0';
                                         break;
                                case 'E':
                                         BufferTx[5]='\0';
                                         strcat(&BufferTx[0],(char*)&mNoSerExt[0]);
                                         respLength=strlen(BufferTx);
                                         BufferTx[respLength++]=';';
                                         BufferTx[respLength]='\0';
                                         break;
                                default: break;
                                }
                                break;
                       case 'P': // Lectura del Password Actual del Sistema
                                switch(BufferRx[3])
                                {
                                case 'A':// Evaluación y confirmación del password del sistema para administrar configuración
                                          RxPos=&BufferRx[5];
                                          RxPos=strstr(RxPos,";");
                                          if(RxPos)
                                          {
                                            RxPos++;

                                            for(x=0;x<5;x++)
                                            {
                                              if(mPassword[x]!=RxPos[x])
                                              {
                                                break;
                                              }
                                            }
                                            if(x<5)
                                            { // Password Incorrect!
                                              this->clearValidatedPasswordFlag();
                                              sprintf(&BufferTx[5],"%s","ERROR;");
                                              respLength=11;
                                            }
                                            else
                                            { // Validated Password
                                              this->setValidatedPasswordFlag();
                                              sprintf(&BufferTx[5],"%s","OK;");
                                              respLength=8;
                                            }
                                          }
                                         break;
                                case 'W': // Lectura de Password Actual del Sistema
                                         BufferTx[5]='\0';
                                         strcat(&BufferTx[0],(char*)&mPassword[0]);
                                         respLength=strlen(BufferTx);
                                         BufferTx[respLength++]=';';
                                         BufferTx[respLength]='\0';
                                         break;
                                default: break;
                                }
                                break;
                       case 'S':
                                switch(BufferRx[3])
                                {
                                case 'P':  // Read APN, USUARIO y PASSWORD proveedor de servicio GPRS. OK
//                                  char *apnName,char *apnUser, char *apnPsw, char *idSP)
                                         BufferTx[5]='\0';
                                         //strcat(&BufferTx[0],apnName);
                                         strcat(&BufferTx[0],this->APN_GPRS_SERV);
                                         respLength=strlen(BufferTx);
                                         BufferTx[respLength++]=';';
                                         BufferTx[respLength]='\0';
                                         //strcat(&BufferTx[0],apnUser);
                                         strcat(&BufferTx[0],this->APN_GPRS_USER);
                                         respLength=strlen(BufferTx);
                                         BufferTx[respLength++]=';';
                                         BufferTx[respLength]='\0';
                                         //strcat(&BufferTx[0],apnPsw);
                                         strcat(&BufferTx[0],this->APN_GPRS_PSW);
                                         respLength=strlen(BufferTx);
                                         BufferTx[respLength++]=';';
                                         break;

                                default: break;
                                }
                       case 'U': // Solicitud para leer el RFC asociado a la telemetría
                                switch(BufferRx[3])
                                {
                                case 'V':
                                         BufferTx[5]='\0';
                                         strcat(&BufferTx[0],(char*)&mID_UV[0]);
                                         respLength=strlen(BufferTx);
                                         BufferTx[respLength++]=';';
                                         BufferTx[respLength]='\0';
                                         break;
                                default: break;
                                }
                                break;
                       default: break;
                       }
                  break;
        default:  break;
        }// fin switch
        }// fin if eval S/N
        else
        {
          switch(BufferRx[0])
          {
          case 'H':
                    switch(BufferRx[1])
                    {
                    case 'R':
                            switch(BufferRx[2])
                            {
                            case 'I':
                                      switch(BufferRx[3])
                                      {
                                      case 'D': // Lee numero de serie sin confirmación OK
                                              for(respLength=0;respLength<10;respLength++)
                                              {
                                                  BufferTx[5+respLength]=*(char*)(SerNo+respLength);
                                              }
                                              BufferTx[5+respLength]=';';
                                              respLength+=6;
                                              break;
                                      default: break;
                                      }
                                      break;

                            default: break;
                            }
                            break;
                    default: break;
                    }
                    break;
          default: break;
          }
        } //Fin else eval S/N
      }// Fin eval "H"
      }// Fin eval CRC Tx externo

    if(respLength)
    {
      BufferTx[4]=':';
      m_CRC=0;
      m_CRC=this->calcCRC(BufferRx,respLength);
      sprintf((char *)&BufferTx[respLength], "%.2X%c%c",m_CRC,'\r','\n');
      respLength+=4;

      //BufferTx[respLength++]=0x0F0;
      //BufferTx[respLength++]=0x9F;
      //BufferTx[respLength++]=0x98;
      //BufferTx[respLength++]=0x83;
      //BufferTx[respLength++]=0x0D;
      //BufferTx[respLength++]=0x0A;
      response=respLength;
    }
    else
    {
      this->flags_req_info&=~BIT7;
    }
//   }

   return response;
}
/***********************************************************/
void CGPRS::setFlagTXExt()
{
  this->flagsTXExt=true;
}
/***********************************************************/
void CGPRS::clearFlagTXExt()
{
  this->flagsTXExt=false;
}
/***********************************************************/
bool CGPRS::getFlagTXExt()
{
  return this->flagsTXExt;
}
/****************************************************************************************************/
int CGPRS::timeOUTExtRxBluetooth(CRTC_3029_I2C *myClock, char* SerialNumber, CLogger* SatLogg, CLogger* loggGPRS, CMPG2* mMPG2, CEEPROM *memHandler, char* Localization, char* mRFC, char* mNoSerExt, char* mIDMedSM, char* mID_UV, char* mPassword, CFATDriver* mFatDrv)
{
  int resp=0;
  int ID_Eval=0;

//  unsigned int dataSize;
//  char Buffer[4];
  if(this->UART->statePort&0x02)  // Comunicaciones Tx o Rx del módulo Satelital o puerto local?
  {

    this->UART->myWDT->stopWdt();
    this->UART->statePort&=~0x02;

    if (this->UART->UartError==0x01)  // Verifica si existe Error de Over flow del buffer de Rx.
    {
      this->UART->UartError&=~0x01;
      this->UART->clearRxBuffPointer(); // Inicializa puntero de Rx en el Buffer de Rx de Comunicaciones Serie
      this->UART->clearBufferRx();
      this->stateGPRS&=~BIT0; // Deshabilita bandera de solicitud de comando AT
      this->UART->commTries=0;
      this->UART->strRxLen=0;
      this->UART->statePort&=~0x02;
    }
    else
    {
        if(this->UART->strRxLen)// Se recibió una cadena de datos?
        {
          this->UART->Buffer_Rx[this->UART->strRxLen]=0x00; //Inserta 0 al final de la cadena recibida
          // Código para verificar comandos cuando son solicitados via comando AT
          ID_Eval=this->evalBluetoothRxString((char*)this->UART->Buffer_Rx, this->UART->strRxLen, SerialNumber,SatLogg,loggGPRS,myClock,memHandler,mMPG2,Localization,mRFC,mNoSerExt,mIDMedSM,mID_UV,mPassword,mFatDrv);

          this->turnOFF_VCC_GPRS();
          this->stateGPRS&=~(BIT0|BIT1|BIT3|BIT5);
          this->UART->UartError&=~0x01;
          this->UART->clearRxBuffPointer(); // Inicializa puntero de Rx en el Buffer de Rx de Comunicaciones Serie
          this->UART->extraTimeCounter=0;
          this->UART->commTries=0;
          this->stateGPRS&=~BIT0; // Deshabilita bandera de solicitud de comando AT
          this->UART->statePort&=~0x02;

          if(ID_Eval)
          {
            // this->turnOFF_VCC_GPRS();
            // this->stateGPRS&=~(BIT0|BIT1|BIT3|BIT5);
            // this->UART->UartError&=~0x01;
            // this->UART->clearRxBuffPointer(); // Inicializa puntero de Rx en el Buffer de Rx de Comunicaciones Serie
            this->UART->strRxLen=0;
            //this->UART->clearBufferRx();
            // this->UART->extraTimeCounter=0;
            // this->UART->commTries=0;
            // this->stateGPRS&=~BIT0; // Deshabilita bandera de solicitud de comando AT
            //this->UART->statePort&=~0x02;
            this->sendStringToUART((char*)this->UART->Buffer_Rx, ID_Eval);

          }
          else
          {

            // this->turnOFF_VCC_GPRS();
            // this->stateGPRS&=~(BIT0|BIT1|BIT3|BIT5);
            // this->UART->UartError&=~0x01;
            // this->UART->clearRxBuffPointer(); // Inicializa puntero de Rx en el Buffer de Rx de Comunicaciones Serie
            if(!(*this->getFlags_reqInfo() & BIT1))
            {
              this->UART->strRxLen=0;
              this->UART->clearBufferRx();
            }
            //this->UART->extraTimeCounter=0;
            //this->UART->commTries=0;
            //this->stateGPRS&=~BIT0; // Deshabilita bandera de solicitud de comando AT
            //this->UART->statePort&=~0x02;
          }

        } // Fin if si se recibió una cadena de datos
        else // si no recibió una cadena de datos del modem satelital y se esperaba dependiendo el comando solicitado
        {

        }
      //}
    }
  }
  return resp;
}
/****************************************************************************************************/
bool CGPRS::evalSN(char* bufferRef,char* buffertoEval)
{
 int i;
 bool resp = false;
 for(i=0;i<10;i++)
 {
   if(bufferRef[i]!=buffertoEval[i])
   {
     resp=false;
     break;
   }
   else
   {
     resp=true;
   }
 }
  return resp;
}
/****************************************************************************/
char* CGPRS::getFlags_reqInfo()
{
  return &this->flags_req_info;
}
/****************************************************************************/
void CGPRS::setValidatedPasswordFlag()
{
  this->validatePassword=true;
}
/****************************************************************************/
void CGPRS::clearValidatedPasswordFlag()
{
  this->validatePassword=false;
}
/****************************************************************************/
bool CGPRS::isValidatedPasswordFlag()
{
  return this->validatePassword;
}
/****************************************************************************/
