Bolagnos/Telemeteria-Bluetooth-Hidronica/Telemetría Hidronica con bluetooth/Firmware/MSP430/Logger MPG2 GPRS V2.1 EC_Prog_ modem/Firmware/CModule.h

#include "CDevice.h"
#include "string"

#define Num_ser_flash 0x1000
#define ID_Producto   27 // Cambiarlo a ID 27
#define ID_Version    2
//Num_ser_flash es el número de serie ASCII de 6 bytes en el formato CCDDDD
// CC:    Año de produccion
// DDDD:  Numero de serie consecutivo
/*********************************************************************/
class CModule
{
private:
   int mx,my;
   int IDMenu;
   int respIDMenu;
   char IDProduct[2];     // Variable de inicio que conforma el número de serie
   char NVersion[2];
   char ProdYear[2];
   char SerialNumber[4];  // Variable final que conforma el número de serie (10 bytes en total)

//   int IDMenuPass;
   char SysPass[5];
   char SysPassBuff[5];

public:
   bool menuSelection; // Identificador para detectar cuando el sistema se encuentra dentro de cualquier menu.
                       // true = Se ecnuentra en menu, false = Se ha salido del menu.
public:
//   CLogger *intLogger;
   CLogger *loggerSAT;
   //CSatQ1000 *ModemSat;
   CGPRS *ModemGPRS;
   CMPG2 *MPG2;
   //CReloj *Reloj;
   CRTC_3029_I2C *Reloj;
//   CLcd *LCD;
   CLedRGB *RGBLed;
//   CKeyBoard *KBoard;
   CDoor *door;
   CButtonProg *m_btnProg;
   CInputVoltmeter *VLevelBatt;
   CEEPROM *Mem;
public:

  CModule();
  ~CModule();

  void setMenu(char nKey);
//  void exitMenu();
  void setClock(char *Buffer);
  void setClockOnRTC(int *Buffer);
  void parsingTimeZone(char *Buffer);
//  void printLCDDate();
  void setAlarm(char NRegister, char *Buffer);

  void restoreFromEEPROM();
  void saveToEEPROM();

//  bool validateHourKB(char *Buffer);
  void clearBufferKB();
//  bool displayShedule(char noReg);
//  bool displayConfDevice(char noReg);

  char* getSerialNumber();
//  void enterPasswordLCDPromt();

//  bool validateAdressMB_KB(char *Buffer);
//  void displayGSMVar(int nVar);
};
/*********************************************************************/
CModule::~CModule()
{}
/*********************************************************************/
CModule::CModule()
{
  mx=-1;  // Column
  my=-1; // Row
  IDMenu=0;

  sprintf(IDProduct,"%2d",ID_Producto);
  sprintf(NVersion,"%02d",ID_Version);
  strncpy(ProdYear,(char*) Num_ser_flash ,6);
  respIDMenu=IDMenu;
  menuSelection=false;
  strcpy(SysPass,"1956");

  this->Mem=new CEEPROM();

  //this->ModemSat=new CSatQ1000();
  this->ModemGPRS=new CGPRS();
//  this->LCD=new CLcd();
  this->RGBLed=new CLedRGB();
  this->MPG2=new CMPG2();
 // Reloj=new CReloj();
  this->Reloj=new CRTC_3029_I2C(Mem);
//  this->KBoard= new CKeyBoard();
//  this->intLogger=new CLogger();
  this->door=new CDoor();
  this->m_btnProg=new CButtonProg();
  this->VLevelBatt=new CInputVoltmeter();
  this->loggerSAT=new CLogger();

//  this->intLogger->setLimitAddrMem(0x03);
  this->loggerSAT->setLimitAddrMem(0x04);
//  this->intLogger->setPointerWrite(0x000000); // Puntero de inicio de memoria del Logger interno
//  this->loggerSAT->setPointerWrite(0x060000); // Puntero de inicio de memoria para datos satelitales
//  this->intLogger->setDefSampleTime(20);      // Establece tiempo de muestreo en segundos por default 20 seg
//////  this->loggerSAT->setDefSampleTime(&this->KBoard->BufferKB[1]);    // 1800 Establece tiempo de muestreo en segundos por default 1800 seg (30 min)

//  this->ModemSat->disableSendingReport();
  this->restoreFromEEPROM();
  this->MPG2->restartWRPointers();
  this->loggerSAT->clearNData();

}
/*********************************************************************/
const char rootMenuMessages[3][11]={"Sistema","Modem  GSM","Salir"};                              // OK
const char MenuSystem[3][19]={"Conf. Fecha y Hora","Password","Salir"};                           // OK
const char MenuLogger[4][19]={"Ver  Configuracion","Conf. muestreo","Hab. / Deshab.","Salir"};    // OK
const char MenuGSM[4][15]={"Logger GSM","Reportes  GPRS","Conexion  GPRS","Salir"};               // OK
const char MenuGSM_Reports[3][17]={"Ver Horarios","Config. Horarios","Salir"};                    // OK
const char MenuGSM_Connection[3][21]={"Ver Config. Conexion","Seleccionar GSM SP","Salir"};       // OK
const char MenuGSM_VerConn[6][18]={"Proveedor GSM","APN GPRS","Usuario APN GPRS","Password APN GPRS","Conexion DNS","Puerto IP"};       // OK

//const char MenuVarsReport_Devices[7][6]={"Q,V,L"," Q,V "," Q,L ","  Q  "," V,L ","  V  ","  L  "};
const char MenuChgDatemsg[1][15]={"Manual=1",};
const char ServicePass[1][5]={"1518"};

void CModule::setMenu(char nKey)
{
/*
   int myLen;
   char* p_Msg;

   switch(IDMenu)
   {
   case 0: switch(nKey) // Menu principal
          {
          case '*':   // Selección visual del menú principal
                    menuSelection=true;
                    mx++;
                    this->LCD->configLCD();
                    switch(mx)
                    {
                    case 0: my=0x86; break; // "my", indica la posición del primer mensaje en LCD en la primera línea.
                    case 1: my=0x85; break;
                    case 2:
                    default:
                            my=0x87;
                            myLen=strlen(rootMenuMessages[mx]);
                            this->LCD->sendMessage(my,myLen,(char*)rootMenuMessages[mx],0xC1,18,"Sel:*      Enter:#", true);
                            mx=-1;
                            break;
                    }
                    if(mx>-1)
                    {
                      myLen=strlen(rootMenuMessages[mx]);
                      this->LCD->sendMessage(my,myLen,(char*)rootMenuMessages[mx],0xC1,18,"Sel:*      Enter:#", true);
                    }
                    break;
          case '#': // Enter en el menu principal
                    switch(mx)
                    {
                    case 0: IDMenu=1; mx=0;
                            p_Msg=(char*)MenuSystem[mx];
                            myLen=strlen(p_Msg);
                            my=0x81;
                            break;
                    case 1:
                            IDMenu=3; mx=0;
                            p_Msg=(char*)MenuGSM[mx];
                            myLen=strlen(p_Msg);
                            my=0x85;
                            break;
                    case -1:
                    default: this->LCD->configLCD(); this->exitMenu(); break;
                    }
                    if(mx>-1)
                    {
                      this->LCD->sendMessage(my,myLen,p_Msg,0xC1,18,"Sel:*      Enter:#", true);
                    }
                    break;
          default: this->LCD->configLCD();  break;
          }break; // FIN CASE IDMENU=0
///////////////////////////////////////////////////////////////////////////////////////////////////
   case 1: switch(nKey) // Menu de System
          {
          case '*':   // Selección visual del menú principal
                    menuSelection=true;
                    mx++;
                    this->LCD->configLCD();
                    switch(mx)
                    {
                    case 0: my=0x81; break; // "my", indica la posición del primer mensaje en LCD en la primera línea.
                    case 1: my=0x86; break;
                    case 2:
                    default:
                            my=0x87;
                            myLen=strlen(MenuSystem[mx]);
                            this->LCD->sendMessage(my,myLen,(char*)MenuSystem[mx],0xC1,18,"Sel:*      Enter:#", true);
                            mx=-1;
                            break;
                    }
                    if(mx>-1)
                    {
                      myLen=strlen(MenuSystem[mx]);
                      this->LCD->sendMessage(my,myLen,(char*)MenuSystem[mx],0xC1,18,"Sel:*      Enter:#", true);
                    }
                    break;
          case '#': // Enter en el menu de System
                    switch(mx)
                    {
                    case 0: IDMenu=11; mx=0; respIDMenu=IDMenu;  // Cambio de fecha y hora
                            IDMenu=10;
                            this->enterPasswordLCDPromt();
                            break;
                    case 1: IDMenu=12; mx=0; respIDMenu=IDMenu;  // Cambio de password
                            IDMenu=10;
                            this->enterPasswordLCDPromt();
                            break;
                    case -1:
                    default: this->LCD->configLCD(); this->exitMenu(); break;
                    }
                    break;
          default: this->LCD->configLCD();  break; //this->printLCDDate(); break;
          }break; // FIN CASE IDMENU=1
///////////////////////////////////////////////////////////////////////////////////////////////////
///////////////////////////////////////////////////////////////////////////////////////////////////
   case 3: switch(nKey) // Menu de Modem GSM
          {
          case '*':   // Selección visual del menú Modem GSM
                    menuSelection=true;
                    mx++;
                    this->LCD->configLCD();
                    switch(mx)
                    {
                    case 0: my=0x85; break; // "my", indica la posición del primer mensaje en LCD en la primera línea.
                    case 2:
                    case 1: my=0x83; break;
                    case 3:
                    default:
                            my=0x87;
                            myLen=strlen(MenuGSM[mx]);
                            this->LCD->sendMessage(my,myLen,(char*)MenuGSM[mx],0xC1,18,"Sel:*      Enter:#", true);
                            mx=-1;
                            break;
                    }
                    if(mx>-1)
                    {
                      myLen=strlen(MenuGSM[mx]);
                      this->LCD->sendMessage(my,myLen,(char*)MenuGSM[mx],0xC1,18,"Sel:*      Enter:#", true);
                    }
                    break;
          case '#': // Enter en el menu de Modem GSM
                    switch(mx)
                    {
                    case 0: IDMenu=30; mx=0;              // Logger GSM
                            p_Msg=(char*)MenuLogger[mx];
                            myLen=strlen(p_Msg);
                            my=0x81;
                            break;
                    case 1: IDMenu=31; mx=0;              // Reportes GPRS
                            p_Msg=(char*)MenuGSM_Reports[mx];
                            myLen=strlen(p_Msg);
                            my=0x84;
                            break;
                    case 2: IDMenu=32; mx=0;              // Conexion GPRS
                            p_Msg=(char*)MenuGSM_Connection[mx];
                            myLen=strlen(p_Msg);
                            my=0x80;
                            break;
                    case -1:
                    default: this->LCD->configLCD(); this->exitMenu(); break;
                    }
                    if(mx>-1)
                    {
                      this->LCD->sendMessage(my,myLen,p_Msg,0xC1,18,"Sel:*      Enter:#", true);
                    }

                    break;
          default: this->LCD->configLCD();  break;
          }break; // FIN CASE IDMENU=3

///////////////////////////////////////////////////////////////////////////////////////////////////
   case 30: switch(nKey) // Menu de Modem GSM->Logger
          {
          case '*':   // Selección visual del menú Logger
                    menuSelection=true;
                    mx++;
                    this->LCD->configLCD();
                    switch(mx)
                    {
                    case 0: my=0x81; break; // "my", indica la posición del primer mensaje en LCD en la primera línea.
                    case 1:
                    case 2: my=0x83; break;
                    case 3:
                    default:
                            my=0x87;
                            myLen=strlen(MenuLogger[mx]);
                            this->LCD->sendMessage(my,myLen,(char*)MenuLogger[mx],0xC1,18,"Sel:*      Enter:#", true);
                            mx=-1;
                            break;
                    }
                    if(mx>-1)
                    {
                      myLen=strlen(MenuLogger[mx]);
                      this->LCD->sendMessage(my,myLen,(char*)MenuLogger[mx],0xC1,18,"Sel:*      Enter:#", true);
                    }
                    break;
          case '#': // Enter en el menu de Modem Satelital->Logger
                    switch(mx)
                    {
                    case 0: IDMenu=21;         // Vista de tiempos de muestreo y estado del logger GSM
                    this->LCD->sendMessage(0x80,20,"Tiempo DLS: 00:00:00",0xC0,20,"Estado:     Oprima:#", true);
//////                            *(unsigned long int*)&this->KBoard->BufferKB[1]=*this->loggerSAT->getDefSampleTime();
                            mx=*this->loggerSAT->getIndexSampleTime();
                            switch(mx)
                            {
                            case 2:         // Para minutos
                            case 1:
                                    my=0x8F;
                                    break;
                            case 0:         // En caso que sea 0
                                    my=0x92;
                                     break;
                            default:        // Para horas
                                    my=0x8C;
                                    break;
                            }
                            mx=*this->loggerSAT->getTimeLoggerSatByIndex(mx);
                            sprintf((char*)&this->KBoard->BufferKB[0],"%0.2d",mx);
                            if(this->loggerSAT->isEnabledLogg())
                            {this->KBoard->BufferKB[2]='E';}
                            else
                            {this->KBoard->BufferKB[2]='D';}
                            this->LCD->sendMessage(my,2,(char*)&this->KBoard->BufferKB[0],0xC8,1,(char*)&this->KBoard->BufferKB[2],false);
                            my=0;
                            break;
                    case 1: IDMenu=302; mx=0; respIDMenu=IDMenu;  // Cambio de tiempo de recolección logger GSM
                            IDMenu=10;
                            this->enterPasswordLCDPromt();
                            break;
                    case 2: IDMenu=303; mx=0; respIDMenu=IDMenu;  // Habilitación o deshabilitación de logger para reporte satelital
                            IDMenu=10;
                            this->enterPasswordLCDPromt();
                            break;
                    case -1:
                    default: this->LCD->configLCD(); this->exitMenu(); break;
                    }

                    break;
          default: this->LCD->configLCD();  break; //this->printLCDDate(); break;
          }break; // FIN CASE IDMENU=30

///////////////////////////////////////////////////////////////////////////////////////////////////
   case 31: switch(nKey) // Menu de Modem GSM->Reporte
          {
          case '*':   // Selección visual del menú principal
                    menuSelection=true;
                    mx++;
                    this->LCD->configLCD();
                    switch(mx)
                    {
                    case 0: my=0x84; break; // "my", indica la posición del primer mensaje en LCD en la primera línea.
                    case 1: my=0x82; break;
                    case 2:
                    default:
                            my=0x87;
                            myLen=strlen(MenuGSM_Reports[mx]);
                            this->LCD->sendMessage(my,myLen,(char*)MenuGSM_Reports[mx],0xC1,18,"Sel:*      Enter:#", true);
                            mx=-1;
                            break;
                    }
                    if(mx>-1)
                    {
                      myLen=strlen(MenuGSM_Reports[mx]);
                      this->LCD->sendMessage(my,myLen,(char*)MenuGSM_Reports[mx],0xC1,18,"Sel:*      Enter:#", true);
                    }
                    break;
          case '#': // Enter en el menu de Modem GSM->Reporte
                    switch(mx)
                    {
                    case 0: IDMenu=311; my=0;         // Vista de horarios configurados
                            if(this->displayShedule(my))
                            {my++;}
                            else
                            {this->LCD->sendMessage(0x80,19,"No existen horarios",0xC4,12,"Configurados", true);
                             my=4;
                            }
                            break;
                    case 1: IDMenu=312; mx=0; respIDMenu=IDMenu;  // Configurar Horarios de comunicación Satelital
                            IDMenu=10;
                            this->enterPasswordLCDPromt();
                            break;
                    case -1:
                    default: this->LCD->configLCD(); this->exitMenu(); break;
                    }

                    break;
          default: this->LCD->configLCD();  break; //this->printLCDDate(); break;
          }break; // FIN CASE IDMENU=31
///////////////////////////////////////////////////////////////////////////////////////////////////
   case 32: switch(nKey) // Menu de Modem GSM->Conexion
          {
          case '*':   // Selección visual del menú principal
                    menuSelection=true;
                    mx++;
                    this->LCD->configLCD();
                    switch(mx)
                    {
                    case 0: my=0x80; break; // "my", indica la posición del primer mensaje en LCD en la primera línea.
                    case 1: my=0x81; break;
                    case 2:
                    default:
                            my=0x87;
                            myLen=strlen(MenuGSM_Connection[mx]);
                            this->LCD->sendMessage(my,myLen,(char*)MenuGSM_Connection[mx],0xC1,18,"Sel:*      Enter:#", true);
                            mx=-1;
                            break;
                    }
                    if(mx>-1)
                    {
                      myLen=strlen(MenuGSM_Connection[mx]);
                      this->LCD->sendMessage(my,myLen,(char*)MenuGSM_Connection[mx],0xC1,18,"Sel:*      Enter:#", true);
                    }
                    break;
          case '#': // Enter en el menu de Modem GSM->Conexion
                    switch(mx)
                    {
                    case 0: IDMenu=321; my=0; respIDMenu=IDMenu;  // Vista de conf. de Conexión GPRS
                            IDMenu=10;
                            this->enterPasswordLCDPromt();
                            break;
                    case 1: IDMenu=322; mx=0; respIDMenu=IDMenu;  // Configurar Variables de Conexión a servicio GPRS
                            IDMenu=10;
                            this->enterPasswordLCDPromt();
                            break;
                    case -1:
                    default: this->LCD->configLCD(); this->exitMenu(); break;
                    }

                    break;
          default: this->LCD->configLCD();  break; //this->printLCDDate(); break;
          }break; // FIN CASE IDMENU=32

///////////////////////////////////////////////////////////////////////////////////////////////////
  case 10:  // Ingreso y evaluación de password

          switch(nKey)
          {
          case '#':
                  if(this->KBoard->lenDataBuf==4)
                  {
                    this->KBoard->BufferKB[4]='\0';

                    strcpy((char*)&this->SysPassBuff[0],(char*)&ServicePass[0]);
                    this->SysPassBuff[0]--;
                    this->SysPassBuff[1]++;
                    this->SysPassBuff[2]--;
                    this->SysPassBuff[3]++;

                    if(!(strncmp(&this->KBoard->BufferKB[0],(char*)&this->SysPass,4)) || !(strncmp(&this->KBoard->BufferKB[0],(char*)this->SysPassBuff,4)))
                    {
                                            // Envía a menú correpondiente a variables a modificar
                      switch(respIDMenu)
                      {
                      case 11: IDMenu=11; mx=0;
                            myLen=strlen(MenuChgDatemsg[mx]);
                            this->LCD->sendMessage(0x86,myLen,(char*)MenuChgDatemsg[mx],0xC5,10,"Cancelar=2", true);
                            this->LCD->exitLCDEdit();
                            break;
                      case 12: IDMenu=12; mx=0; my=0;
                              this->KBoard->BufferKB[0]=mx;
                              this->KBoard->lenDataBuf=0;
                              this->LCD->sendMessage(0x82,16,"Nuevo Password ?",0xC8,4,"----", true); // menu para actualización de alarmas
                              this->LCD->setAddr(0xC8);
                              this->LCD->setCaracter('-');
                              this->LCD->configLCDEdit();
                              this->LCD->setAddr(0xC8);
                              break;
                      case 302: IDMenu=302; my=1;   // Para seleccionar entre 15, 30 y 60 min
                              switch(*this->MPG2->getNMedidores())
                              {
                              case 4: my=3; mx=2; break;  // Para seleccionar entre 60 min
                              case 3:
                              case 2: my=2;               // Para seleccionar entre 30 y 60 min
                              default: mx=1; break;
                              }
//                              *(unsigned long int*)&this->KBoard->BufferKB[1]=(unsigned long int)*this->loggerSAT->getTimeLoggerSatByIndex(my);
                              this->LCD->sendMessage(0x80,20,"Tiempo:       #:Ent.",0xC1,18,"*:Sel.  4:Cancelar", true); // menu para actualización de alarmas
                              sprintf((char*)&this->KBoard->BufferKB[0],"%2d %s",*this->loggerSAT->getTimeLoggerSatByIndex(my),this->loggerSAT->getTimeUnitsByIndex(mx));
                              this->LCD->sendMessage(0x87,6,&this->KBoard->BufferKB[0],0xC1,0,"", false); // menu para actualización de alarmas
                              this->LCD->configLCDEdit();
                              this->LCD->setAddr(0x88);
                              mx=0;
                              break;
                      case 303: IDMenu=303; mx=0;
                              this->LCD->exitLCDEdit();
                              this->LCD->sendMessage(0x83,17,"Habilitar? #:Ent.",0xC1,18,"*:Sel.  4:Cancelar", true); // menu para actualización de alarmas
                              break;
                      case 312: IDMenu=312; mx=0;
                              this->KBoard->BufferKB[0]=mx;
                              this->LCD->sendMessage(0x80,20,"Horarios:     #:Ent.",0xC1,18,"*:Sel.  4:Cancelar", true); // menu para actualización de alarmas
                              this->LCD->setAddr(0x8B);
                              this->LCD->setCaracter(0x30);
                              this->LCD->configLCDEdit();
                              this->LCD->setAddr(0x8B);
                              break;
                      case 321: IDMenu=321; my=0; mx=0;
                              this->LCD->exitLCDEdit();
                              this->displayGSMVar(my);
                              break;
                      case 322: IDMenu=322; mx=0;
                              this->LCD->exitLCDEdit();
                              this->LCD->sendMessage(0x81,18,"Cambiar Prov. GSM?",0xC1,18,"#:Ent.  4:Cancelar", true); // menu para actualización de alarmas
                              break;

                      default: this->exitMenu();

                      }

                    }
                    else
                    {
                      respIDMenu=IDMenu;
                      this->LCD->exitLCDEdit();
                      this->LCD->sendMessage(0x87,5,"ERROR",0xC0,20,"Password  Incorrecto", true); // menu para actualización de alarmas
                      IDMenu=255;
                    }
                  }
                  break;
          case '*': //IDMenu=0; mx=-1; this->setMenu('#');// Sale de todo el menu
                    // Regreso del cursor
                    this->KBoard->lenDataBuf=0;

                    this->LCD->setAddr(0xC8);
                    this->LCD->setCaracter(0x20);
                    this->LCD->setAddr(0xD1);
                    this->LCD->setCaracter(0x20);
                    this->LCD->setCaracter(0x20);
                    this->LCD->setCaracter(0x20);
                    this->LCD->sendMessage(0xC8,4,"----",0xC9,0,"", false); // menu para actualización de alarmas
                    this->LCD->setAddr(0xC8);

                    break;
          default:  // 1,2,3,4,5,6,7,8,9,0
                      this->KBoard->BufferKB[this->KBoard->lenDataBuf]=nKey;
                      this->LCD->setCaracter('*');
                      this->KBoard->lenDataBuf++;

                      if(this->KBoard->lenDataBuf>=4)
                      {
                        this->KBoard->lenDataBuf=4;
                        this->LCD->setAddr(0x93);
                        this->LCD->setCaracter('#');
                        this->LCD->setAddr(0xD1);
                        this->LCD->setCaracter('O');
                        this->LCD->setCaracter('K');
                        this->LCD->setCaracter('?');
                      }
                    break;
          }
          break; // Fin de  ingreso y evaluación de Password
///////////////////////////////////////////////////////////////////////////////////////////////////
   case 255:  // Ejecuciones cuando existe condición de error
          switch(nKey)
          {
          case '#':
                  switch(respIDMenu)
                  {
                  case 3121: IDMenu=312; mx=this->Reloj->getNAlarms(); break;
                  case 3221: IDMenu=322; mx=*this->MPG2->getNMedidores(); break;
                  case 10:
                  case 12:
                          this->exitMenu(); break;
                  default: break;
                  }
                  this->setMenu('#');
                  break;

          default: break;
          }
          break;
///////////////////////////////////////////////////////////////////////////////////////////////////
   case 11:
          switch(nKey)  // muestra menu de selección del modo de actualización de fecha y hora
          {
          case '1': IDMenu=111; this->KBoard->lenDataBuf=0;
                    this->LCD->sendMessage(0x84,12,"Zona horaria",0xC3,14,"1:+  2:-  + HH", true);
                    this->KBoard->BufferKB[0]='+';
                    this->LCD->configLCDEdit();
                    this->LCD->setAddr(0xCD);
                    break; // Insertar rutina para cambiar la fcha y hora por medio del GPS
          case '2': this->exitMenu(); break; // Sale de todo el menu
          }break;

   ////////////
    case 111:
          switch(nKey)  // muestra menu de selección de Time Zone
          {
          case '#':
                  if(this->KBoard->lenDataBuf<3)
                  {
                    this->LCD->shiftLCDRight();
                    this->KBoard->lenDataBuf++;

                    if(this->KBoard->lenDataBuf==1)
                    {
                      this->LCD->sendMessage(0x80,0,"",0xC3,8,"(00-12) ", false);
                      this->LCD->setAddr(0xCF);
                    }
                    if(this->KBoard->lenDataBuf==3)
                    {
                      this->LCD->setAddr(0x93);
                      this->LCD->setCaracter('#');
                      this->LCD->setAddr(0xD2);
                      this->LCD->setCaracter('O');
                      this->LCD->setCaracter('K');
                    }
                  }
                  else
                  {// Establece los valores selecconados por teclado en el registro del reloj inmerso.
                    IDMenu=1111;
                    //this->exitMenu(); // Sale de todo el menu
                    this->parsingTimeZone(this->KBoard->BufferKB);

                    this->saveToEEPROM();
                    this->clearBufferKB();
                    this->KBoard->lenDataBuf=0;

                    this->LCD->sendMessage(0x81,17,"Fecha: dd/mm/yyyy",0xC2,15,"Hora:  hh:mm:ss", true);
                    this->LCD->configLCDEdit();
                    this->LCD->setAddr(0x88);
                    //this->ModemSat->getTimeDateSat201C();
                  }
                  break;

          case '*': // Regreso de cursor
                      this->KBoard->lenDataBuf--;
                      if(this->KBoard->lenDataBuf<0)
                      {
                         this->KBoard->lenDataBuf=0;
                      }
                      else
                      {
                        this->LCD->shiftLCDLeft();
                        if(this->KBoard->lenDataBuf==0)
                        {
                          this->LCD->sendMessage(0x80,0,"",0xC3,8,"1:+  2:-", false);
                          this->LCD->setAddr(0xCD);
                        }
                        if(this->KBoard->lenDataBuf==2)
                        {
                        this->LCD->setAddr(0x93);
                        this->LCD->setCaracter(0x20);
                        this->LCD->setAddr(0xD2);
                        this->LCD->setCaracter(0x20);
                        this->LCD->setCaracter(0x20);
                        this->LCD->setAddr(0xD0);
                        }
                      }
                      break;
          default:  // 1,2,3,4,5,6,7,8,9,0
                  if(this->KBoard->lenDataBuf<3 && this->KBoard->lenDataBuf>0)
                  {
                    this->KBoard->BufferKB[this->KBoard->lenDataBuf]=nKey;
                    this->LCD->setCaracter(nKey);
                    this->KBoard->lenDataBuf++;

                    if(this->KBoard->lenDataBuf==3)
                    {
                      this->LCD->setAddr(0x93);
                      this->LCD->setCaracter('#');
                      this->LCD->setAddr(0xD2);
                      this->LCD->setCaracter('O');
                      this->LCD->setCaracter('K');
                    }
                  }
                  else
                  {
                    switch(nKey)
                    {
                    case '1': nKey=0x2B; //Caracter +
                              break;
                    case '2': nKey=0x2D; //Caracter -
                    default: break;
                    }

                    if(nKey==0x2B || nKey==0x2D)
                    {
                      this->KBoard->BufferKB[this->KBoard->lenDataBuf]=nKey;
                      this->LCD->setCaracter(nKey);
                      this->LCD->sendMessage(0x80,0,"",0xC3,8,"(00-12) ", false);
                      this->KBoard->lenDataBuf++;
                      this->LCD->setAddr(0xCF);
                    }
                  }
                  break;
          }break;
///////////////////////////////////////////////////////////////////////////////////////////////////
   case 1111:
          switch(nKey)  // Muestra menu de selección del modo de actualización de fecha y hora
          {
          case '#':
                  if(this->KBoard->lenDataBuf<14)
                  {
                    this->LCD->shiftLCDRight();
                    this->KBoard->lenDataBuf++;
                    if(this->KBoard->lenDataBuf==2)
                    {
                      this->LCD->setAddr(0x8B);
                    }
                    if(this->KBoard->lenDataBuf==4)
                    {
                      this->LCD->setAddr(0x8E);
                    }
                    if(this->KBoard->lenDataBuf==8)
                    {
                      this->LCD->setAddr(0xC9);
                    }
                    if(this->KBoard->lenDataBuf==10)
                    {
                      this->LCD->setAddr(0xCC);
                    }
                    if(this->KBoard->lenDataBuf==12)
                    {
                      this->LCD->setAddr(0xCF);
                    }
                    if(this->KBoard->lenDataBuf==14)
                    {
                      this->LCD->setAddr(0x93);
                      this->LCD->setCaracter('#');
                      this->LCD->setAddr(0xD2);
                      this->LCD->setCaracter('O');
                      this->LCD->setCaracter('K');
                    }
                  }
                  else
                  {// Establece los valores selecconados por teclado en el registro del reloj inmerso.

                     this->setClock(this->KBoard->BufferKB);
                     //this->Reloj->startRTCCLK(this->Mem);
                     this->exitMenu(); // Sale de todo el menu
                  }
                  break;

          case '*': // Regreso de cursor
                      this->KBoard->lenDataBuf--;
                      if(this->KBoard->lenDataBuf<0)
                      {
                         this->KBoard->lenDataBuf=0;
                      }
                      else
                      {
                        this->LCD->shiftLCDLeft();
                        if(this->KBoard->lenDataBuf==3)
                        {
                          this->LCD->setAddr(0x8C);
                        }
                        if(this->KBoard->lenDataBuf==1)
                        {
                        this->LCD->setAddr(0x89);
                        }

                        if(this->KBoard->lenDataBuf==7)
                        {
                          this->LCD->setAddr(0x91);
                        }
                        if(this->KBoard->lenDataBuf==9)
                        {
                        this->LCD->setAddr(0xCA);
                        }
                        if(this->KBoard->lenDataBuf==11)
                        {
                        this->LCD->setAddr(0xCD);
                        }
                        if(this->KBoard->lenDataBuf==13)
                        {
                        this->LCD->setAddr(0x93);
                        this->LCD->setCaracter(0x20);
                        this->LCD->setAddr(0xD2);
                        this->LCD->setCaracter(0x20);
                        this->LCD->setCaracter(0x20);
                        this->LCD->setAddr(0xD0);
                        }
                      }
                      break;
          default: //1,2,3,4,5,6,7,8,9,0
                  if(this->KBoard->lenDataBuf<14)
                  {
                    this->KBoard->BufferKB[this->KBoard->lenDataBuf]=nKey;
                    this->LCD->setCaracter(nKey);
                    this->KBoard->lenDataBuf++;
                    if(this->KBoard->lenDataBuf==2)
                    {
                      this->LCD->setAddr(0x8B);
                    }
                    if(this->KBoard->lenDataBuf==4)
                    {
                      this->LCD->setAddr(0x8E);
                    }
                    if(this->KBoard->lenDataBuf==8)
                    {
                      this->LCD->setAddr(0xC9);
                    }
                    if(this->KBoard->lenDataBuf==10)
                    {
                      this->LCD->setAddr(0xCC);
                    }
                    if(this->KBoard->lenDataBuf==12)
                    {
                      this->LCD->setAddr(0xCF);
                    }
                    if(this->KBoard->lenDataBuf==14)
                    {
                      this->LCD->setAddr(0x93);
                      this->LCD->setCaracter('#');
                      this->LCD->setAddr(0xD2);
                      this->LCD->setCaracter('O');
                      this->LCD->setCaracter('K');
                    }
                  }

                  break;
          }break;
///////////////////////////////////////////////////////////////////////////////////////////////////
   case 12:
          switch(nKey)
          {
          case '#':
                  if(this->KBoard->lenDataBuf==4)
                  {
                    this->KBoard->BufferKB[4]='\0';
                    this->SysPassBuff[4]='\0';
                    my++;
                    if(my==1)
                    {
                      this->KBoard->lenDataBuf=0;
                      this->LCD->sendMessage(0x81,18,"Reingrese Password",0xC8,4,"----", true); // menu para actualización de alarmas
                      this->LCD->setAddr(0xC8);
                      this->LCD->setCaracter('-');
                      this->LCD->configLCDEdit();
                      this->LCD->setAddr(0xC8);
                    }
                    else
                    {
                      if(strncmp(&this->KBoard->BufferKB[0],(char*)&this->SysPassBuff,4))
                      {
                        respIDMenu=IDMenu;
                        this->LCD->exitLCDEdit();
                        this->LCD->sendMessage(0x82,16,"ERROR: Passwords",0xC3,14,"NO  Concuerdan", true); // menu para actualización de alarmas
                        IDMenu=255;
                      }
                      else
                      {
                        strcpy(this->SysPass,this->KBoard->BufferKB);
                        this->saveToEEPROM();
                        this->exitMenu();

                      }
                    }

                  }
                  break;
          case '*': //IDMenu=0; mx=-1; this->setMenu('#');// Sale de todo el menu
                    // Regreso del cursor
                    this->KBoard->lenDataBuf=0;

                    this->LCD->setAddr(0xC8);
                    this->LCD->setCaracter(0x20);
                    this->LCD->setAddr(0xD1);
                    this->LCD->setCaracter(0x20);
                    this->LCD->setCaracter(0x20);
                    this->LCD->setCaracter(0x20);
                    this->LCD->sendMessage(0xC8,4,"----",0xC9,0,"", false); // menu para actualización de alarmas
                    this->LCD->setAddr(0xC8);

                    break;
          default:  // 1,2,3,4,5,6,7,8,9,0
                      if(my==0)
                        this->KBoard->BufferKB[this->KBoard->lenDataBuf]=nKey;
                      else
                        this->SysPassBuff[this->KBoard->lenDataBuf]=nKey;

                      this->LCD->setCaracter('*');
                      this->KBoard->lenDataBuf++;
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
